nevenfo/tpA3255-hifi-amplifier/plan.md

# PLAN — Stress-test E2E KiCad MCP — Amplificateur Hi-Fi

## Objectif final

Transformer le cahier des charges en projet KiCad stéréo OPA1612/TPA3255 documenté et aussi fabricable que les preuves disponibles le permettent, principalement via `kicad-control` et son MCP, sans édition directe de `.kicad_sch` ou `.kicad_pcb`.

## Invariants

- Répondre et documenter en français ; préserver exactement noms, erreurs, commandes et chemins.
- Alimentation DC externe uniquement ; aucun secteur 230 V sur le PCB.
- Toute décision critique vient d’une source fabricant actuelle, d’un calcul explicite ou porte `NEEDS_DATA`.
- Toute opération directe sur KiCad appartient exclusivement à `kicad-control`/MCP ; aucun contournement par édition de `.kicad_sch`/`.kicad_pcb`.
- Gate ERC validé explicitement avant tout début de PCB.
- Ne jamais assimiler ERC/DRC à une validation physique de THD+N, SNR, EMI/EMC, thermique ou stabilité réelle.
- Préserver les fichiers utilisateur ; le principal seul possède Git et les checkpoints.

## Critères globaux de réussite

- Statuts séparés : SCHÉMA, PCB, ERC, DRC, CONFORMITÉ DATASHEETS, CRÉDIBILITÉ ÉLECTRONIQUE, AUTONOMIE MCP, PRÊT À FABRIQUER.
- Livrables : projet, schéma, PCB 4 couches, footprints, BOM, ERC, DRC, design review, calculs, hypothèses, limitations, `NEEDS_DATA`, benchmark MCP.
- Métriques MCP uniquement si observées dans l’état live.

# Phase A — Inspection et architecture

## A0 — Établir l’état initial et la continuité

### Objectif

Prouver l’état du workspace, de Git, de KiCad, de l’IPC/API, du MCP et de ses outils avant toute création KiCad.

### Dépendances

Aucune.

### Tâches

- [x] A0.1 Inspecter le workspace et Git sans modification.
- [x] A0.2 Créer `plan.md`, `progress.md` et un rollback Git local.
- [x] A0.3 Sonder KiCad, IPC/API, MCP et outils exposés par des opérations read-only live.
- [x] A0.4 Consigner capacités, observabilité et limitations initiales.

### Validation

Preuves live compactes ; aucune supposition fondée sur une ancienne documentation.

## A1 — Figer l’architecture électronique initiale

### Objectif

Définir architecture, budgets, gains, interfaces, rails, protections, filtres et composants critiques à partir des sources TI et de calculs traçables.

### Dépendances

A0.3.

### Tâches

- [x] A1.1 Vérifier datasheets, EVM et recommandations TI actuelles avec pages/sections.
- [x] A1.2 Établir le schéma-bloc stéréo et le rôle exact de l’OPA1612/volume/interface différentielle.
- [x] A1.3 Calculer niveaux, gains, impédances, headroom, rails et budget de puissance.
- [x] A1.4 Définir alimentation auxiliaire, séquencement, RESET/MUTE/FAULT et protections.
- [x] A1.5 Justifier filtre LC, découplages, thermique, EMI et connectique.
- [x] A1.6 Enregistrer chaque inconnue critique comme `NEEDS_DATA` et valider la revue d’architecture.

### Validation

Chaque connexion/valeur critique est sourcée ou calculée ; architecture cohérente pour 4–8 Ω et ~2 × 100 W/8 Ω.

# Phase B — Schéma KiCad

## B1 — Créer et construire le schéma par blocs

### Objectif

Porter l'architecture A1 dans un schéma KiCad complet, construit bloc par bloc et inspecté à chaque bloc, plutôt que saisi d'un trait puis débogué.

### Dépendances

A1 validée.

### Tâches

- [x] B1.1 Créer le projet via MCP et vérifier sa réouverture.
- [x] B1.2 Ajouter alimentation DC, auxiliaires et connectique.
- [x] B1.3 Ajouter entrée/volume/analogique gauche puis inspecter les nets.
- [x] B1.4 Ajouter entrée/volume/analogique droite puis inspecter les nets.
- [x] B1.5 Ajouter TPA3255, interface différentielle et contrôles puis inspecter les nets.
- [x] B1.6 Ajouter découplages, puissance, filtres LC, sorties et protections.
- [x] B1.7 Revoir références, alimentations, nets critiques et connexions inattendues.

### Validation

Schéma complet inspecté bloc par bloc via la stack et conforme à l’architecture A1.

## B2 — Retouches schématiques issues des décisions mécaniques et de protection

### Objectif

Intégrer au schéma les décisions prises après le gate C1 : déport mécanique des entrées et du volume, et renforcement de la protection d'entrée 48 V.

### Dépendances

C1 PASS ; décisions utilisateur du 2026-08-31 ; sourcing fabricant de la protection 48 V.

### Tâches

- [x] B2.1 Déporter `RV1` hors carte : ajouter un connecteur de volume, recâbler les nets et sortir `RV1` du périmètre PCB. *(Connecteur `J4` créé et nets vérifiés ; exclusion PCB faite en B2.8.)*
- [x] B2.2 Convertir les entrées `J2`/`J3` en connecteur de câblage vers RCA de châssis, avec retour de masse maîtrisé.
- [x] B2.3 Corriger `Q301` : clamp Zener de grille et résistance de grille dimensionnés pour un rail 48 V. L'anti-inversion reste une fonction distincte du hot-swap, la diode de structure d'un MOSFET N côté haut conduisant en inversion.
- [x] B2.4 Dimensionner l'étage `LM5069` sur équations de datasheet : seuils de sous-tension et de surtension avec marge sous le maximum absolu du TPA3255, résistance de shunt, limitation de puissance et temporisateur de défaut. *(Le « 65 V » d'origine était faux : `SLASEA8A` § 7.1 donne **69 V** pour `PVDD_X to GND`. Rectifié en D1.13. L'erreur était conservatrice et n'invalide aucun choix de B2.4 — la marge pire cas passe de 5,1 à 9,2 V.)*
- [x] B2.5 Vérifier la SOA du MOSFET de hot-swap pendant la charge des 15 400 µF, contre la courbe SOA de la référence retenue. *(`Q302` = `IXTK200N10L2`, SOA garantie 625 W à 75 °C contre 389 W exigés, marge 1,61 ×.)*
- [x] B2.6 Capturer le bloc `LM5069` au schéma : contrôleur, MOSFET série, shunt et réseau de programmation.
- [x] B2.8 Exclure `RV1` du circuit imprimé (attribut `on_board` à `no`) et supprimer la propriété parasite `exclude_from_board` laissée sur ce symbole. *(PASS, par le MCP seul. Le blocage consigné ici — aucun outil n'écrivait `on_board` ni ne supprimait une propriété — a été levé dans Konnect v1.1.4 : `edit_schematic_component` accepte désormais `in_bom`, `on_board` et `dnp` comme attributs natifs du bloc symbole, et `fields: {"clé": null}` retire une propriété. La correction a été faite en un appel, `RV1` adressé par `uuid`. Diff du schéma : une ligne changée, `(on_board yes)` en `(on_board no)`, et les dix lignes du `(property "exclude_from_board" "")` supprimées ; rien d'autre dans le fichier n'a bougé. ERC identique avant et après, 0 erreur et 15 avertissements, inchangé depuis la porte C2. Script rejouable : `scripts/live-b28-on-board.ps1` du dépôt Konnect.)*
- [x] B2.7 Figer `F301` et `D301` sur des références réelles, la TVS étant explicitement cantonnée aux transitoires rapides et non à la protection en surtension. *(`F301` = `Schurter UMT-H` 12,5 A `3403.0285.11` ; `D301` = `SMDJ58CA`, bidirectionnelle pour ne pas annuler l'anti-inversion.)*

- [x] B2.9 Figer `Q301` sur une référence réelle : P-MOS bloquant l'inversion à 56 V plus marge, `I_D` ≥ 12 A continus, `R_DS(on)` faible sous `V_GS` = −15 V, boîtier dissipatif. *(`IPP330P10NM`, Infineon OptiMOS TO-220-3, −100 V / 33 mΩ.)*
- [x] B2.10 Corriger le brochage de `Q301` et `Q302` : les symboles `*_GSD` déclaraient broche 2 = Source alors que les deux composants retenus ont broche 2 = Drain. Défaut invisible à l'ERC, fatal au report PCB. *(Passés en `Q_PMOS_GDS` et `Q_NMOS_GDS` ; correctif géométriquement neutre, positions de broches identiques entre variantes.)*

### Validation

Chaque ajout est sourcé sur datasheet ou calculé explicitement ; aucun seuil de sécurité posé de mémoire ; toute grandeur dépendant d'un composant non figé reste `NEEDS_DATA`. Aucune coordonnée existante déplacée ; nets vérifiés par inspection MCP.

# Phase C — Gate schématique

## C1 — ERC et revue schématique obligatoire

### Objectif

Transformer le schéma en gate explicite : tout signalement ERC est classé réel ou admis, et la Phase D reste interdite tant que le verdict n'est pas PASS.

### Dépendances

B1 validée.

### Tâches

- [x] C1.1 Exécuter ERC et archiver le résultat.
- [x] C1.2 Classer chaque erreur/avertissement et corriger les problèmes réels via MCP.
- [x] C1.3 Relancer ERC et vérifier alimentations, nets critiques, découplages et interfaces.
- [x] C1.4 Consigner explicitement PASS/FAIL du gate ; interdire Phase D si FAIL.

### Validation

Gate schématique explicite, reproductible, sans problème réel ERC non traité.

## C2 — Re-gate ERC après B2

### Objectif

Le gate C1 ne couvre plus le schéma une fois B2 appliquée ; le rejouer est obligatoire.

### Dépendances

B2 validée.

### Tâches

- [x] C2.1 Relancer ERC et comparer à la référence du gate C1 : 0 erreur / 14 avertissements.
- [x] C2.2 Traiter tout écart réel, puis consigner explicitement PASS/FAIL ; interdire la reprise de D1 si FAIL. **GATE C2 = PASS** (0 erreur / 15 avertissements : 5 mismatch librairie, 10 off-grid ; `reports/ERC_C2_gate_final-2026-08-31.json`).

### Validation

Gate schématique de nouveau explicite et reproductible sur le schéma modifié.

# Phase D — Footprints

## D1 — Attribuer et valider les empreintes

### Objectif

Donner à chaque symbole une empreinte réelle et vérifiée, condition sans laquelle aucun placement n'a de sens.

### Dépendances

C2 PASS.

### Tâches

- [x] D1.1 Associer chaque composant à une empreinte compatible et disponible. *(PASS. **Plus aucun composant du schéma n'est sans empreinte.** Les cinq `PWR_FLAG` n'en requièrent pas, et `RV1` est volontairement hors carte, voir B2.1 et B2.8. Vérifié en itérant sur les blocs `(symbol` de premier niveau du fichier, et non par le MCP. Toutes les empreintes de librairie ont été contrôlées présentes sur disque.)*
- [x] D1.5 Assigner les passifs du bloc de protection ajoutés en B2. *(PASS. `R305` à `R310`, `C325`, `C326` et `D302` assignés et vérifiés au fichier ; ERC inchangé, 15 warnings et 0 erreur, identique à la porte C2. Trois corrections ont été nécessaires sur le travail initial : la référence `MKS2C044701O00KSSD` de `C325` **n'existe pas**, remplacée par `MKS2B044701K00KSSD` ; son empreinte est passée de `W11.0mm` à `W7.2mm` ; `C326` est passé de `100nF` à `100nF/250V`. `D302` = `BZT52C15` lève son `NEEDS_DATA`. Détail et justifications : `docs/protection-48v.md`, section « Passifs du bloc de protection ».)*
- [x] D1.4 Créer les empreintes locales manquantes et choisir la connectique déportée. *(PASS. Connectique tranchée par l'utilisateur : **JST XH au pas de 2,5 mm**, vertical par défaut, l'orientation définitive relevant du placement en Phase E. `J2` et `J3` en `JST_XH_B2B-XH-A_1x02`, `J4` en `JST_XH_B6B-XH-A_1x06` ; nombre de broches confirmé 2/2/6. Ce qui décide est le détrompage de `J4`, dont le faisceau à six conducteurs rebranché à l'envers donnerait une panne silencieuse. Empreinte locale `Fuse_Schurter_UMT-H_5.3x16mm` créée pour `F301` et cotée sur le dessin d'implantation Schurter ; réserves graphiques suivies en D1.8.)*
- [x] D1.2 Vérifier boîtiers fabricant, orientations, courants, connecteurs et contraintes d’assemblage. *(PASS. **Vérifiés à la source et conformes** : `Q301` `IPP330P10NM`, PG-TO220-3, brochage 1 = Gate / 2 = Drain-semelle / 3 = Source, datasheet servie par le serveur Infineon, chiffres thermiques relus et deux conditions d'implantation ajoutées à `docs/protection-48v.md` ; `Q302` en TO-264-3 au pas de 5,45 mm et `Q301` en TO-220-3 au pas de 2,54 mm, les deux empreintes KiCad étant aux pas normalisés, l'orientation verticale restant compatible d'un montage sur radiateur et le choix définitif dépendant du `NEEDS_DATA` dissipateur ; `U8` `LM5069-2` en `MSOP-10_3x3mm_P0.5mm`, correct — la datasheet TI ne donne le composant qu'en VSSOP-10 (DGS) 3 × 3 mm **sans pad exposé**, et KiCad n'a pas d'empreinte `VSSOP-10`, l'équivalent normalisé étant bien MO-187 variation BA. À noter pour H2 : la référence commandable est `LM5069MM-2/NOPB`, absente du schéma. **Défauts ouverts issus de cette tâche** : D1.9 (films 680 nF) et D1.10 (inductances). **Bulks instruits en D1.11, inductances en D1.10, films en D1.9.** **Dernier point clos : le bornier `J1`.** Le dessin fabricant de CIXI MAIXU (`MX126-5.0-XXP`, planche du 14/09/2022) a fini par être obtenu : `www.lcsc.com` et `datasheet.lcsc.com` refusent `curl`, mais **`wmsc.lcsc.com` sert le fichier**. Il n'a aucune couche texte — c'est un plan vectoriel sans texte extractible — et `pdftoppm` n'est pas installé ; il a donc été **rendu en PNG à 200 dpi par `pymupdf` puis lu comme une image**. Il donne **300 V / 10 A en calibre UL et 250 V / 15 A en calibre IEC**, tenue 2000 VAC pendant 1 min, plage de fil **26 à 14 AWG, soit 0,5 à 2,5 mm²**, service de −40 à +105 °C. Les 4,6 A continus passent avec un facteur 2,2 sur le calibre UL, et les 10 A transitoires restent sous le calibre IEC. **L'empreinte est confirmée à la source** : le plan d'implantation impose un perçage de ø1,30 mm au pas de 5,00 mm, ce que `TerminalBlock_MaiXu_MX126-5.0-02P_1x02_P5.00mm` reprend exactement. **Contrainte d'assemblage à porter** : le câble d'alimentation doit rester entre 0,5 et 2,5 mm².)*
- [x] D1.6 Corriger l'annotation des cinq `PWR_FLAG`. *(PASS. Annotés `#FLG01` à `#FLG05` ; `#PWR001`, sixième `PWR_FLAG` préexistant, non touché. Plus aucun symbole ne porte `?`. **Le MCP sait adresser un symbole par `uuid`**, paramètre alternatif à `reference` d'`edit_schematic_component` : c'est ce qui a levé l'ambiguïté des cinq repères identiques. Le défaut était plus grave que consigné : les `PWR_FLAG` non annotés étaient exportés au netlist comme **six composants réels nommés `?`**, que « Update PCB from schematic » aurait tenté de placer sur la carte, sans empreinte. Après correction ils en sont exclus, comme tout symbole à préfixe `#`. Preuve : netlist exporté avant et après, 74 nets inchangés, aucun net créé ni supprimé, et les seuls nœuds retirés sont les cinq `?.1` sur `/+12V-OA`, `/PVDD`, `/GND`, `/+15V` et `/BUCK_VIN` ; ERC inchangé à 15 warnings et 0 erreur, et `kicad-cli` ne signale plus « erreurs de numérotation ».)*
- [x] D1.7 Confirmer sur le dessin coté WIMA l'encombrement du film `C325`. *(PASS, et **la réserve était fondée deux fois : la cote supposée était fausse, et la référence l'était aussi.** Catalogue WIMA extrait et lu : au pas de 5 mm, la cote constante de la série MKS2 est la **longueur** `L` = 7,2 mm, jamais l'épaisseur ; les tableaux donnent les boîtes en `W × H × L` et le 4,7 µF mesure `W` = 11 mm, `H` = 18 mm, `L` = 7,2 mm, sous 63 V comme sous 100 V. L'empreinte était donc trop étroite de 3,8 mm et le composant n'y serait pas entré. Le décodage de la clé de référence WIMA a de plus retourné la conclusion de D1.5 : **les champs 11-12 codent la boîte et le pas, le champ 15 seul code la tolérance.** Le `O` de `MKS2C044701O00KSSD` appartient au code de boîte `1O` et n'a jamais été un code de tolérance. La référence écartée en D1.5 comme inventée est donc la bonne, et c'est sa remplaçante qui n'existe pas : `MKS2B044701K00KSSD` cumule un `B0` qui n'est pas un code de tension WIMA — la MKS2 va de 63 à 630 VDC sans aucun calibre 50 V — et une boîte `1K` de 7,2 × 13 mm qui ne loge que 2,2 µF. `C325` reprend `MKS2C044701O00KSSD`, Value `4.7uF/63V`, empreinte `Capacitor_THT:C_Rect_L7.2mm_W11.0mm_P5.00mm_FKS2_FKP2_MKS2_MKP2` de la librairie standard — aucune empreinte locale nécessaire. Écriture MCP relue au fichier par le principal, position inchangée, ERC toujours à 15 warnings et 0 erreur. La marge de démarrage × 1,41 est conservée : le ± 10 % est catalogué, seule la tension nominale passe de 50 à 63 V. Détail : `docs/protection-48v.md`.)*
- [x] D1.9 Qualifier les quatre films `680 nF` du filtre de sortie, puis corriger leur empreinte. *(PASS. **Le pas de 5 mm était faux autant que l'épaisseur.** La nomenclature du `TPA3255EVM` (`SLOU441`, p. 14) tranche d'abord le diélectrique : l'EVM équipe ce poste d'un **`PHE426HB7100JR06` KEMET, film polypropylène, 1 µF / 250 V au pas de 17,5 mm**. Le catalogue WIMA `MKP4` a ensuite été extrait et lu : il **contredit l'idée qu'un MKP n'existerait pas sous 250 V** — la série se catalogue dès 100 VDC — et donne pour 0,68 µF **une boîte `4F` de 8 × 15 × 18 mm au pas de 15 mm, identique en 100 et en 250 VDC**, références `MKP4D036804F00` et `MKP4F036804F00`. Le calibre supérieur étant sans coût mécanique, **250 V retenu** : la marge sur les 100 V exigés par TI est gratuite. Les quatre condensateurs passent à `Capacitor_THT:C_Rect_L18.0mm_W8.0mm_P15.00mm_FKS3_FKP3` — empreinte de la librairie standard dont la description renvoie elle-même au catalogue WIMA — et leur `Value` à `680nF/250V MKP`. Écriture MCP relue au fichier par le principal, positions inchangées, ERC toujours à 15 violations et 0 erreur, jeu de messages identique. **Le choix de 680 nF face au 1 µF de l'EVM est confirmé sain** : avec 15 µH il donne 49,8 kHz de coupure contre 50,3 kHz pour le couple 10 µH / 1 µF de l'EVM, pour une impédance caractéristique de 4,7 Ω au lieu de 3,16 — mieux adaptée à des charges de 4 à 8 Ω. Les quatre derniers caractères de la référence WIMA, tolérance et conditionnement, restent à figer en H2 : la clé n'a pas été relue pour cette série. **L'empreinte locale `CF_Film_Box_P5.00mm_7.2x3.5mm`, devenue sans utilisateur, est supprimée** ; la librairie locale ne contient plus que le fusible et son entrée `fp-lib-table` reste justifiée. **Contrainte Phase E : la boîte passe de 7,2 × 3,5 à 18 × 8 mm sur 15 de haut, courtyard de 18,5 × 8,5 mm, quatre fois.**)* **Défaut prouvé, même mode de défaillance que D1.7 : une cote supposée, jamais lue.** `C321` à `C324` portent `CF_Film_Box_P5.00mm_7.2x3.5mm`, soit 3,5 mm d'épaisseur de corps. Or le condensateur de filtre est référencé à `GND` en aval de chaque demi-pont et voit donc tout le rail, et TI exige explicitement un calibre 100 V pour une alimentation de 51 V. Au pas de 5 mm, une boîte de 3,5 mm ne loge que 0,15 à 0,22 µF sous 100 V ; le 680 nF sous 100 V mesure 5 × 10 × 7,2 mm. L'empreinte est donc impossible quelle que soit la référence finalement retenue. **Ne pas la remplacer par une nouvelle supposition** : la référence reste `NEEDS_DATA`, et le diélectrique est le premier point à trancher — un filtre de sortie Class-D relève du polypropylène (MKP) et non du polyester (MKS), pour le `dV/dt` et les pertes, ce qui peut aussi déplacer le pas. Une fois la référence figée, prendre le membre correspondant de la famille standard `Capacitor_THT:C_Rect_L7.2mm_W*_P5.00mm_FKS2_FKP2_MKS2_MKP2`, qui couvre 2,5 à 11 mm d'épaisseur.
- [x] D1.8 Corriger les graphiques de l'empreinte locale du fusible. **Volet film clos en D1.9** : l'empreinte locale redondante a été supprimée, il ne reste que le défaut cosmétique du fusible. **Périmètre réduit, et le point ne demande plus d'arbitrage utilisateur pour que le projet avance.**
  - `CF_Film_Box_P5.00mm_7.2x3.5mm` **sort du périmètre**. La librairie KiCad standard contient déjà `C_Rect_L7.2mm_W3.5mm_P5.00mm_FKS2_FKP2_MKS2_MKP2` — même corps 7,2 × 3,5 mm au pas de 5 mm, courtyard correct de 7,7 × 4,0 mm là où le local n'en déclare que 7,6 × 2,6. L'empreinte locale était donc **redondante dès sa création**, et le courtyard sous-dimensionné n'a jamais eu à être corrigé, seulement abandonné. Elle n'a plus d'utilisateur légitime (D1.9) et sera supprimée à la fermeture de D1.9, sans aucune édition de graphiques.
  - `Fuse_Schurter_UMT-H_5.3x16mm` reste locale et justifiée : le seul candidat standard, `Fuse:Fuse_Schurter_UMT250`, vise un corps de 3 × 10,1 mm avec pastilles à ± 4,25 mm, sans rapport avec les ± 6,875 mm du UMT-H. Son défaut résiduel est **purement cosmétique** — repère de broche 1 sur un composant non polarisé, cercle de sérigraphie hors courtyard à `x = −9,3`, sérigraphie à 0,15 mm des pastilles au lieu de 0,2 — alors que cuivre, pâte, masque et courtyard sont exacts. Sans effet sur le DRC ni sur la fabrication. Reporté sans blocage, à traiter si une version du MCP expose l'édition des graphiques. — **PASS.** Le report n'avait plus lieu d'être : **l'outil `set_footprint_graphics` existe bel et bien** dans le MCP, et la note « aucun outil n'édite les graphiques après coup » était fausse. Deux défauts corrigés : le repère de broche 1, supprimé, qui n'avait pas de sens sur un composant non polarisé et tombait de surcroît hors courtyard à `x = −9,3` ; et la sérigraphie, qui encadrait l'**enveloppe des pastilles** au lieu du **corps**, ramenée à deux segments horizontaux `x ∈ [−4,70 ; 4,70]` à `y = ±2,675`. Le `F.Fab` suit désormais le corps réel `±7,70 × ±2,675`, sans le chanfrein de broche 1. **Vérifié au fichier par le principal, pas sur rapport d'agent** : dégagement sérigraphie-pastille de **0,240 mm** contre 0,20 exigés par les KLC, aucun élément hors courtyard `±9,00 × ±3,05`, pastilles / pâte / masque / courtyard / `descr` rigoureusement inchangés, champ Footprint de `F301` intact. **Preuve indépendante du MCP** : `kicad-cli fp export svg` trace les deux empreintes locales sans avertissement.

  - **Nuance sur la leçon D1.10, qui ne se généralise pas.** Donner au générateur les cotes justes du corps a corrigé le `F.Fab` mais **pas** la sérigraphie : `create_footprint` la dérive de l'enveloppe des pastilles, laquelle déborde ici le corps de 1,05 mm de chaque côté puisque les pastilles dépassent en bout pour le congé. Sur une empreinte dont les pastilles sont plus larges que le corps, le générateur produit donc une sérigraphie non conforme quelles que soient les cotes fournies, et il faut la reprendre par `set_footprint_graphics`.
- [x] D1.11 Requalifier les six condensateurs de bulk. *(PASS. **Défaut prouvé et corrigé sur `C312` à `C315`, empreinte validée sur `C316`/`C317`.** Source primaire : la nomenclature du kit d'évaluation TI `TPA3255EVM` (`SLOU441`, p. 14), qui est l'ancre déclarée du bulk dans `docs/architecture.md`.*
  - *`C312` à `C315`, 1500 µF/63 V : la BOM donne pour ce poste `EEU-FC1J152` Panasonic, boîtier **diamètre 18 mm**. L'empreinte portée était `CP_Radial_D16.0mm_P7.50mm`, soit **2 mm de trop peu en diamètre**, quatrième empreinte posée sur une cote supposée après D1.7, D1.9 et D1.10. Corrigée en `Capacitor_THT:CP_Radial_D18.0mm_P7.50mm`, membre de la librairie standard, pas inchangé à 7,5 mm. Écriture MCP relue au fichier par le principal, positions inchangées, ERC inchangé à 15 violations et 0 erreur. Le courtyard passe de 16,16 à 18,16 mm : **+2 mm sur chacun des quatre**, à reporter en Phase E. Hauteur nominale 35 mm.*
  - *`C316`/`C317`, 4700 µF/80 V : empreinte `CP_Radial_D35.0mm_P10.00mm_SnapIn` **confirmée juste**, par trois preuves indépendantes. La BOM donne `SLPX472M080H3P3` Cornell Dubilier en « D35 mm × L30 » ; la clé de référence CDE type SLP, décodée sur le catalogue `SLP.pdf` p. 2 (lettre de diamètre H = 35 mm, chiffre de longueur 3 = 30 mm), redonne bien ø35 × 30 ; et le diagramme « PC Board Mounting Holes » du même catalogue impose **pas 10,0 mm et deux perçages ø2,0 ± 0,1**, identiques au diagramme Vishay 058 PLL-SI. **Le perçage de 2,0 mm de l'empreinte KiCad n'est donc pas un jeu nul sur une broche de 2,0 mm : c'est la cote de perçage prescrite par les deux fabricants**, et toute la famille `CP_Radial_D*_P10.00mm_SnapIn` la reprend.*
  - *Deux réserves consignées, aucune bloquante. Le pas de 7,5 mm du ø18 n'a pas pu être relu chez Panasonic : `industrial.panasonic.com` ne répond pas du tout à `curl` (timeout, pas un refus). Il est **inchangé** par rapport à l'empreinte précédente, donc la correction ne substitue pas une supposition à une autre, mais il reste à confirmer. Et `SLPX472M080H3P3` n'apparaît pas dans le catalogue SLP courant, qui donne à 80 V `SLP472M080E4P3` en 30 × 45 et `SLP472M080H5P3` en 35 × 35 : `SLPX` est une série voisine ou antérieure. **Les deux MPN restent des candidats d'ancrage et ne sont pas inscrits au schéma** tant que la clé du fabricant n'est pas décodée, conformément à la leçon de D1.7.*

- [x] D1.10 Requalifier l'empreinte des quatre inductances de sortie `L301` à `L304`. *(PASS, **et la réserve énergétique était fondée**. La BOM du `TPA3255EVM` donne `MA5172-AE` Coilcraft pour ce poste, et sa datasheet — document Coilcraft 943, `https://www.coilcraft.com/pdfs/ma5172.pdf` — catalogue dans la même famille **`PA6331-AE` : 15 µH, DCR 31 mΩ, `I_sat` 20 A, `I_rms` 9,8 A à 20 °C d'échauffement et 14,2 A à 40 °C**, soit exactement le cahier des charges de `docs/architecture.md`, sur une pièce conçue pour les étages Class-D TI. **Retenue sur arbitrage utilisateur.** Elle confirme au passage que le `HCI-1350` était hors de cause : là où le boîtier supposé mesurait 12,8 × 12,8 × 4,7 mm, la pièce réelle est un **tore traversant debout de ø28,6 × 12,3 mm**. **Le tracé de la datasheet n'est pas à l'échelle** : mesuré sur les vecteurs du PDF, la vue de face donne 2,836 pt/mm et la vue de profil 2,463, 15 % d'écart ; les étiquettes font foi, comme chez Schurter. Elles donnent un entraxe de **10,0 ± 0,5 mm** et des broches de 0,96 à 1,07 mm. **Aucune empreinte standard ne convient** : `L_Toroid_Vertical_L28.6mm_W14.3mm_P11.43mm_Bourns_5700` a la bonne longueur mais un entraxe de 11,43 mm, hors tolérance de 1,43 mm ; `L_Toroid_Vertical_L26.7mm_W14.0mm_P10.16mm_Pulse_D` a le bon pas mais un courtyard trop court de 1,9 mm. **Deuxième empreinte locale justifiée du projet** : `L_Toroid_Vertical_L28.6mm_W12.3mm_P10.00mm_Coilcraft_PA6331`, créée par le MCP et **relue au fichier par le principal**. Contrairement à `CF_Film_Box`, les graphiques imposés par `create_footprint` sont **corrects** : courtyard à ± 14,55 en X et − 1,55 à 11,55 en Y, soit 0,25 mm autour de l'élément le plus extérieur — les pastilles, non le corps — et sérigraphie à 0,15 mm hors du corps, sans recouvrir les pastilles. Ce sont les conventions KLC, et elles valent mieux que les cotes plus grossières que le principal avait commandées. **La leçon de `CF_Film_Box` se précise : le générateur n'était pas en cause, les cotes qu'on lui donnait l'étaient.** `Value` portée à `15uH/20A`, ERC toujours à 15 violations et 0 erreur. Le `NEEDS_DATA` sur l'inductance tombe. Reste à vérifier en H2 que la référence est toujours approvisionnable.)* Elles portent `Inductor_SMD:L_Wuerth_HCI-1350` **sans MPN**, alors que l'inductance 15 µH est `NEEDS_DATA` : troisième empreinte posée sur une supposition, après D1.7 et D1.9. Le corps HCI-1350 ne fait que 12,8 × 12,8 × 4,7 mm. Point de mesure lu à la source, sur la référence même que cite l'empreinte KiCad (`744355019`) : dans ce corps, la série donne 0,19 µH à `I_SAT,10%` = 60 A, soit une énergie stockée de 342 µJ. Or le cahier des charges — 15 µH avec `I_sat` ≥ 10 A — en réclame 750 µJ, plus du double. L'énergie étant d'abord une propriété du volume et du matériau de noyau, **le boîtier 1350 est très probablement trop petit** ; c'est une déduction sur un seul point de mesure, à confirmer quand la référence sera figée, mais elle suffit à ne pas traiter cette empreinte comme acquise. Prévoir un corps plus grand et son impact sur le placement en Phase E.
- [x] D1.12 Rendre `fp-lib-table` portable. *(PASS. La librairie locale y était déclarée par un **chemin absolu Windows**, `C:\Users\FlowUP\Documents\...` : un clone du dépôt sur une autre machine, ou un simple déplacement du projet, aurait cassé la résolution des deux empreintes locales sans avertissement. Remplacé par `${KIPRJMOD}/HifiAmp_TPA3255_Local.pretty`. **`sym-lib-table` utilisait déjà `${KIPRJMOD}`** : la convention du projet était donc établie et l'incohérence isolée à ce seul fichier. Que KiCad résolve bien cette variable dans ce projet est prouvé par l'ERC lui-même, qui charge le symbole local `LM5069` déclaré de la même façon. Sauvegarde de l'original conservée le temps de la session.)*
- [x] D1.3 Vérifier particulièrement HTSSOP TPA3255, PowerPAD et stratégie de vias thermiques. *(PASS, **et la tâche se retourne : il n'y a pas de vias thermiques à concevoir sous le TPA3255**. `U6` portait `HTSSOP-44-1EP_6.1x14mm_P0.635mm_EP5.2x14mm_Mask4.31x8.26mm`, **empreinte d'un autre boîtier** : elle est taguée `Texas_DDW0044B` et pose une 45ᵉ pastille de 5,2 × 14 mm **sous** le composant. Or le TPA3255 est en `DDV0044D`, et la datasheet (`SLASEA8A`, p. 3) est explicite : *« The package type contains a PowerPAD that is located **on the top side of the device** for convenient thermal coupling to the heat sink »*. Le tableau des broches ajoute, pour le PowerPAD : *« Ground, connect to grounded heat sink »*. Le plan cothé (4218830/A, p. 44) donne un pad exposé de **6,72 à 7,30 mm sur 3,85 à 4,43 mm**, soit 7,01 × 4,14 nominal — et non 5,2 × 14 — tandis que le land pattern TI (p. 45) ne montre que **44 pastilles**, sans rien à braser dessous. Corrigé en `Package_SO:HTSSOP-44_6.1x14mm_P0.635mm_TopEP4.14x7.01mm`, taguée `Texas_DDV0044D`, 44 pastilles, pad thermique dessiné sur le dessus aux cotes nominales exactes. Écriture MCP relue au fichier par le principal, ERC toujours à 15 violations et 0 erreur. **La preuve chiffrée vient du tableau thermique 7.4 : `RθJC(bot)` est donné `n/a`** — TI ne caractérise même pas la voie par le dessous — alors que `RθJA` tombe de **50,7 à 2,4 °C/W** dès qu'un dissipateur est fixé sur le dessus, facteur 21, la note précisant que *« only path for dissipation is to the heatsink »*. **Le `NEEDS_DATA` annonçant un EP de 5,2 × 14 mm à confirmer est donc infirmé, pas confirmé**, et le `NEEDS_DATA` dissipateur devient le point dimensionnant unique du thermique du TPA3255. **Écart connu et voulu à reporter en Phase E** : le symbole compte 45 broches, la broche 45 étant `EP_45` câblée à `GND` — ce qui est correct au sens de TI — alors que l'empreinte n'a que 44 pastilles. L'import PCB signalera une broche sans pastille : c'est **attendu**, la mise à la masse du PowerPAD passant par le dissipateur, hors PCB. Au passage, le tableau des conditions recommandées confirme `L_OUT(BTL)` ≥ 5 µH, que les 15 µH de D1.10 satisfont largement.)*

- [x] D1.13 Trancher la fenêtre de tension où le TPA3255 travaille hors spécification. **Relevé en D1.3, non instruit.** Le tableau des conditions recommandées distingue deux plafonds selon la charge : `PVDD` va jusqu'à **51 V typique et 53,5 V maximum sous 4 Ω**, mais jusqu'à 53,5 V typique et 56,5 V maximum sous ≥ 6 Ω, et seulement *« provided a reduced over-current threshold is set »*. Or le projet vise **4 à 8 Ω**, et le seuil de coupure haute du `LM5069` est réglé à **56,4 V** (`docs/protection-48v.md`). **Il existe donc une fenêtre de 53,5 à 56,4 V dans laquelle une charge de 4 Ω est alimentée au-dessus du maximum absolu du TPA3255 sans que la protection ne coupe.** Le raisonnement actuel — le plafond n'est pas fixé par le TPA3255 puisque `Q302` l'isole en surtension — ne couvre pas cette bande. Trois issues à peser : abaisser `V_OVH` vers 52 V, restreindre la charge admissible à ≥ 6 Ω, ou démontrer que l'alimentation externe retenue ne peut pas atteindre 53,5 V. **Dépend du `NEEDS_DATA` alimentation externe 48 V.** Arbitrage utilisateur probable. — **CLOS.** Deux rectifications d'abord : 53,5 V est une borne de *conditions recommandées* et non un maximum absolu, le maximum absolu `PVDD_X to GND` valant **69 V** (`SLASEA8A` § 7.1) et non les 65 V écrits dans `docs/protection-48v.md`, désormais corrigés ; et la bande incriminée se situe donc **12,6 V sous la destruction**, la limite franchie portant sur le courant de sortie, pas sur la tenue en tension. Ensuite, **l'issue « abaisser `V_OVH` » est arithmétiquement impossible** : garantir ≤ 53,5 V au pire cas impose un nominal ≤ 50,5 V, dont la borne basse tombe à 49,5 V — sous les 50,4 V d'un rail 48 V à +5 % — et dont la reprise, hystérésis déduite, tomberait entre 43,8 et 47,2 V, empêchant tout redémarrage ; la fenêtre à couvrir vaut ± 3 % contre ± 6 % de dispersion spécifiée du seuil. **Le `LM5069` ne peut donc pas faire respecter les conditions recommandées du TPA3255**, seulement protéger d'un défaut d'alimentation. **Issue retenue sur arbitrage utilisateur : borner l'alimentation par spécification, charge 4 Ω conservée, aucun composant modifié.** Exigence `REQ-PSU-1` inscrite dans `docs/architecture.md` : sortie ≤ 53,5 V en toutes conditions, soit 3,1 V de marge pour une alimentation régulée à ± 5 %. Résidu assumé et tracé : une panne d'alimentation dans la bande 53,5–56,4 V ne serait coupée par rien, l'`OCP` en CB3C et l'`OTW`/`OTSD` restant seuls actifs.
- [x] D1.14 Instruire les cinq `lib_symbol_mismatch` et les symboles reliquats. *(PASS. **Diagnostic livré, et il est rassurant : aucun écart de brochage.** Les deux copies de chacun des cinq symboles — celle du cache `lib_symbols` du schéma et celle du `.kicad_sym` — ont été comparées par **égalité d'arbre S-expression**, après neutralisation du seul nom racine, qui porte le préfixe de librairie dans le cache. Résultat : `LM5010ASD` 330 feuilles, `LM2940IMP_12_FIXED` 169, `TPS3802K33` 192, `LM5069` 307, `TPA3255B` 1112 — **identiques des deux côtés, feuille à feuille**. Numéros, noms, types électriques et positions de broches concordent. **Aucune vérification antérieure n'est donc remise en cause**, ce qui était la question de fond. L'avertissement ne porte sur aucune divergence de contenu entre les deux fichiers. **Piste de la version de format testée et infirmée** : le schéma est en `20250610` et la librairie en `20240108`, toutes deux écrites par `konnect` ; migrer une copie de la librairie par `kicad-cli sym upgrade --force` — KiCad y ajoute `exclude_from_sim`, `in_pos_files`, `show_name`, normalise `Datasheet` de `~` à vide, et la taille passe de 17 744 à 28 263 octets, les 6 symboles et 79 broches étant conservés — puis relancer l'ERC laisse **exactement les mêmes 15 violations**. La copie migrée a donc été abandonnée et la librairie restaurée par `git checkout`. **Conclusion : les cinq avertissements sont cosmétiques et restent dans la baseline C2**, qui demeure à 15 violations et 0 erreur. Une dernière piste existe — faire réécrire le cache du schéma lui-même par KiCad — mais elle fait passer un outil de migration sur le cœur du projet, dont la connectivité repose sur la coïncidence label/ancre, pour un gain purement cosmétique : **non retenue sans arbitrage utilisateur**. **Reliquats confirmés inutilisés** : `TPA3255DDV`, `TPA3255DDV_TEST` et `TPA3255` dans le cache, `LM2940IMP-12` dans la librairie, **zéro `lib_id` les référençant**, quand les cinq symboles utiles ont exactement une instance chacun. Ils ne sont pas supprimés : retirer des entrées du cache demanderait d'éditer directement le `.kicad_sch`, et KiCad les nettoie de lui-même à la première sauvegarde depuis l'interface.)* **Relevé en D1.3.** Les cinq avertissements sont un tiers de la baseline C2 et portent tous sur des symboles de la librairie locale : `LM5010ASD`, `LM2940IMP_12_FIXED`, `TPS3802K33`, `LM5069`, `TPA3255B`. Un `lib_symbol_mismatch` signifie que la copie embarquée dans le schéma diverge de la librairie ; **l'écart peut être anodin, un champ de propriété, ou grave, un brochage** — ce n'est pas tranché, donc la baseline repose sur cinq inconnues. À diagnostiquer symbole par symbole, en comparant broche à broche. Deux reliquats à traiter dans le même mouvement : le cache `lib_symbols` du schéma contient encore `TPA3255DDV`, `TPA3255DDV_TEST` — deux broches, manifestement un essai — et `TPA3255`, **qui n'existent plus dans le `.kicad_sym`** et que plus aucun composant n'utilise ; et la librairie garde `LM2940IMP-12` alors que `U2` est passé à `LM2940IMP_12_FIXED`. Ne rien supprimer avant d'avoir montré qu'aucun symbole n'y renvoie.

### Validation

Toutes les empreintes sont attribuées et revues contre leurs sources fabricant.

# Phase E — PCB 4 couches

## E1 — Définir stack-up, règles et placement

### Objectif

Fixer la matière de la carte — quatre couches, règles, classes de nets — puis y poser les composants dans l'ordre où les contraintes physiques les imposent : puissance et thermique d'abord, analogique bas niveau ensuite.

### Dépendances

D1 validée.

### Tâches

- [x] E1.1 Créer le PCB 4 couches et documenter stack-up/règles/classes de nets. *(PASS. Quatre couches cuivre — `F.Cu` signal, `In1.Cu` power, `In2.Cu` mixed, `B.Cu` signal — sur une carte de 1,6 mm. Huit classes de nets et **71 affectations**, sans doublon, dimensionnées sur IPC-2221 à 35 µm et 10 °C d'échauffement. Règles globales conservatrices, le fabricant n'étant pas choisi : 0,20 mm de piste et d'isolation, via ø0,60, perçage 0,30, anneau 0,15. **Contour de carte délibérément non tracé** : il dépend du dissipateur et du boîtier, encore en `NEEDS_DATA`. **Vérifié par le principal au fichier** : les quatre couches sont là, le bloc `setup` ne contient que `pad_to_mask_clearance`, zéro empreinte, `Edge.Cuts` vide, et `kicad-cli pcb drc` charge le fichier en ne remontant que `invalid_outline` — l'absence de contour, donc la condition voulue. Détail des classes : `docs/architecture.md`, section « Règles et classes de nets posées en E1.1 ».)*
  - **Incident MCP, consigné dans `reports/MCP_BUG-setup-tokens-kicad-pcb.md`.** `set_design_rules` écrit `min_clearance`, `min_track_width`, `min_via_drill` et `min_via_size` dans le bloc `(setup ...)` du `.kicad_pcb`, où ces jetons **n'existent pas** dans le format ; `set_active_layer` y ajoute `active_layer`, tout aussi invalide. Le fichier devient illisible par KiCad — *« Inattendu active_layer en ligne 32 »* — **sans qu'aucun retour d'outil ne signale l'échec**, et aucun des 203 outils du MCP ne sait nettoyer le bloc. Récupéré par `git checkout` du seul `.kicad_pcb`, sans risque puisqu'il était vide de toute connectivité. **Ces deux outils sont désormais proscrits sur ce projet** ; les règles globales se posent dans le `.kicad_pro`, sous `board.design_settings.rules`, où `set_design_rules` n'avait appliqué que deux des quatre valeurs demandées.
  - **Réserve reportée** : aucun outil MCP n'expose l'épaisseur de cuivre par couche. Le `.kicad_pcb` ne porte pas de bloc `stackup` explicite et KiCad applique son défaut. À rendre explicite dans Board Setup et sur la commande au fabricant avant les livrables de fabrication.
- [x] E1.2 Placer puissance Class-D, bootstrap/découplages/bulk et thermique. *(PASS. Le placement des 21 empreintes de puissance est clos par les deux perçages M3 de fixation de la barre, H1 en `(285, 163)` et H2 en `(285, 187)`, entraxe 24 mm, motif validé par l'utilisateur avant perçage.)*
  - **Débloquée.** Les trois arbitrages de E1.7 sont rendus et consignés dans `docs/architecture.md`, section « Arbitrages rendus, et contour qui en découle » : coffret Modushop `03/300` 3U, carte à plat avec `U6` en bord de carte relié au flanc par une barre aluminium courte et massive, isolation électrique reportée à la jonction barre/flanc. Contour arrêté à **200 × 150 mm**.
  - **Étape 1 franchie — contour et import.** `Edge.Cuts` porte le rectangle 200 × 150 mm, coins `(100,100)`–`(300,250)`. Les **122 empreintes** sont importées avec leur connectivité : 122 références distinctes, aucun doublon, **74 nets**, 327 pastilles sur 332 portant un net. `RV1` reste volontairement absente, faute d'empreinte assignée. **Vérifié au fichier par le principal** et par `kicad-cli pcb drc` : `schematic_parity` vaut **0** — la carte est le miroir exact du schéma — et `invalid_outline` a disparu. Les 391 violations et 253 non-connectés restants sont l'état normal d'avant placement : empreintes empilées au point d'import, aucune piste tracée.
  - **Étape 2 franchie — bloc de puissance placé.** 21 empreintes posées aux coordonnées imposées : `U6` en `(285, 175)` à **rotation 180°**, ses quatre bootstrap `C306`–`C309`, les deux découplages `PVDD` `C310`/`C311` en 1210, les huit découplages du côté bas niveau `C301`–`C305`/`C318`–`C320`, et le bulk `C312`–`C317`. **Vérifié au fichier par le principal**, indépendamment du rapport d'agent : l'empreinte MD5 du `.kicad_pcb` a changé — donc l'enregistrement a bien eu lieu —, les 21 positions et angles relus sont **exacts au micron**, les 101 autres empreintes n'ont pas bougé d'un pas, le total reste à 122 sans doublon et le contour est intact. `kicad-cli pcb drc` : les violations tombent de **391 à 137**, `schematic_parity` reste à **0**, et les 253 non-connectés sont inchangés puisque rien n'est routé.
  - **Choix de rotation, et sa raison.** Les deux flancs du `HTSSOP-44` ne sont pas interchangeables : côté `x < 0` du symbole se trouve tout le bas niveau, côté `x > 0` toute la puissance — six `PVDD`, `OUT_A`–`D`, quatre `BST`, six `GND`. La rotation 180° tourne donc la puissance vers l'intérieur de la carte, où vivent le bulk et le futur filtre LC, et laisse le bas niveau échapper vers la lisière droite. Conséquence mécanique tirée au passage : **la barre de liaison est dressée**, 10 mm d'épaisseur dans le plan de la carte pour 60 de hauteur, ce qui préserve les 600 mm² de section mais réduit son ombre sur la carte à une bande de 10 mm sans aucun site de composant. Détail et réserve dans `docs/architecture.md`, section « E1.2 — le placement retourne la section de la barre ».
  - **Étape 3 franchie — E1.2 close par les deux perçages M3.** `H1` en `(285.000, 163.000)` et `H2` en `(285.000, 187.000)`, entraxe 24 mm, encadrant `U6` perpendiculairement à l'axe de la barre ; **motif validé par l'utilisateur** avant perçage, contre les deux variantes proposées (30 mm, ou trois points de serrage). Empreintes `MountingHole:MountingHole_3.2mm_M3`, `F.Cu`, rotation 0, sans net ni symbole au schéma.
  - **Deux défauts de l'outil `add_mounting_hole`, relevés et corrigés.** L'outil MCP en mode fichier forge en dur le `fpid` `MountingHole:MountingHole_3.2mm`, **qui n'existe pas** dans la bibliothèque système — seul `MountingHole_3.2mm_M3` y figure —, et surtout il écrit `(size 3.7 3.7)` pour un `(drill 3.2)` sur `*.Cu` : un `np_thru_hole` dont la taille dépasse le perçage porte **un anneau de cuivre flottant de 0,25 mm sur toutes les couches**, précisément là où la vis et la barre d'aluminium nu viennent serrer. Le second défaut avait échappé au rapport d'agent et n'a été vu qu'à la relecture du fichier par le principal. Correction par `place_component` en IPC avec l'empreinte réelle de bibliothèque, qui pose `(size 3.2 3.2)` — donc cuivre nul — plus son courtyard.
  - **Vérifié au fichier par le principal.** 124 empreintes, exactement deux références `H*` sans doublon, coordonnées exactes, couche et rotation conformes, aucun net. Les 21 placements de E1.2 sont intacts au micron et les 101 empreintes du bloc d'import n'ont pas bougé. `kicad-cli pcb drc` : `schematic_parity` toujours **0**, 254 non-connectés inchangés, et **aucune des 138 violations n'implique `H1` ni `H2`** — les trous n'en introduisent aucune.
  - **Conséquence pour toute resynchronisation ultérieure** : `H1` et `H2` sont des empreintes sans symbole au schéma. Toute « Mise à jour du PCB à partir du Schéma » devra **décocher « supprimer les empreintes sans symbole »**, sans quoi elles disparaîtront.
  - **Découverte d'outillage, à porter en H2.** **Aucun des 203 outils du MCP ne sait synchroniser le schéma vers le PCB** : ni import de netlist, ni « update PCB from schematic ». `kicad-cli` ne l'expose pas davantage. De plus, les outils MCP dépendants de l'IPC exigent non seulement que KiCad tourne, mais que **l'éditeur de PCB ait le fichier ouvert** — le gestionnaire de projet seul renvoie `KiCad does not handle kiapi.common.commands.GetOpenDocuments for this document type`. La synchronisation a donc dû passer par l'action **Outils → « Mise à jour du PCB à partir du Schéma »** de l'éditeur de PCB, **ouvert depuis le gestionnaire de projet** : ouvert en autonome, KiCad la refuse.
- [x] E1.3 Placer filtres LC, sorties, alimentation et boucles de retour. *(PASS en quatre tranches — filtres de sortie, entrée 48 V, alimentation auxiliaire, supervision et configuration. **Checkbox réparée en E1.5** : la dernière tranche déclarait « E1.3 est close » sans que la case soit cochée, et le libellé annonçait encore « 48 des 124 empreintes », contredit par E1.4 qui a clos le placement à 124.)*
  - **Tranche « filtres de sortie » = PASS** (`ec83d2f`). Les quatre broches `OUT` quittent `U6` sur un seul flanc en huit millimètres : toute disposition des tores doit les ouvrir en éventail. Canaux en **rangées** et non en colonnes — chaque paire BTL adjacente, boucle courte — ce qui ramène l'écart de longueur de nœud commuté entre canaux de 44 mm à 18. Tores 2×2 en `x` 240/276, `y` 195/212 ; films en rangée à `y` 229, ordre `C321` `C323` `C322` `C324` pour égaliser les liaisons post-filtre ; `J301`/`J302` sur l'arête arrière, fixée à `y` = 250 **par conséquence** du bulk figé sur `y` 119..182. DRC 96 → 90, les quatre `silk_edge_clearance` et deux `silk_over_copper` éteints, aucune `clearance` de retour.
  - **Tranche « entrée 48 V » = PASS** (`1ae53af`). `J1` → `F301` → `D301` → `Q301` → `R306` → `Q302` déroulés du bas-gauche au haut-droite, dans le sens où le courant circule ; `PVDD` quitte le hot-swap à 30 mm du bulk au lieu de 47 ; TVS **après** le fusible, pour qu'un clamp en court-circuit fasse encore sauter `F301`. Réseau haute impédance du `LM5069` groupé contre `U8`. DRC inchangé à 90, `schematic_parity` = 0, 254 non-connectés, 48 positions relues au micron.
  - **Tranche « alimentation auxiliaire » = PASS.** Les 24 empreintes du buck `LM5010` et de sa descendance sont posées en colonne dans `x` 158..186, `y` 134..194 — bande libre entre la chaîne d'entrée 48 V, qui s'arrête à `y` ≈ 199, et le haut de carte. Elle touche `U8`/`Q302`, d'où sort `PVDD`, et laisse **`x` 100..155 à l'analogique bas niveau de E1.4**, au bord opposé de `U6` comme l'exige l'orientation dans le coffret. **`U1` reste à rotation 0** : `SW` et `BUCK_VIN` sortent du même bord du WSON-10, donc aucune orientation ne met l'entrée en bas et la sortie en haut ; la continuité de la sortie vers `U2` puis `U3` l'emporte, et `PVDD`, rail DC calme, fait le détour. `R39`/`R40`, le diviseur de retour, sont sur le flanc `FB` en bas à droite, à l'opposé du nœud `SW`. **`C81`/`C82` sont retirés de la tranche** : ils découplent `+12V-OA`, le rail des OPA, et suivront `U4`/`U5` en E1.4.
    - **Un défaut trouvé puis corrigé avant clôture** : `C11` posée à `x` = 183 laissait 0,300 mm à la pastille `/PVDD` de `D3` pour 0,500 exigés par la netclasse `PWR_48V`, avec recouvrement de courtyards. Cause : la demi-largeur de pastille du `D_SMA` avait été négligée dans l'estimation. `C11` repoussée à `x` = 185 — 2,8 mm entre pastilles, 2,65 mm entre courtyards, et toujours 3 mm de dégagement vis-à-vis de `C317`.
    - **Coût inscrit à la baseline : trois `lib_footprint_mismatch`, sur `U1`, `U2` et `U3`.** Tout déplacement IPC fait réécrire l'empreinte par KiCad, qui en retire le bloc `(units)` — 24 blocs supprimés, exactement un par empreinte déplacée. **Aucun UUID n'est perdu : 4543 avant comme après**, aucun net ne change. **Cause rectifiée par la tranche suivante** : ce n'est *pas* la perte de `(units)` qui déclenche le mismatch, et il n'est *pas* systématique — `U7`, déplacé ensuite, perd lui aussi son bloc `(units)` sans produire aucun mismatch. Les vraies causes sont deux normalisations distinctes : pour `U2` et `U3`, la fermeture implicite d'un polygone de sérigraphie de SOT-223, purement cosmétique ; pour `U1`, **la perte de `(property pad_prop_heatsink)` sur son pad exposé**, qui elle est réelle — cf. E1.10.
    - Validation : DRC **99 violations, dont 96 de sérigraphie** (83 `silk_overlap`, 13 `silk_over_copper`) ; **aucune `clearance`, aucun `courtyards_overlap`** ; `schematic_parity` = 0 ; 254 non-connectés inchangés ; 124 empreintes ; les 48 placements antérieurs intacts au micron. Baseline de comparaison recalculée sur le commit précédent **dans le contexte de librairies du projet** — 90 violations, 0 `lib_footprint_mismatch` — sans quoi la mesure aurait faussement compté 5 `lib_footprint_issues` de librairie introuvable.
  - **Tranche « supervision et configuration » = PASS, E1.3 est close.** `U7` et son réseau — `R32`/`R26`/`C67` sur `VSENSE`, `R6`/`C83`/`C84` sur `RESET_RC` — occupent la bande réservée sous `U3`, `x` 156..184 / `y` 122..134. Les quatre résistances de configuration de `U6` sont en colonne `x` = 297.
    - **Contrainte découverte en relevant les pastilles de `U6`** : `FREQ_ADJ`, `OC_ADJ`, `FAULT` et `CLIP_OTW` sortent **toutes** du flanc `x` = 288,71, sur `y` 168,97..177,86 — c'est-à-dire **en plein dans la zone d'interdiction de la barre**. Aucune ne peut recevoir sa résistance en regard. La contrainte portant sur les pastilles et la hauteur et non sur le cuivre sous vernis, les quatre se posent hors des bandes interdites — `R303` `CLIP_OTW` (297, 162) et `R302` `FAULT` (297, 165) vers le haut, `R301` `FREQ_ADJ` (297, 184) et `R304` `OC_ADJ` (297, 187) vers le bas, chacune du côté d'où sort sa broche — au prix de 5 à 10 mm de piste passant sous la barre. Dégagement au bord droit vérifié avant placement : contour à `x` = 300, `min_copper_edge_clearance` = 0,5 mm, un 0603 à `x` = 297 en laisse 1,775.
    - Validation : DRC **102 violations, dont 99 de sérigraphie** (84 `silk_overlap`, 15 `silk_over_copper`) ; **aucune `clearance`, aucun `courtyards_overlap`, aucun `copper_edge_clearance`** ; `lib_footprint_mismatch` **toujours 3**, `U7` n'en ajoute aucun ; `schematic_parity` = 0 ; 254 non-connectés inchangés ; 124 empreintes ; les 72 placements antérieurs intacts au micron. **83 des 124 empreintes sont désormais placées**, 41 restent pour E1.4.
- [x] E1.11 Permuter les broches de `J301` et `J302` au schéma. **Ajouté en cours de Phase E**, sur décision utilisateur du 2026-09-07, après la découverte de E1.5. *(PASS, schéma et PCB. La permutation est propagée à la carte : `schematic_parity` **ramené de 7 à 3**, la baseline exacte, et le test d'intersection ne trouve **aucun croisement** sur les deux borniers, contre deux avant. Aucune régression : 124 empreintes **toutes intactes au micron**, `pad_prop_heatsink` de `U1` à 1, `lib_footprint_mismatch` à 0, 112 violations toutes de sérigraphie, 254 non-connectés.)*
  - **Défaut mesuré en E1.5** : chaque bornier reçoit **sur sa broche de gauche le signal qui vient de la droite**. `J301` porte `OUT_A_F` en `x` = 246 alors que A arrive de `x` = 268, et `OUT_B_F` en 251 alors que B arrive de 224 ; `J302` est croisé de la même façon. Longueur actuelle 54,6 mm par voie, **45,9 mm après permutation**, et surtout le croisement disparaît — il aurait imposé un via ou un détour sur une piste à 10 A de crête.
  - **Correction au schéma, pas au placement** : tourner physiquement le bornier donnerait le même résultat électrique mais retournerait l'ouverture des vis vers l'intérieur de la carte.
  - **Conséquence assumée** : la polarité absolue des deux sorties est inversée, **de façon identique sur les deux voies**. La polarité relative entre canaux est préservée, donc l'image stéréo n'est pas affectée.
  - **Risque principal, à surveiller** : la mise à jour du PCB depuis le schéma est l'opération qui avait fait perdre `pad_prop_heatsink` à `U1` en E1.10 et introduit des `lib_footprint_mismatch` en E1.3. **Relever la baseline avant, et la comparer après.**
  - **Tranche « schéma » = PASS.** Les quatre étiquettes sont permutées aux broches des deux borniers, et **elles seules** : `L301`–`L304` et `C321`–`C324` gardent leurs nets, ce qui est la vérification qui compte — permuter là aurait annulé la correction. **ERC inchangé à 16 violations / 0 erreur**, exactement la baseline `GATE C2` : 6 `lib_symbol_mismatch` et 10 `endpoint_off_grid`.
  - **Découverte majeure faite en validant cette tâche : `schematic_parity` n'avait jamais été mesuré.** Le test de parité PCB ↔ schéma est une **option désactivée par défaut** de `kicad-cli pcb drc`, et le champ vaut `0` quand il n'a pas tourné. Le `schematic_parity = 0` cité comme preuve dans presque toutes les tâches du projet signifiait **« test non exécuté »**. **La vraie baseline est 3**, tous explicables : `U6` pin 45 `/GND` sans pastille — le PowerPAD est sur le dessus du boîtier, établi en E1.7 — et `H1`/`H2`, trous mécaniques sans symbole. Aucun n'est un défaut, mais un vrai écart serait resté invisible. Détail : `docs/kicad-operations.md`.
    - **Le contrôle qui l'a révélé était un test négatif** : modifier le schéma sans propager, puis constater que le rapport affichait toujours `0`. Un contrôle qui ne sait pas échouer ne vaut rien.
    - **Correction de méthode, rétroactive** : toute validation citant `schematic_parity` doit passer `--schematic-parity` et **se comparer à 3, pas à 0**.
  - **Le blocage est levé, et sa cause était la session, pas KiCad.** Ni `kicad-cli` — `pcb import` ne lit que des formats non-KiCad, `sch export netlist` produit une netlist que rien ne réimporte — ni le MCP n'exposent « Mettre à jour le PCB depuis le schéma » : l'opération reste **GUI par nature**. Ce qui la bloquait n'était pas là : la session RDP était **déconnectée**, ce qui neutralise `SendInput` pour tout le bureau. Session reconnectée, le geste passe par automatisation, sans intervention manuelle. **Deux enseignements consignés dans `docs/kicad-operations.md`** : le gestionnaire de projet s'ouvre par `explorer.exe <projet>.kicad_pro` avec un jeton non élevé, et la boîte de dialogue de mise à jour **coche par défaut « Supprimer les empreintes sans symbole associé »**, qui aurait détruit `H1` et `H2`.
  - Validation : `schematic_parity` **mesuré avec `--schematic-parity`** et ramené à **3** ; `J301` pad 1 porte `OUT_B_F` et pad 2 `OUT_A_F`, `J302` pad 1 `OUT_D_F` et pad 2 `OUT_C_F` ; **test d'intersection rejoué sur les deux borniers = aucun croisement** ; 124 empreintes toutes intactes au micron ; `pad_prop_heatsink` de `U1` toujours à 1 ; `lib_footprint_mismatch` = 0 ; 254 non-connectés et aucune `clearance`.
- [x] E1.12 Déplacer `C106`, `C107`, `C206` et `C207` devant les broches d'entrée de `U6`. **Ajouté en cours de Phase E**, sur décision utilisateur du 2026-09-07, après la découverte de E1.5. *(PASS. Les quatre condensateurs sont aux positions calculées, **au micron, sans rotation** : `C106` (291,5 ; 182,0), `C107` (295,0 ; 182,0), `C206` (295,0 ; 168,63), `C207` (291,5 ; 168,64). Distance pastille → broche **3,50 à 6,54 mm** au lieu de 160. **La symétrie est redéfinie et non perdue** : `C106`+`C207` = 350,64 et `C107`+`C206` = 350,63, soit le miroir du brochage, comme les broches qu'ils desservent. Détail : `docs/architecture.md`, section « E1.12 ».)*
  - **Défaut mesuré en E1.5** : les quatre entrées analogiques courent sur **157 à 163 mm** au-dessus de la zone de puissance, et leur condensateur d'anti-repliement est **au départ** de la ligne, pas devant `U6`. Le bruit capté sur le trajet arrive donc sur la broche sans filtrage local. La topologie correcte est résistance à la source, **condensateur à la charge**.
  - **La contrainte qui gouverne le placement cible** : la bande `x` ∈ [280, 300], `y` ∈ [169, 181] est **interdite par la barre de liaison**, et les quatre broches d'entrée y débouchent (`INPUT_A` 179,13 ; `INPUT_B` 178,49 ; `INPUT_C` 172,14 ; `INPUT_D` 171,51). Rien ne peut être posé en face d'elles. Les emplacements libres sont à `y` ≤ 168 et `y` ≥ 182, dans la bande `x` 291..299 — soit **environ 6 mm** des broches au lieu de 160.
  - **Zone déjà encombrée** : `C320` (293 ; 157,5), `C318` (293 ; 160), `R303` (297 ; 162), `C303` (293 ; 163), `R302` (297 ; 165), `C304` (293 ; 166) d'un côté ; `R301` (297 ; 184), `C302` (293 ; 184), `C305` (293 ; 187), `R304` (297 ; 187), `C301` (293 ; 190), `C319` (293 ; 193) de l'autre. Les positions cibles sont **à trouver par mesure**, pas à supposer.
  - **Conséquence assumée** : les quatre condensateurs sortent du bloc analogique, et **la symétrie (0 ; +40) établie en E1.4 ne les couvre plus**. La nouvelle relation de symétrie doit être redéfinie et inscrite, sans quoi tout contrôle ultérieur la déclarera rompue à tort.
  - **Point électrique à ne pas manquer** : le retour de ces condensateurs devient la masse **locale de `U6`**, et non la masse analogique. C'est voulu — on shunte le bruit capté vers la référence du circuit — mais cela contraint la découpe de zone de F1.4.
  - **Positions cibles établies par recherche, pas supposées.** **Les deux zones interdites se composent** : pour `x` ≤ 291 c'est toute la bande `y` 160..190 qui est fermée, et pour `x` jusqu'à 300 la bande `y` 169..181. Il ne reste donc que `x` ≥ 291,5 **et** `y` hors [169, 181]. En imposant en plus au moins 2,5 mm de tout voisin — l'entraxe le plus serré que la carte accepte déjà sans `courtyards_overlap` — et **le miroir du brochage autour de `y` = 175,32** (les broches appariées `A`+`D` et `B`+`C` somment à 350,64) :

    | Réf. | Broche | Position cible | Distance à la broche | Voisin le plus proche |
    | --- | --- | --- | --- | --- |
    | `C106` | `INPUT_A` | **(291,5 ; 182,0)** | 4,0 mm | `C302` à 2,50 mm |
    | `C107` | `INPUT_B` | **(295,0 ; 182,0)** | 7,2 mm | `C302`/`R301` à 2,83 mm |
    | `C206` | `INPUT_C` | **(295,0 ; 168,63)** | 7,2 mm | `C304` à 3,28 mm |
    | `C207` | `INPUT_D` | **(291,5 ; 168,64)** | 4,0 mm | `C304` à 3,00 mm |

    **La symétrie n'est pas perdue, elle est redéfinie** : les quatre condensateurs sont en miroir autour de `y` = 175,32, comme les broches qu'ils desservent — et non plus à (0 ; +40) comme le reste de l'analogique. C'est la relation à inscrire, faute de quoi un contrôle ultérieur la déclarera rompue à tort.
  - **Orientation conservée** à sa valeur actuelle : un filtre d'entrée passe un courant faible, l'orientation n'y joue pas le rôle qu'elle joue sur les boucles de commutation, et la changer ajouterait un risque sans bénéfice établi.
  - Validation : DRC **112 violations, toutes de sérigraphie** (90 `silk_overlap`, 22 `silk_over_copper`), **aucune `clearance` et aucun `courtyards_overlap`** — le seul risque réel, les cibles étant bordées par `C302`, `R301`, `C304` et `R302` ; 254 non-connectés inchangés ; 124 empreintes et **seules ces quatre-là déplacées** depuis la baseline ; `pad_prop_heatsink` de `U1` à 1 ; les quatre hors des deux zones interdites, vérifié par test explicite. Le compte de sérigraphie monte de 106 à 112 — six chevauchements cosmétiques de plus dans une bande dense, à traiter avec le reste après F1.
  - Validation initialement prévue : les quatre condensateurs à moins de 10 mm de leur broche d'entrée, **aucun dans la bande interdite** ; entraxe suffisant, prouvé par l'**absence de `courtyards_overlap` au DRC** et non par un calcul de courtyard ; 124 empreintes, les 120 autres intactes au micron ; `pad_prop_heatsink` à 1 ; `schematic_parity` = 0, 254 non-connectés, aucune `clearance`.
- [x] E1.10 Rétablir `(property pad_prop_heatsink)` sur le pad exposé de `U1`. **Ajouté en cours de Phase E**, révélé en datant les `lib_footprint_mismatch`. *(PASS. « Mise à Jour des Empreintes à partir des Librairies » sur toute la carte, les cinq options texte laissées décochées pour ne réinitialiser ni position de référence ni contenu de champ. `pad_prop_heatsink` revient à **exactement une occurrence**, sur le pad 11 de `U1` ; les trois `lib_footprint_mismatch` tombent à **0** ; DRC **99 violations, toutes de sérigraphie** ; `schematic_parity` = 0 ; 254 non-connectés inchangés ; 124 empreintes ; **aucune des 124 positions ni rotations ne bouge**, comparées une à une. Le diff ne touche **aucun net** : il rétablit la propriété, referme les deux polygones de sérigraphie de SOT-223, aligne quatre styles de trait `default` → `solid`, et retire les 62 blocs `(units)` restants — le fichier n'en porte plus aucun, il est désormais homogène.)*
  - **Fait établi, pas supposé.** La carte ne portait qu'**un seul** `pad_prop_heatsink` — celui du pad 11 de `U1`, l'EP du `LM5010` sur `/GND` — et il disparaît **exactement** au commit qui déplace `U1` : présent en `955cc3e`, `ec83d2f` et `1ae53af`, absent en `0c4e3c7`. Ce n'est donc pas un héritage d'import mais une régression introduite par la réécriture d'empreinte de l'IPC.
  - **Pourquoi ça compte.** La propriété marque le pad comme dissipateur : elle gouverne la connexion pleine plutôt qu'en relief thermique au remplissage de zone, et l'ouverture de pochoir. Elle est donc sans effet sur le placement, mais **bloquante pour F1.4** et pour les livrables de H2.
  - **Voie de correction à privilégier** : « Mettre à jour les empreintes depuis la bibliothèque » dans l'éditeur de PCB, qui rétablirait du même coup la propriété de `U1` et les deux polygones de sérigraphie normalisés de `U2`/`U3`, donc les trois `lib_footprint_mismatch`. À faire en action isolée, avec relecture des 83 positions avant/après : cette action touche toutes les empreintes de la carte.
  - **Ne pas éditer le `.kicad_pcb` à la main** pour cela : la contrainte du projet est que toute édition de carte passe par `kicad-control`/MCP.
  - Validation : `pad_prop_heatsink` présent une fois dans le fichier, `lib_footprint_mismatch` ramené à 0, `schematic_parity` toujours 0, 254 non-connectés inchangés, 124 empreintes, et **les 83 placements intacts au micron**.
- [x] E1.4 Placer analogique faible bruit, volume et contrôles avec séparation fonctionnelle. *(PASS en deux tranches. **Les 124 empreintes sont placées** : le bloc d'import est vide, plus aucune empreinte au-delà de `y` = 260. Le placement de la carte est complet.)*
  - **Tranche « canal gauche » = PASS.** `U4` en (130, 145) et ses 19 satellites, dans la bande `x` 100..155 réservée depuis E1.3, au bord opposé de `U6`. **Le brochage relevé commande la disposition** : l'OPA1612 porte l'ampli A sur son flanc gauche — pad 1 `-VSE` sortie, pad 2 `INV1_NEG`, pad 3 `VMID`, pad 4 `GND` — et l'ampli B sur le droit — pad 8 `+12V-OA`, pad 7 `+VSE` sortie, pad 6 `INV2_NEG`, pad 5 `VMID`. B ré-inverse la sortie de A pour produire la phase opposée. Chaque réseau de contre-réaction reste donc **du côté de son ampli** : `R102`/`C102` à gauche entre pads 1 et 2, `R104`/`C103` à droite entre pads 7 et 6. Seul `R103` traverse, parce qu'il relie par nature la sortie de A à l'entrée de B. `C110` est collé à `U4` : c'est la raison d'être du dédoublement de `C110`/`C210` sur `VMID`.
  - Validation : DRC **101 violations, toutes de sérigraphie** ; aucune `clearance`, aucun `courtyards_overlap`, `lib_footprint_mismatch` toujours **0** ; `pad_prop_heatsink` toujours présent une fois — la régression de E1.10 ne s'est pas refaite ; `schematic_parity` = 0 ; 254 non-connectés inchangés ; 124 empreintes ; les 83 placements antérieurs intacts au micron. **103 des 124 empreintes placées.**
  - **Tranche « canal droit et connectique » = PASS, et elle clôt le placement.** Les 21 dernières empreintes sont posées en **miroir du canal gauche, décalées de +40 mm en `y`** : `U5` en (130, 185) contre `U4` en (130, 145), et chaque satellite de la série 200 à l'homologue de son jumeau de la série 100. Les deux voies sont donc **géométriquement comparables**, ce qui est la condition pour que E1.5 puisse juger la symétrie sur la géométrie plutôt que sur l'intention. `C210` reste collé à `U5` comme `C110` à `U4`. Le rail `+12V-OA` est fermé par `C81` (150, 139) et `C82` (154, 139) en aval de `L6`, et la connectique sort en façade : `J3` (104, 185) et `J4` (108, 112). Rien ne déborde au-delà de `x` = 156, la limite du bloc d'alimentation auxiliaire de E1.3.
  - Validation : DRC **104 violations, toutes de sérigraphie** — 85 `silk_overlap`, 19 `silk_over_copper` ; **aucune `clearance`, aucun `courtyards_overlap`, `lib_footprint_mismatch` toujours 0** ; `pad_prop_heatsink` toujours présent une fois ; `schematic_parity` = 0 ; 254 non-connectés inchangés ; 124 empreintes. Le diff ne touche **que 21 lignes `(at ...)`** et aucune autre : les **103 placements antérieurs sont intacts au micron**, prouvé par le diff lui-même et non par comparaison. Les 3 violations de plus sont de la sérigraphie des empreintes nouvellement posées, normales avant nettoyage.
- [x] E1.5 Revoir symétrie, retour des courants, masses, clearances et manufacturabilité. *(PASS en cinq tranches — symétrie mesurée, corrective, retour des courants et masses, rotation des bootstraps, clearances et manufacturabilité. **Trois défauts trouvés, deux corrigés dans la carte** : les positions puis les orientations que le miroir de `U6` rendait fausses. Les deux qui restent — permutation des borniers, condensateurs d'entrée — sont des décisions à porter à l'utilisateur, et aucun ne bloque le routage.)*
  - **Tranche « symétrie mesurée » = PASS.** Mesure au fichier, sans aucune écriture. **Acquis** : les 18 paires analogiques — `U4`/`U5`, les 16 paires `1xx`/`2xx`, `J2`/`J3` — sont à **(0 ; +40 ; 0°) exact, sans tolérance** ; les selfs `L301`/`L303` et `L302`/`L304` à (0 ; +17) exact ; `C321`/`C323`, `C322`/`C324` et `J301`/`J302` à (−22 ; 0) exact. **Trois écarts établis**, tous documentés dans `docs/architecture.md`, section « E1.5 — symétrie mesurée du placement » : (1) `R105`/`R106`, le diviseur `VMID` **partagé à bon droit** par les deux voies, est posé dans la voie gauche et non à mi-distance — le chemin vers `U5` est plus long de ~35 mm ; (2) **les bootstraps `C306`–`C309` ignorent le miroir du brochage** — les pastilles de `U6` sont symétriques autour de `y` = 175, les paires réelles sont donc **A↔D et B↔C**, pas A↔C/B↔D, et l'écart au miroir vaut 1,6 mm et 1,5 mm ; (3) **la translation des selfs contredit le miroir du brochage** — trajets réels pastille→self→bornier de 71,7 / 91,9 / 97,9 / 91,4 mm, soit **25,7 mm de cuivre en plus sur la voie droite** et un déséquilibre intra-voie non uniforme (20,2 mm à gauche, 6,5 mm à droite). L'écart (0 ; +17) des selfs est géométriquement irréprochable et électriquement trompeur : composer une translation avec un brochage en miroir ne peut pas apparier quatre trajets.
  - **La symétrie n'est pas un vecteur unique** : (0 ; +40) en analogique, (0 ; +17) aux selfs, (−22 ; 0) aux sorties. La carte ne peut donc pas se vérifier par une translation globale.
  - **Rectification en cours de tranche** : une première lecture n'avait comparé que les écarts en `x` (5,3 contre 41,3 mm) et concluait que les voies restaient comparables. La mesure des trajets réels l'infirme — l'écart est **aussi inter-voies**.
  - **Question tranchée, et non plus ouverte.** Il n'y a pas lieu de replacer les selfs. Leur courtyard mesuré vaut **29,10 × 13,10 mm** : une colonne unique de quatre demanderait 52,4 mm en `y` contre **42 disponibles** entre le bas de `U6` et les MKP de sortie, et un miroir autour de `y` = 175 est exclu par le bulk qui occupe toute la bande au-dessus du composant. **La grille 2 × 2 est imposée par l'encombrement**, et dans une grille 2 × 2 deux selfs sont forcément proches du flanc et deux lointaines, les quatre pastilles `OUT` sortant du même flanc sur 8 mm d'étalement. Aucune permutation ne supprime l'écart : elle le déplace. **L'appariement se fera donc au routage, par égalisation de longueur**, et E1.5 n'a qu'à inscrire la contrainte pour F1 — apparier **par paire de pont**, A avec B et C avec D, jamais par voie.
  - Validation : le rapport couvre les 18 paires analogiques et les 4 blocs de sortie sans omission ; chaque écart porte un verdict motivé ; le `.kicad_pcb` est **identique au bit près** avant et après, vérifié par `cmp` et par `git diff` vide.
  - **Tranche « corriger les deux écarts gratuits » = PASS.** Cinq déplacements par IPC, **tous en `y`, aucun en `x`, aucune rotation** : `C308` 172 → **173,5**, `C309` 168 → **169,6**, `C311` 171,9 → **171,7**, `R105` 152 → **163,5**, `R106` 155 → **166,5**. **Le critère est la somme, pas la distance** — les pastilles de `U6` étant en miroir autour de `y` = 175, deux bootstraps sont appariés si et seulement si leurs ordonnées somment à **350** ; `C306` (180,4) et `C307` (176,5) fixent donc la cible et ne bougent pas, leurs partenaires s'y alignent. `R105`/`R106` **restent partagés entre les deux voies** — c'est le bon choix électrique — mais passent à mi-distance de `U4` (145) et `U5` (185), égalisant les deux chemins de référence `VMID`. Le troisième écart, la translation des selfs, **n'est pas corrigé et ne peut pas l'être** : il part en contrainte F1. Détail : `docs/architecture.md`, section « E1.5 — tranche corrective ».
  - Validation : les 5 positions cibles **au micron**, `x` et orientation inchangés ; **124 empreintes**, les **119 autres intactes** en position et orientation, `L301`–`L304`, `C306` et `C307` compris ; `pad_prop_heatsink` de `U1` toujours présent ; DRC **105 violations, toutes de sérigraphie** (86 `silk_overlap`, 19 `silk_over_copper`), 254 non-connectés, `schematic_parity` = 0, `lib_footprint_mismatch` = 0, **aucune `clearance` et aucun `courtyards_overlap`**. Ce dernier point valide l'entraxe le plus serré de la tranche — **3,0 mm** entre `C307` et `C308` pour des 0603 en rotation 90° — **par le vérificateur, pas par un calcul de courtyard fait à la main**.
  - **Tranche « retour des courants et masses » = PASS**, en lecture seule. **Fait dominant : il n'existe qu'un seul net de masse, `/GND` (83 pastilles, 70 composants), et aucune zone de cuivre n'est encore dessinée** — la séparation des masses sera donc **purement géométrique**, décidée en F1. **Trois découvertes.** (1) **`C308` et `C309` sont croisés**, testé par intersection des segments d'amenée : le brochage de `U6` étant en miroir, l'ordre `BST`/`OUT` s'inverse d'une moitié à l'autre, et les quatre bootstraps portant la **même rotation de 90°**, deux sont nécessairement à l'envers. C'est l'erreur de la tranche précédente sous une autre forme — les positions avaient été mises en miroir, **pas les orientations**. Le coût n'est pas une longueur (0,5 à 0,9 mm) mais **un via imposé dans la boucle de grille du transistor haut**. Correction : rotation de 180°, sans déplacement, sommes à 350 préservées. (2) **Les deux borniers de sortie sont croisés** — chacun reçoit par sa broche de gauche le signal venu de la droite ; permuter gagne **8,7 mm par voie** et supprime le croisement, au prix d'une inversion de polarité absolue **identique sur les deux voies**, donc sans effet sur l'image stéréo. **Correction au schéma, hors périmètre E1.5.** (3) **Les quatre entrées analogiques traversent 157 à 163 mm** au-dessus de la zone de puissance, et leur filtre anti-repliement est **à la mauvaise extrémité** : les 100 pF sont au départ, pas devant `U6`. L'emplacement qui corrigerait cela est **interdit par la barre de liaison** — la bande `x` ∈ [288, 300], `y` ∈ [169, 181] est vide et les quatre broches d'entrée y débouchent. **Masses** : séparation franche, **35,76 mm** entre pastille de masse analogique et de puissance, découpe possible vers `x` ≈ 142 sans déplacer personne. Quatre contraintes F1 inscrites. Détail : `docs/architecture.md`, section « E1.5 — retour des courants et masses ».
    - **Écueil de méthode consigné** : l'aire du quadrilatère `pastille CI → condensateur → condensateur → pastille CI` **ne mesure pas une boucle**. Sur un quadrilatère croisé la formule du lacet retourne la différence des lobes, qui tend vers zéro — les boucles croisées ressortaient comme les meilleures. C'est le **test d'intersection des segments** qui tranche.
    - **Décision à porter à l'utilisateur** : déplacer ou non `C106`/`C107`/`C206`/`C207` devant les entrées de `U6`, à ~6 mm des broches au lieu de 160 mm. Non gratuit — sort les quatre condensateurs du bloc analogique et touche la symétrie de E1.4.
  - Validation : les trois questions posées reçoivent une réponse **mesurée** ; chaque croisement est établi par test d'intersection et non par estimation ; le `.kicad_pcb` est **identique au bit près**, MD5 `a0a35c1636a56b0deb7c7934052899ff` et `git diff` vide.
  - **Tranche « rotation des bootstraps croisés » = PASS.** `C308` et `C309` passent de 90° à **270°**, **sans déplacement** : les centres restent identiques au micron, donc les sommes à 350 de la tranche corrective sont préservées. `C306`/`C307` ne bougent pas — les tourner les croiserait. **L'IPC écrit cette orientation `-90`, pas `270`** : équivalent modulo 360, mais un contrôle qui chercherait littéralement `270` conclurait à tort à un échec.
  - Validation : le **test d'intersection rejoué sur les six condensateurs voisins de `U6`** — quatre bootstraps plus `C310`/`C311` — donne **zéro croisement** ; 124 empreintes, les 122 autres intactes en position et orientation, `C306`/`C307` toujours à 90° ; `pad_prop_heatsink` de `U1` présent ; DRC **106 violations, toutes de sérigraphie** (87 `silk_overlap`, 19 `silk_over_copper`), 254 non-connectés, `schematic_parity` = 0, `lib_footprint_mismatch` = 0, **aucune `clearance` et aucun `courtyards_overlap`**.
  - **Tranche « clearances et manufacturabilité » = PASS**, en lecture seule, **et elle clôt E1.5**. **Les 106 violations de sérigraphie n'en sont que deux** : `C312`/`C313` et `C314`/`C315` produisent à elles seules **73 des 87** `silk_overlap` — deux paires d'électrolytiques dont les cercles se recoupent — et **15 des 19** `silk_over_copper` sont des champs de référence imprimés sur une pastille. **Aucune ne touche le cuivre ni la connectivité** ; la correction est cosmétique et se fait **après F1**, le routage déplaçant de toute façon les champs qui gênent. **Contour** : marge minimale **1,78 mm** (`R301`–`R304` contre le bord droit), aucune pastille hors contour ; les deux zones réservées ne portent que `U6`, `H1` et `H2`. **Isolation** : les seules valeurs serrées sont **internes aux boîtiers** — 0,200 mm sur `U1`, 0,235 mm sur `U6` — donc imposées par le fabricant du composant et couvertes par la règle de E1.9 ; **inter-composants le minimum remonte à 0,950 mm**. **Manufacturabilité** : les 124 empreintes sont **toutes sur `F.Cu`**, une seule face de pose ; 100 CMS et 24 traversants, tous de puissance ou de connectique ; entraxe le plus serré 2,50 mm, sans `courtyards_overlap`.
    - **Second écueil de méthode consigné** : une première mesure d'isolation soustrayait les demi-dimensions **sur les deux axes à la fois**, produisant des distances négatives — jusqu'à −0,35 mm sur `U6` — là où les pastilles sont simplement alignées. La distance entre rectangles se calcule **axe par axe, avec un plancher à zéro**. Comme pour l'aire de boucle, la métrique maison contredisait le DRC : **c'est la métrique qu'il faut corriger, pas le DRC qu'il faut soupçonner.**
    - **Reste à F1** : confronter les distances à la table d'isolation applicable (IPC-2221) pour chiffrer la marge — la mesure établit que le placement ne crée pas de point serré, elle ne remplace pas la vérification normative, qui portera sur des pistes non encore tracées.
  - Validation : les quatre contrôles reçoivent une réponse **mesurée** ; le compte de sérigraphie est **décomposé par origine** et non simplement constaté ; le `.kicad_pcb` est **identique au bit près**, MD5 `eb5273ac4252b64fd97f4bd90b058fd9` et `git diff` vide.
- [x] E1.6 Chiffrer l'exigence thermique du dissipateur de `U6`, pour transformer le `NEEDS_DATA` en critère d'achat. **Ajouté en cours de Phase E**, le dissipateur étant devenu le point dimensionnant unique après D1.3. *(PASS. Dissipation de `U6` lue sur la **figure 10 de `SLASEA8A`** par extraction vectorielle, tracé contrôlé à l'échelle sur deux paires de graduations par axe : **22,4 W** à 2 × 100 W sur 8 Ω, **37,4 W** sur 4 Ω. **Recoupement fort** : les 22,4 W donnent 89,9 % de rendement, soit exactement les 90 % que le projet postulait sans preuve depuis l'origine pour établir les 4,6 A du rail. **Découverte principale : le point dur n'est pas le dissipateur mais l'interface.** Le PowerPAD ne fait que **29,02 mm²**, si bien qu'un pad silicone standard vaudrait **8,61 °C/W** — à lui seul plus que la totalité du budget. D'où deux exigences inscrites dans `docs/architecture.md` : **`REQ-THERM-1`, `RθSA` ≤ 1,0 °C/W** en convection naturelle pour l'usage nominal 8 Ω à 40 °C d'ambiante, et **`REQ-THERM-2`, interface ≤ 0,6 °C/W**, pad silicone standard explicitement exclu. Critère retenu : `T_C` ≤ 75 °C, plus strict que le seuil d'`OTW` à 125 °C, parce qu'il préserve la validité de toutes les courbes TI utilisées pour dimensionner la carte. **Réserve portée à l'utilisateur** : le continu à pleine puissance sur 4 Ω exigerait `RθSA` ≤ 0,37 °C/W, hors d'atteinte en convection naturelle — limite physique, non défaut de conception.)*
  - **Ne lève pas le `NEEDS_DATA`, et ne débloque pas E1.2.** Le placement réclame les **cotes** du modèle retenu et celles du boîtier, que seul l'utilisateur peut fournir. E1.6 produit le critère de sélection, pas la pièce.
- [x] E1.7 Établir la short-list dissipateur + boîtier contre `REQ-THERM-1`/`REQ-THERM-2`, et en relever les cotes. *(PASS. **Trois découvertes, dont deux rectifient E1.6.** (1) Le dissipateur de l'EVM, `ATS-TI1OP-519-C1-R3`, **ne tient pas l'exigence** : sa fiche `qats.com` ne publie aucune valeur à vitesse d'air nulle et plafonne à 2,2 °C/W sous 1 m/s, ce qui donnerait `T_C` = 102 °C. Il en reste la **mécanique de fixation** : deux taraudages M3, entraxe 36,8 mm, boulonnage par le dessous à travers le PCB. (2) **La résistance d'étalement manquait au budget** : les 22,4 W entrent par 29 mm², ce qui coûte au mieux 0,411 °C/W en base aluminium et ramène la cible d'un `RθSA` de catalogue de 1,0 à **0,58 °C/W**. `REQ-THERM-1` est reformulé sous forme invariante : interface + étalement + dissipateur ≤ **1,5625 °C/W**. (3) **La solution est le coffret, pas un dissipateur rapporté.** Un flanc de coffret dissipe vers les 25 °C de la pièce et non vers les 40 °C internes, ce qui vaut 0,67 °C/W de budget. Données fabricant Modushop/HiFi 2000 *Pesante Dissipante* : 0,45 °C/W par flanc en 2U/300 jusqu'à 0,23 en 4U/400, largeur intérieure 360 mm, hauteurs 80/120/165/210 mm. **Même le plus petit modèle donne `T_C` = 57 °C contre 75 visés**, et laisse 0,80 °C/W pour la barre de liaison — assez pour 50 mm en section 10 × 60, pas pour une équerre mince. Détail, budgets et réserves : `docs/architecture.md`, section « E1.7 — la solution n'est pas un dissipateur, c'est le coffret ».)*
  - **Fischer Elektronik non vérifiable** : 403 sur toutes les pages produit même avec en-tête navigateur, miroirs distributeurs inexploitables. Le `SK 47/100/SA` n'est **pas** retenu, faute de source primaire.
  - **Trois arbitrages utilisateur restent ouverts et conditionnent E1.2** : modèle de coffret, architecture mécanique (carte à plat + barre courte, ou carte verticale contre le flanc), et traitement de la masse — le PowerPAD étant `GND`, le presser sur le châssis relie la masse signal à la terre. **Ajouté en cours de Phase E** sur arbitrage utilisateur : plutôt que de fournir les cotes, l'utilisateur demande que le projet propose les candidats. C'est la tâche qui débloque E1.2.
  - **`REQ-THERM-3` acquis d'emblée** : le 4 Ω passe en régime de crête, la cible reste donc `RθSA` ≤ 1,0 °C/W en convection naturelle et non 0,37. Inscrit dans `docs/architecture.md`.
  - Contrainte de forme dominante : le PowerPAD étant **sur le dessus**, le dissipateur se pose à plat au-dessus de `U6`, à l'intérieur du boîtier. Un flanc dissipant ne conviendrait qu'avec un caloduc. La hauteur libre du boîtier doit donc couvrir le PCB, les 35 mm des condensateurs bulk **et** la hauteur du dissipateur.
  - Cotes à relever **par extraction du PDF fabricant**, jamais par listing distributeur : hors-tout du dissipateur, entraxe et mode de fixation, dimensions **intérieures** du boîtier.
  - Validation : chaque candidat retenu porte un `RθSA` **lu chez le fabricant en convection naturelle**, avec sa condition de mesure, et des cotes traçables à un document identifié.
- [x] E1.8 Raccorder le tab de `U3` à sa sortie au schéma. *(PASS. Un symbole local `TLV1117_33_FIXED` a été créé dans `HifiAmp_TPA3255.kicad_sym`, copie du `Regulator_Linear:TLV1117-33` augmentée d'une **broche 4 `TAB`, type `passive`, superposée exactement sur la broche 2 `VO`** — mêmes `(at 7.62 0 180)` et `(length 2.54)`. `U3` y est repointé sans bouger : `(at 195.58 100.33 0)`, UUID, `Reference`, `Value` et `Footprint` inchangés. **Vérifié au fichier par le principal** : `pad 4` de `U3` porte `/+3V3`, et surtout **plus aucune pastille numérotée de la carte n'est sans équipotentielle**. Les 21 placements de E1.2 sont intacts au micron, 122 empreintes, 74 nets, contour intact, `schematic_parity` toujours à **0**. Les non-connectés passent de 253 à **254** : exactement la pastille nouvellement raccordée et pas encore routée — la preuve arithmétique que le raccordement a pris.)*
  - **Superposition plutôt qu'ancre distincte, et c'est délibéré.** Le précédent `LM2940IMP_12_FIXED` pose sa broche `TAB` sur une ancre séparée, raccordée par une étiquette placée exactement dessus. Ici le tab est électriquement **le même nœud que la sortie** : le superposer sur la broche 2 le raccorde sans créer ni fil ni étiquette, donc **sans calculer une coordonnée d'ancre** — la seule partie réellement faillible de l'opération, et celle où la convention KiCad s'était révélée non triviale à dériver. Le type `passive` évite le conflit `power_out` contre `power_out` à l'ERC.
  - **Coût assumé, à inscrire à la baseline** : l'ERC passe de 15 à **16 violations, toujours 0 erreur**. L'écart est **un `lib_symbol_mismatch` de plus**, qui rejoint les **cinq déjà présents** pour `LM5010ASD`, `LM2940IMP_12_FIXED`, `TPS3802K33`, `LM5069` et `TPA3255B` — un simple écart de formatage entre la copie en cache du `.kicad_sch` et celle de la librairie, sans incidence électrique. Les 10 `endpoint_off_grid` sont inchangés, aucune violation n'a disparu. **La baseline `GATE C2` devient donc 16 violations / 0 erreur.**
  - **Preuve du défaut.** Après import, `U3` est le seul composant dont une pastille numérotée reste sans équipotentielle : `pad 4` du SOT-223, c'est-à-dire le **tab**. Le rapport KiCad le dit explicitement — *« Pas d'équipotentielle pour composant 'U3' pad '4' (pas de pin 4 en symbole) »*. Le symbole `TLV1117-33IDCY` ne déclare que trois broches.
  - **Fait établi à la source primaire.** `SLVS561O`, figure 4-1 *« DCY Package, 4-Pin SOT (Top View) »* : le boîtier **DCY est un SOT-223 à quatre broches**, la quatrième — le tab — étant **`OUTPUT`**, donc le même nœud que la broche 2. Le tab de `U3` doit porter `/+3V3`.
  - **Contre-exemple interne qui confirme l'omission** : `U2`, `LM2940IMP-12` dans le **même boîtier SOT-223**, a bien son `pad 4` raccordé à `/+12V`, sa propre sortie. L'asymétrie est un oubli de symbole, pas un choix.
  - **Conséquences si on n'y touche pas** : le tab est le chemin thermique principal du régulateur, et il serait laissé flottant ; le cuivre sous `U3` deviendrait un îlot isolé, relié à `/+3V3` par le seul boîtier.
  - **Non bloquant pour le placement**, bloquant pour F1 : à corriger avant tout routage.
  - **Voie de correction, avec précédent dans le projet.** `U3` tire le symbole **standard** `Regulator_Linear:TLV1117-33`, à trois broches. `U2` en revanche tire un symbole **local**, `LM2940IMP_12_FIXED` de `HifiAmp_TPA3255.kicad_sym`, et c'est précisément pour cela qu'il a son `pad 4`. Le correctif consiste donc à refaire le même geste : créer un `TLV1117_33_FIXED` local portant la quatrième broche, puis y repointer `U3`. Aucune invention de méthode, seulement l'application d'un précédent déjà validé sur ce projet.
  - Validation : `pad 4` de `U3` porte `/+3V3` après resynchronisation, `schematic_parity` reste à 0, et l'ERC ne régresse pas — 15 violations, 0 erreur, jeu identique à la baseline `GATE C2`.
- [x] E1.9 Poser une règle DRC pour l'isolation pastille-à-pastille interne aux boîtiers à pas fin. **Ajouté en cours de Phase E**, révélé par le DRC d'après placement. *(PASS. Une règle unique dans `HifiAmp_TPA3255.kicad_dru` fait tomber les 42 violations `clearance` à 0 ; total 138 → 96, `schematic_parity` toujours 0, 254 non-connectés inchangés, aucune violation nouvelle. `.kicad_pcb` et `.kicad_pro` restent identiques au bit près : la correction n'a coûté aucune modification de la carte.)*
  - **Preuve.** Les **42 violations `clearance`** du DRC ne sont pas des collisions de placement : elles opposent toutes **deux pastilles d'un même boîtier**, et se répartissent en `U6` (26), `U1` (8) et `U8` (8). Message type : *« Violation d'isolation (netclasse `PWR_AUX` isolation 0,2500 mm ; réel 0,2350 mm) »*. Leur nombre est **identique avant et après placement**, ce qui démontre qu'aucune translation ni rotation ne peut les faire disparaître.
  - **Cause.** L'écart est imposé par le pas des boîtiers retenus : `HTSSOP-44` à 0,635 mm de pas laisse 0,235 mm entre pastilles, `WSON-10` et `MSOP-10` sont à 0,5 mm. Les isolations de classes de nets posées en E1.1 — 0,25 mm en général, 0,50 mm sur les classes de puissance — sont donc **plus exigeantes que ce que la géométrie des composants permet**.
  - **Ce n'est pas un défaut de fabricabilité** : 0,235 mm reste très au-dessus des capacités courantes d'un fabricant de circuits imprimés. C'est la règle qui est mal cadrée, pas la carte.
  - **Correction de la voie retenue.** Le plan situait la règle dans `board.design_settings.rules` du `.kicad_pro` : **c'est faux**. Cette clé ne porte que des minima numériques (`min_clearance`, `min_track_width`, `min_via_diameter`…) et n'accepte aucune syntaxe `(rule …)`. En KiCad 10, les règles personnalisées vivent dans un **fichier `<projet>.kicad_dru` distinct**, jeton confirmé dans `kicommon.dll` ; aucun fichier de ce nom n'existe encore dans le projet. La règle s'écrit donc là, jamais par `set_design_rules`, proscrit. Ne pas abaisser l'isolation générale de la carte pour autant.
  - **Écarts réels mesurés** au DRC du 2026-09-02, sur les 42 violations : `0,235 mm` × 26, `0,200 mm` × 8, `0,150 mm` × 8. Le minimum à admettre est donc **0,150 mm**, réparti sur `U6` (26), `U1` (8) et `U8` (8). Les isolations requises qui les déclenchent sont `0,2500 mm` (30 cas) et `0,5000 mm` (12 cas), ces dernières venant des classes de puissance.
  - **Plancher `min_clearance` : hypothèse posée puis réfutée par l'expérience.** On attendait que `min_clearance = 0.2` du `.kicad_pro` serre la règle par le bas et laisse subsister les 8 cas à 0,150 mm. **Il n'en est rien** : la règle personnalisée l'emporte, les 42 violations tombent toutes, et **le `.kicad_pro` n'a pas eu à être touché**. Testé avant d'y toucher, précisément pour ne pas relâcher un plancher sans nécessité.
  - **Sélectivité prouvée, pas supposée.** Une règle mal cadrée aurait pu relâcher l'isolation de toute la carte sans qu'on le voie, faute de violation ailleurs pour le révéler. Contrôle discriminant : en retirant `U6` et `U8` de la condition, **exactement leurs 34 violations reviennent** — 26 pour `U6`, 8 pour `U8` — tandis que les 8 de `U1` restent supprimées. `memberOfFootprint` cible donc bien la seule empreinte nommée, et l'isolation entre empreintes distinctes est intacte.
  - **Règle retenue**, dans `HifiAmp_TPA3255.kicad_dru` : `(constraint clearance (min 0.15mm))` sous la condition que `A` et `B` soient deux pastilles d'une **même** empreinte parmi `U1`, `U6`, `U8`.
  - **Fonctions d'expression disponibles**, vérifiées dans `_pcbnew.dll` de l'installation KiCad 10 : `memberOfFootprint`, `intersectsCourtyard`, `existsOnLayer`, `enclosedByArea`, `memberOfGroup`, `isPlated`, `inDiffPair`, `isMicroVia`.
  - Validation : les 42 violations `clearance` disparaissent, aucune nouvelle n'apparaît, et l'isolation entre empreintes distinctes reste inchangée.

### Validation

Placement guidé par contraintes TI et revue de design via workflow disponible.

# Phase F — Routage

## F1 — Router et créer les plans

### Objectif

Router la carte en commençant par les boucles qui ne pardonnent pas — commutation, découplage, puissance Class-D — puis créer les plans et zones.

### Dépendances

E1 validée.

### Tâches

- [x] F1.1 Router boucles de commutation, alimentation Class-D et découplages. *(**PASS** — bootstraps, alimentation Class-D et découplages auxiliaires routés : **35 segments, zéro via**. Le retour `GND` est renvoyé au plan de masse de F1.4.)*
  - **Tranche « bootstraps » = PASS.** Les quatre boucles `/BST_A`–`/BST_D` sont routées sur `F.Cu`, **12 segments, zéro via** — l'invariant qui gouvernait la tranche, et pour lequel E1.5 avait retiré le dernier croisement. Longueurs 7,806 mm (A, D) et 10,118 mm (B, C).
  - **Largeur 0,35 mm, et non les 0,5 mm de la classe `GATE_DRIVE`.** Mesure : les pastilles de `U6` font 1,575 × 0,4 mm au pas de 0,635 mm, ce qui laisse 0,435 mm entre l'axe d'une piste et le bord de la pastille voisine. Pour 0,25 mm d'isolation, 0,5 mm donne 0,185 (viole), 0,4 mm donne 0,235 (viole encore), **0,35 mm donne 0,260 (passe)**. Le courant de bootstrap est négligeable et le minimum de la carte est 0,20 mm : la largeur de classe n'était pas tenable ici.
  - **`C310` et `C311` barrent les tracés directs de `/BST_B` et `/BST_C`.** Le couloir de cuivre libre entre les deux pastilles de `C310` fait 1,8 mm, centré sur `y` = 178,3 : les pistes y passent, `/BST_A` et `/BST_D` restant hors courtyard.
  - Validation : **DRC 112 violations, strictement les mêmes qu'avant** (90 `silk_overlap`, 22 `silk_over_copper`), **0 `clearance`, 0 `shorting_items`, 0 `track_dangling`** ; **non-connectés 254 → 250**, la preuve que les quatre liaisons sont réellement faites ; `schematic_parity` toujours **3** ; 124 empreintes inchangées. **Vérification indépendante du principal** : connexité pad à pad sans segment orphelin, **miroir `y` = 175 exact sommet par sommet** (A↔D sur 3, B↔C sur 5), aucun croisement sur les 6 paires, zéro via au fichier.
  - **Deux pièges de relecture découverts ici, consignés dans `docs/kicad-operations.md`** : la rotation d'un pad se fait en `-θ` — prendre `+θ` échange les deux pastilles d'un composant à ±90° et **reste invisible à 0° et 180°** — et `(segment` est suivi d'un saut de ligne, pas d'un espace, si bien qu'un motif `"(segment "` rend zéro piste sans erreur.
  - **Découverte en préparant la tranche Class-D : `C310` est orienté à l'envers.** `C310` et `C311`, les deux seuls découplages `PVDD` de `U6`, sont **tous deux à rotation 90°**, alors que le miroir autour de `y` = 175 en exige d'opposées — c'est exactement le défaut corrigé en E1.5 sur les bootstraps, où `C306`/`C307` sont à 90° et `C308`/`C309` à −90°. `docs/architecture.md` ne constatait le miroir que sur la **position** (178,3 contre 171,7), jamais sur l'orientation.
  - **Conséquence électrique mesurée**, en visant les pastilles les plus proches de `U6` : côté bas, `C311` est correct — `PVDD` face aux pins 29–31, `GND` face aux pins 25–26, **7,71 mm de boucle et aucun croisement**. Côté haut, `C310` présente son `PVDD` face au `GND` de `U6` et inversement : **9,04 mm et les liaisons `PVDD` et `GND` se croisent**, ce qui **imposerait une via dans la boucle de découplage la plus critique du Class-D**. Tourné à −90°, `C310` retombe sur **7,71 mm sans croisement**, à l'identique de `C311`.
  - **La rotation n'affecterait pas le routage déjà fait** : un 1210 tourné de 180° occupe la même emprise, seules les pastilles échangent leurs nets. Le couloir de 1,8 mm centré sur `y` = 178,3 où passe `/BST_B` reste libre. **À confirmer au DRC après rotation.**
  - **Décision utilisateur : `C310` tourné à −90°, et audit d'orientation de tout le bloc.** L'audit croise position et orientation sur les 8 paires en miroir `y` = 175. **Trois seulement sont discriminantes** — celles dont la rotation n'est ni 0 ni 180, les seules où le miroir se voit : `C306`/`C309` et `C307`/`C308` sont correctes, **`C310`/`C311` était le seul défaut de la carte**. Les autres composants du bloc sont à 0° ou 180°, où `-θ = θ` : aucun défaut n'y est possible. `C310` est passé de 90° à −90° **sans bouger** (277,5 ; 178,3), et ses pastilles ont échangé leurs nets comme voulu : `PVDD` en 176,825, face aux pins 36–38.
  - **Tranche « alimentation Class-D » = PASS.** `/PVDD` routé sur `F.Cu`, **4 segments, zéro via**, en deux largeurs par côté : **0,8 mm** dans le couloir que borde `/BST_B`, puis **1,1 mm** au-delà de `x` = 279,9 où le bootstrap ne court plus, ce qui recouvre les trois pastilles 36–38 (et 29–31). Miroir `y` = 175 exact, aucun croisement avec les 12 segments de bootstrap.
  - **L'isolation dépend de la classe du net, et `PWR_48V` exige 0,5 mm, pas 0,25.** Le couloir avait d'abord été calculé avec l'isolation de `GATE_DRIVE` ; un premier tracé à 1,4 mm a produit **3 violations `clearance` à 0,2875 mm**, qui ont établi la vraie contrainte. **Vérifier la classe du net avant de calculer un couloir**, jamais reprendre celle du net voisin.
  - **Le retour `GND` local n'est pas routable sur `F.Cu` et part au plan de masse (F1.4).** `/BST_B` traverse le couloir `GND` haut — il passe par `x` ≈ 279,72 à `y` ≈ 180 — et `/BST_C` le couloir bas par symétrie : aucune liaison `GND` locale ne rejoint `C310`/`C311` sans via. C'est la pratique normale en 4 couches, et cela préserve la symétrie des deux côtés.
  - Validation : **DRC 112 violations, strictement inchangées** (90 `silk_overlap`, 22 `silk_over_copper`) ; **0 `clearance`, 0 `shorting_items`, 0 `track_dangling`** ; **non-connectés 250 → 244**, six chevelus résolus — trois par liaison, les trois pastilles de `U6` plus celle du condensateur ; `schematic_parity` toujours **3** ; **124 empreintes dont `C310` seule modifiée**, et seulement en rotation ; `pad_prop_heatsink` de `U1` à 1. **Vérification indépendante du principal** : orientations miroir, `PVDD` plus près de l'axe que `GND` sur les deux condensateurs, 0 via, miroir des segments exact, aucun croisement.
  - **Tranche « découplages auxiliaires » = PASS sauf `VBG`.** `AVDD` (pin 14 → `C318`), `DVDD` (pin 11 → `C319`) et `/+12V` (pins 1, 2, 22 → `C302`, `C304`) routés sur `F.Cu`, **15 segments, zéro via**, largeur **0,30 mm**. La correspondance broche → condensateur a été **établie par mesure** (`get_component_pads` sur chaque candidat, corroborée par les arêtes du MST de chevelus), jamais déduite des désignateurs.
  - **La largeur nominale de classe est de nouveau intenable en sortie de `U6`.** `AVDD`/`DVDD`/`+12V` sont en classe `PWR_AUX` (isolation 0,25 mm, piste nominale **0,8 mm**) et `VBG` en `ANALOG` (0,25 / 0,25). Au pas de 0,635 mm entre pastilles de 0,4 mm, une piste de 0,30 mm laisse 0,635 − 0,2 − 0,15 = **0,285 mm ≥ 0,25** : 0,30 mm passe, la largeur de classe non. **Les classes se lisent dans `.kicad_pro`** — le `.kicad_dru` ne porte que l'exception interne à `U6`/`U1`/`U8`.
  - **Un premier lot a produit 6 `shorting_items` et 6 `solder_mask_bridge`** : les découplages d'entrée `C106`/`C107`/`C206`/`C207` avaient été omis du contrôle de dégagement alors qu'ils sont dans le couloir emprunté. Les 14 segments fautifs ont été retirés et la géométrie recalculée en les intégrant. **Un contrôle de dégagement ne vaut que par l'exhaustivité de la liste d'obstacles qu'on lui donne** — le DRC, lui, l'a vu tout de suite.
  - **`AVDD` et `DVDD` ne passent que par un détour externe** (couloir `x` ≈ 295–299, au-delà de `R303`/`R301`), le corridor central étant saturé : **28,95 mm et 34,82 mm** de piste pour des découplages dont la distance directe est d'environ 13,8 mm. **Longueurs assumées faute de via, à réexaminer en F1.4.**
  - **`VBG` → `C303` : non routé, impossibilité mono-couche démontrée.** Preuve topologique par ordre des extrémités : côté `U6`, pin 22 (`y` = 168,33) précède `VBG` (169,6) ; côté condensateurs, `C303` (163) précède `C304` (166) — **l'ordre s'inverse entre source et cible**, ce qui impose un croisement à toute liaison mono-couche, quelle que soit la forme du chemin. Les trois échappatoires ont été testées et écartées par calcul : le détour externe croise `AVDD`, qui occupe déjà la plage `y` 158,8–173,4 ; le contournement local exige 0,75 mm là où l'écart entre les deux pastilles d'un 0805 n'offre que **0,65 mm** ; l'inversion de priorité bute sur le même goulot. **Aucune via posée : l'arbitrage remonte à l'utilisateur.**
  - Validation : **DRC 112 violations, identiques à la baseline** (90 `silk_overlap`, 22 `silk_over_copper`) ; **0 `clearance`, 0 `shorting_items`, 0 `track_dangling`** ; **non-connectés 244 → 239**, cinq chevelus résolus exactement comme prédit ; `schematic_parity` toujours **3**, les trois mêmes écarts ; `pad_prop_heatsink` de `U1` à 1 ; 124 empreintes intactes. **Vérification indépendante du principal** : DRC relancé, **31 segments tous sur `F.Cu`** et **0 via** au fichier, largeurs 12 × 0,35 + 2 × 0,8 + 2 × 1,1 + 15 × 0,30, et **diff Git sans aucune suppression de segment** — les 6 seules lignes retirées sont une normalisation d'écriture de KiCad (`-90` → `270`) sur les champs texte de `C310`, dont le placement reste `(277,5 178,3 −90)`.
  - **`VBG` résolu en corrigeant la cause, pas en la contournant.** L'inversion de l'ordre des extrémités étant le problème, ce sont les extrémités qui ont bougé : **`C303` (`VBG`, 0805) passe en `y` = 166 et `C304` (`+12V`, 0603) en `y` = 163**, positions échangées, rotations conservées. L'ordre côté condensateurs s'aligne alors sur l'ordre côté `U6`, et les deux liaisons passent en direct — **`VBG` en 4 segments / 14,0 mm à 0,25 mm** (classe `ANALOG`, tenable telle quelle), **`+12V` pin 22 en 3 segments / 8,73 mm à 0,30 mm**. **Zéro via.** Décision utilisateur, préférée à la via et au report en F1.4.
  - **L'échange déplace un 0805 dans une rangée de 0603, et c'est admissible par mesure.** Les deux composants étant à rotation 0°, leur axe long est en `x` : l'emprise en `y` ne croît que de 0,5 mm. La vraie contrainte n'était pas le voisin le plus proche (`C207` à 2,64 mm) mais **les pastilles `GND` de `C207` et de `C303`** — un premier tracé les frôlait à **−0,125 mm** et a été rejeté par le contrôle avant même le DRC. Tronc repoussé à `x` = 296,7, approche finale par `y` = 167,2 : toutes marges ≥ 0,25 mm. **Effet secondaire favorable** : `C303` se rapproche de la pin 20 ; `+12V` s'allonge de 2,33 à 8,73 mm, prix assumé du non-croisement sur une alimentation auxiliaire.
  - **Le déplacement IPC laisse derrière lui les pistes qu'il traîne.** Trois segments `/+12V` obsolètes subsistaient après le déplacement de `C304`, terminés dans le vide ; repérés par `query_traces` et supprimés avant repose, sans quoi ils auraient produit un `track_dangling`. **Requêter les pistes d'un net après avoir déplacé l'un de ses composants.**
  - Validation : **non-connectés 239 → 238**, le chevelu prédit ; **0 `clearance`, 0 `shorting_items`, 0 `track_dangling`** ; `schematic_parity` toujours **3** ; `pad_prop_heatsink` de `U1` à 1, contrôlé au premier déplacement de la session ; **124 empreintes, exactement deux modifiées et seulement en position**. **Sérigraphie 112 → 113**, seul compteur à bouger : `C303` entre en conflit avec les champs référence de `C206` et `C207`, et libère celui de `C318`. Purement cosmétique, aucun effet cuivre, à traiter avec les 112 autres. **Vérification indépendante du principal** : DRC relancé, **35 segments tous sur `F.Cu`**, **0 via**, largeurs 12 × 0,35 + 2 × 0,8 + 2 × 1,1 + 15 × 0,30 + 4 × 0,25, et diff Git ne montrant **que les deux `(at)` d'empreinte échangés**.
- [x] F1.2 Router sorties vers filtres LC et connecteurs avec largeurs justifiées.
  - [x] F1.2-a Sorties filtrées `self → condensateur → bornier`. *(**PASS** — les quatre nets `/OUT_x_F` routés sur `F.Cu`, **23 segments à 3,00 mm, zéro via**, après deux échanges d'emplacement entre composants identiques.)*
    - **Un brouillon non commité a été écarté, pas repris.** Il posait 15 segments à **0,5 mm** sur trois nets, `/OUT_B_F` absent et `/OUT_C_F` inachevé, alors que `progress.md` déclarait la tâche non commencée. À IPC-2221 en couche externe, 35 µm, ΔT = 10 °C, **0,5 mm tient 1,45 A** pour 5 A à passer. La largeur de classe `PWR_OUT`, elle, est **tenable telle quelle** hors des boîtiers à pas fin : 3,00 mm porte 5,3 A.
    - **Le vrai obstacle était un ordre, pas une largeur.** Aux condensateurs de filtre l'ordre en `x` était `D`, **`B`**, **`C`**, `A` ; aux borniers, imposé par l'appariement BTL, il est `D`, **`C`**, **`B`**, `A`. `B` et `C` transposés rendent toute liaison mono-couche croisante, contournements par le bas de carte compris — c'est l'entrelacement que E1.5 avait relevé et renvoyé à F1.
    - **Correction à la cause, par deux échanges entre composants identiques** dans des emplacements identiques, rotations conservées : `L302` (240 ; 195) ↔ `L303` (276 ; 212), et `C322` (224 ; 229) ↔ `C323` (246 ; 229). L'ordre des condensateurs devient `D`, `C`, `B`, `A` et coïncide avec celui des borniers : **la topologie devient planaire**. Décision utilisateur, préférée aux 12 à 16 vias qu'aurait coûtés le croisement sur un nœud à 5 A.
    - **Effet secondaire favorable : chaque paire de pont est désormais contiguë** — `A` et `B` sur les selfs en `x` = 276, `C` et `D` en `x` = 240 —, ce que demandait la contrainte F1 et que le placement E1.5 ne pouvait pas offrir. **Tous les vecteurs de symétrie L↔R restent exacts** et les vecteurs intra-paire le deviennent : selfs (−36 ; 0), condensateurs (−44 ; 0), borniers (−22 ; 0).
    - **Cible d'appariement fixée et atteinte sans méandre.** Trajets série `self → bornier` : `A` 69,0 mm, `B` 57,0, `C` 57,0, `D` 47,0 — écarts **12,0 mm** dans la paire `A`/`B` et **10,0 mm** dans `C`/`D`, contre 8,5 et 26,4 en distances de placement. La cible retenue est un écart **électriquement négligeable**, non nul : 12 mm de piste valent 2 mΩ et 10 nH contre 15 µH et 31 mΩ de self en série. Résistance série 7,7 à 11,3 mΩ, chute ≤ 56 mV à 5 A.
    - **Un piège d'outillage de plus, consigné dans `docs/kicad-operations.md`** : le déplacement par MCP **retire le bloc `(units …)`** de l'empreinte déplacée — 119 blocs puis 115 — sans que le DRC, la parité ni la connectivité ne bougent. Restauré à l'identique avant commit.
    - Validation : **DRC 113 violations, strictement les mêmes qu'à la baseline** (91 `silk_overlap`, 22 `silk_over_copper`) ; **0 `clearance`, 0 `shorting_items`, 0 `track_dangling`, 0 `solder_mask_bridge`, 0 `copper_edge_clearance`** ; **non-connectés 238 → 230**, les huit chevelus prédits ; `schematic_parity` toujours **3** ; 124 empreintes, `pad_prop_heatsink` de `U1` à 1. **Vérification indépendante du principal** : DRC relancé en `kicad-cli --schematic-parity`, **58 segments tous sur `F.Cu`**, **0 via**, largeurs 23 × 3,00 + les 35 de F1.1 inchangées, **zéro intersection** entre les 23 segments testée segment à segment, et diff Git ne montrant **que les quatre `(at)` échangés et les 23 segments**.
  - [x] F1.2-b Échappement des quatre sorties de `U6` vers les selfs. **Arbitrage rendu, en cours.**
    - **Mesure : aucune des quatre sorties ne quitte `U6` sur `F.Cu` à une largeur utilisable.** La bande `x` ∈ [273 ; 281,3], `y` ∈ [168 ; 182] est saturée par `C310`/`C311`, les quatre bootstraps et les pistes `BST` de F1.1. Seule fenêtre large : **2,50 mm**, à partager par `OUT_C` et `OUT_B` — **0,50 mm chacune**. `OUT_A` et `OUT_D` n'ont qu'un jour de **0,725 mm**, soit une largeur **négative** à l'isolation `PWR_OUT`. Il faut **3,00 mm** pour les 5 A d'une voie ; 0,50 mm porte 1,45 A et chaufferait de 168 °C. Tableaux complets dans `docs/architecture.md`, section F1.2-b.
    - **Contournements exclus par la mesure** : par le haut `BST_D` barre de `x` = 273,5 à 281,3 ; par le bas `BST_A` de même ; par la droite, corps et pavé thermique de `U6`.
    - **Deux causes.** De placement : `C310`/`C311` sont posés **en face du flanc de puissance** et couvrent toute la plage en `y` des broches `OUT`. D'ordre, héritée de F1.1 : `BST_B` part de la broche 43 (`y` = 181,03) vers `C307` (177,28) et **traverse nécessairement la rangée `OUT_A`** ; `BST_C` fait de même sur `OUT_D`. Aucune permutation des condensateurs à deux pastilles ne produit l'ordre requis.
    - **Trois voies, aucune neutre, arbitrage utilisateur** : déplacer `C310`/`C311` en rallongeant la boucle de découplage `PVDD` que F1.1 avait minimisée à 7,71 mm ; descendre les quatre `OUT` sur couche interne par vias, `In1.Cu` étant déjà déclarée *power* ; ou reprendre le voisinage complet de `U6`, selfs comprises, les selfs étant à 14–20 mm des broches là où la pratique de référence les colle aux sorties.
    - **Arbitrage rendu — les deux causes sont traitées séparément, et une quatrième voie a été retenue à la place des trois initialement listées.** Décision utilisateur : (1) `C310`/`C311` passent **au dos, sur `B.Cu`**, pastilles reliées par vias sous les broches `PVDD`/`GND` — cela libère toute la colonne `x` ∈ [276 ; 279] *et raccourcit* la boucle de découplage, dont la surface devient l'épaisseur de carte au lieu de 7,71 mm de trajet plan ; (2) le croisement structurel se dénoue par **une via sur chaque `BST`** — `BST_B` et `BST_C` sont des signaux de grille à 0,35 mm, une via suffit par net, contre les quatre qu'exigerait un `OUT` à 5 A. **Coût assumé : la carte cesse d'être strictement simple-face** — 124 empreintes toutes sur `F.Cu` jusqu'ici — soit un second passage d'assemblage pour deux composants. Écartées : le report de `C310`/`C311` à gauche des bootstraps (boucle `PVDD` au-delà de 20 mm sur le nœud le plus critique), la descente des quatre `OUT` sur `In1.Cu` (~16 vias de puissance et découpe du plan), et la reprise complète du voisinage de `U6` (invalide F1.2-a).
    - [x] F1.2-b1 Basculer `C310`/`C311` sur `B.Cu` et rerouter `/PVDD` par vias. **Critère de boucle révisé par décision utilisateur** : ≤ 7,71 mm s'est révélé intenable avec les vias (≈ 10,8 mm au `x` d'origine) ; option retenue, condensateurs glissés sous `U6` — **9,63 mm mesurés**, minimum atteignable sans via dans une pastille (bord via ↔ pastille ≥ 0,15 mm). Validation d'origine : boucle de découplage **≤ 7,71 mm** de trajet équivalent, colonne `x` ∈ [276 ; 279] libre sur `F.Cu`, DRC sans `clearance` ni `shorting_items`, 124 empreintes, 119 blocs `(units`.
    - [x] F1.2-b2 Faire plonger `BST_B` et `BST_C` sous la rangée `OUT` par **une via chacun**. **Révisé par la mesure : 2 vias par net, 4 au total** — un net qui part d'une broche `F.Cu` et finit sur une pastille CMS `F.Cu` exige un nombre pair de vias ; `BST_A`/`BST_D` contournent sur `F.Cu` par `y` 182,4 et 167,6, sans via. Colonne `x` ∈ [276,15 ; 278,85] vide sur `F.Cu` (critère hérité de F1.2-b1). Validation d'origine : 2 vias exactement, aucun `track_dangling`, largeur `GATE_DRIVE` tenue à 0,35 mm en sortie de boîtier.
    - [x] F1.2-b3 Router `/OUT_A` à `/OUT_D` de `U6` aux selfs. **Routée (`ce19b50`, DRC propre, 216, sélectivité DRU prouvée), validation de largeur non tenue : reportée à F1.2-c2, **tenue par F1.2-c2**.** Validation : non-connectés **226 → 216** (base recalée après F1.2-b1, même écart de 10), largeur d'échappement justifiée puis reprise à 3,00 mm hors du pas fin, **sélectivité de la règle DRU prouvée**.
    - *Règle DRU d'échappement déjà posée et prouvée inerte ; sa sélectivité reste à prouver quand une piste l'exercera.*
  - [x] F1.2-c **Reprise du placement de l'étage de sortie** (décision utilisateur après F1.2-b3 : cols de 0,96–1,07 mm hors du pas fin entre les bootstraps, nœud `OUT_D` de 101 mm, appariement E1.5 par paire de pont non tenu — A 31,7 / B 58,3, C 63,7 / D 101,2 mm). Cadre : la grille 2 × 2 des tores reste imposée par le contour (E1.5) ; seuls pas, position et affectation des tores, et position des bootstraps `C306`–`C309`, sont ouverts. Les vias restent interdites sur les `OUT`.
    - [x] F1.2-c1 *(**PASS** — option O1 « brique stricte » retenue, écrite dans `docs/architecture.md`, section F1.2-c : écarts A/B 0,0, C/D 2,8 mm, `OUT_D` 101 → 70 mm, aucun `OUT` sous un tore.)* Étude au fichier, sans écriture : resserrement de la grille (pas `x` ≥ 29,1 mm, `y` ≥ 13,1 mm, bande `y` 183–225), affectations planaires tore ↔ `OUT` et bootstraps hors du chemin `OUT` en miroir autour de `y` = 175. Validation : longueurs `OUT` → self estimées par option, planarité vérifiée avec `OUT_x_F` et bornier, écart A/B et C/D chiffré, option retenue écrite dans `docs/architecture.md`.
    - [x] F1.2-c2 *(**PASS** — O1 appliquée, `d00e2fb8…` : DRC propre, 216, parité 3 ; A 29,13 / B 28,92, C 68,27 / D 71,89 mm ; largeur < 3,00 mm seulement pour `x` ≥ 277,2 ; `OUT_x_F` tout à 3,00 mm ; sélectivité DRU rejouée, 11 `clearance` toutes sur `U6`.)* Appliquer le placement retenu et rerouter `OUT_x` et `OUT_x_F` touchés. Validation : DRC sans `clearance`/`shorting_items`/`track_dangling`/`courtyards_overlap`, parité 3, non-connectés 216, 3,00 mm partout hors pas fin et resserrement des vias `BST` justifié, écart de longueur par paire de pont chiffré et réduit, 124 empreintes, 119 `(units`.
- [x] F1.3 Router analogique, contrôle puis signaux non critiques. *(Inventaire après F1.2 : 216 chevelus = `GND` 78 + entrée/protection 39 + buck auxiliaire 30 + alimentations analogiques 34 + signal analogique 26 + contrôle 9. Les 78 `GND` vont au plan de F1.4, pas à des pistes.)*
  - [x] F1.3-a Buck auxiliaire `U1` et rails `+12V`/`+15V`/`+3V3` (30 : `SW`, `BUCK_VIN`, `FB`, `BST`, `VCC`, `SS`, `RON_SD`, rails). Boucle `BUCK_VIN`–`SW`–self minimale en premier, `FB` loin de `SW`. Validation : 30 chevelus résolus, aucun hors `GND` restant sur ces nets, DRC sans `clearance`/`shorting_items`/`track_dangling`, largeurs justifiées par le courant.
  - [x] F1.3-b Entrée de puissance et protection `LM5069` (39 : `PVDD`, `PVDD_PROT`, `PVDD_FUSED`, `PVDD_SENSE`, `PVDD_EXT`, `VSENSE`, `ISEN`, `HS_GATE`, `Q301_GATE`, `LM5069_*`). Shunt `R306` pris en Kelvin sur les bords intérieurs, chemin de puissance dimensionné au courant total, 6 cm² de cuivre sur le drain de `Q301` réservés pour F1.4. Validation : 39 résolus, largeurs de puissance justifiées, DRC propre.
  - [x] F1.3-c Alimentations analogiques (34 : `±VSE`, `±VSE_R`, `L/R_POS/NEG_AC`, `+12V-OA`, `VMID`). `VMID` équidistant de `U4`/`U5` (constat E1.5). Validation : 34 résolus, DRC propre.
  - [x] F1.3-d Signal analogique — d'abord reclasser `±VSE`/`±VSE_R` de `PWR_OUT` en `ANALOG` dans `.kicad_pro` (sorties d'AOP de quelques mA, classe héritée erronée ; DRC inchangé après reclassement) (26 : `INPUT_A`–`D`, `INV1`–`4_NEG`, `RCA_L/R`, `VOL_L/R(_IN)`). Dans la bande `x` 100..155, symétrie (0 ; +40) des deux voies conservée au routage, loin des nœuds commutés. Validation : 26 résolus, écart de longueur entre voies chiffré, DRC propre.
  - [x] F1.3-e Contrôle (9 : `RESET`, `RESET-SW`, `RESET_RC`, `FAULT`, `CLIP_OTW`, `OC_ADJ`, `FREQ_ADJ`, `C_START`). Validation : 9 résolus ; il ne reste que les 78 `GND` ; DRC propre, parité 3.
- [ ] F1.4 Créer plans/zones et vias thermiques ; remplir les zones. *(**Dépend de F1.6** : un condensateur ajouté se place avant le remplissage des zones. Constat F1.3-a : le `+3V3` long (~135 mm) court en `B.Cu` à `y` 138,3 ; à reprendre si `B.Cu` est réservé au plan `GND`.)*
  - [ ] F1.4-a Étude de stratégie des plans, lecture seule. Concilier les contraintes E1.5 (découpe `GND` vers `x` ≈ 142 et jonction unique près de `U6` ; `INPUT_A`–`D` en couche interne entre deux plans de masse sur la traversée de puissance ; retour des MKP `C321`–`C324` sans le plan analogique) avec l'implantation prévue (« L2 plan GND continu ») et le routage réel (`INPUT` en `B.Cu`, `PVDD` 7 mm en `B.Cu`, `+3V3` long en `B.Cu`). Validation : options d'affectation des quatre couches chiffrées (occupation par couche, reprises de pistes, vias, continuité du plan sous `INPUT`, boucles de retour), une recommandation, arbitrage utilisateur obtenu et consigné dans `docs/architecture.md`.
  - [ ] F1.4-b Appliquer la stratégie retenue (reprises de routage éventuelles, zones, vias de couture et thermiques sous `U1`/`Q301`), remplir les zones. Validation : 0 non-connecté, DRC sans `clearance`/`shorting_items`/`track_dangling`/`courtyards_overlap`, parité 3, zones remplies sans îlot non relié.
- [ ] F1.5 Vérifier l’absence de ratsnest et les longueurs/vias inutiles critiques.
- [x] F1.6 Vérifier au schéma le découplage d'entrée du buck `U1` : aucun condensateur sur `BUCK_VIN` après `D3` (`C2`–`C4` côté `PVDD`). Validation : capacité locale VIN du LM5010 présente au schéma et au PCB, ou absence justifiée par la fiche technique.
  - [x] F1.6-a Diagnostic, lecture seule. *(PASS : `BUCK_VIN` = `U1.10`, `D3.1` (Schottky série anti-retour), `R2.2`, aucun condensateur ; le plus proche, `C11` 10 nF, est à ~15,6 mm de piste derrière `D3`, boucle ≈ 27 mm. Ajout requis.)*
  - [x] F1.6-b Ajouter le découplage d'entrée selon SNVS376F (Table 2, §8.2.2.1.5, §8.2.2.1.9, §Layout) : `C327` 0,1 µF 100 V X7R (rôle C5, au plus près de `U1.10`) et `C328` 2,2 µF 100 V X7R 1210 (rôle C1, boucle `C1`–`VIN`–`SW`–`L1`–`COUT` minimale), tous deux entre `BUCK_VIN` et `GND`, `GND` direct vers l'EP de `U1` sans via. Eq. 18 à 48 V, `R_ON` 182 k, 0,5 A : ≥ 0,33 µF pour ΔV 1 V. Étapes : schéma + ERC, propagation F8 (« Supprimer les empreintes sans symbole » décoché), placement, routage. Validation : ERC sans nouvelle erreur, 126 empreintes, parité 3, `pad_prop_heatsink` = 1, aucune `clearance`/`shorting_items`/`courtyards_overlap`, non-connectés tous `GND`, pistes existantes identiques par UUID hormis reprises déclarées.

### Validation

Routage terminé, zones remplies, contraintes critiques inspectées.

# Phase G — Validation PCB

## G1 — DRC et design review

### Objectif

Prouver la carte routée par un DRC final et une revue de manufacturabilité, écarts résiduels assumés et documentés.

### Dépendances

F1 validée.

### Tâches

- [ ] G1.1 Exécuter DRC et archiver le résultat.
- [ ] G1.2 Revoir courts-circuits, alimentations, masses, découplages, puissance et thermique.
- [ ] G1.3 Corriger via MCP, relancer DRC et le workflow de design review.
- [ ] G1.4 Établir la revue manufacturabilité et les écarts résiduels.

### Validation

DRC final et design review documentés après corrections.

# Phase H — Revue électronique et livrables

## H1 — Revue audio/électronique indépendante

### Objectif

Vérifier par le calcul ce qu'ERC et DRC ne voient pas — gain, headroom, impédances, coupures, courants, dissipation — et dire honnêtement ce qui n'est pas vérifié.

### Dépendances

G1 validée ou état final PCB explicitement PARTIAL.

### Tâches

- [ ] H1.1 Vérifier par calcul gain, headroom, impédances, coupures, LC, courants et dissipation.
- [ ] H1.2 Classer preuves : KiCad, documentation, calcul/simulation, non vérifié physiquement.
- [ ] H1.3 Documenter bruit/EMI/stabilité/thermique non mesurés et toute divergence TI.

### Validation

Rapport honnête, traçable, distinct d’ERC/DRC.

## H2 — Produire BOM, rapports et benchmark MCP

### Objectif

Livrer les artefacts exploitables du projet et le retour d'expérience mesuré sur la stack MCP, sans métrique inventée.

### Dépendances

H1.

### Tâches

- [ ] H2.1 Générer BOM et livrables exploitables disponibles.
- [ ] H2.2 Collecter métriques MCP observables, erreurs, retries, limitations et `NEEDS_DATA`.
- [ ] H2.3 Vérifier la présence de tous les livrables demandés.
- [ ] H2.4 Émettre les huit statuts finaux et `PRÊT À FABRIQUER` avec preuves.

### Validation

Livrables présents dans le workspace et rapport final sans métrique ni performance inventée.
