nevenfo/tpA3255-hifi-amplifier/reports/HifiAmp_TPA3255-debug.png

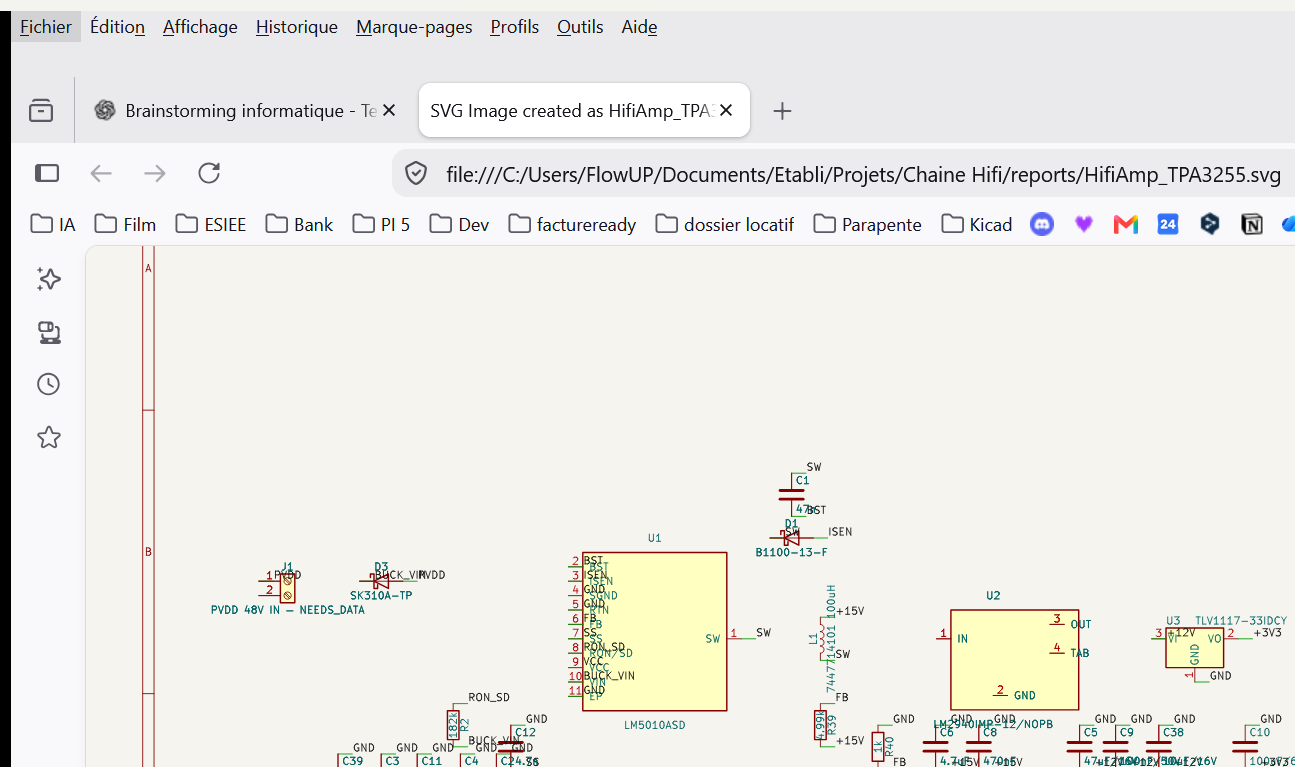
reports/HifiAmp_TPA3255-debug.png
