nevenfo/tpA3255-hifi-amplifier/HifiAmp_TPA3255.kicad_pcb

## KiCad design HifiAmp_TPA3255.kicad_pcb (2026-10-17)

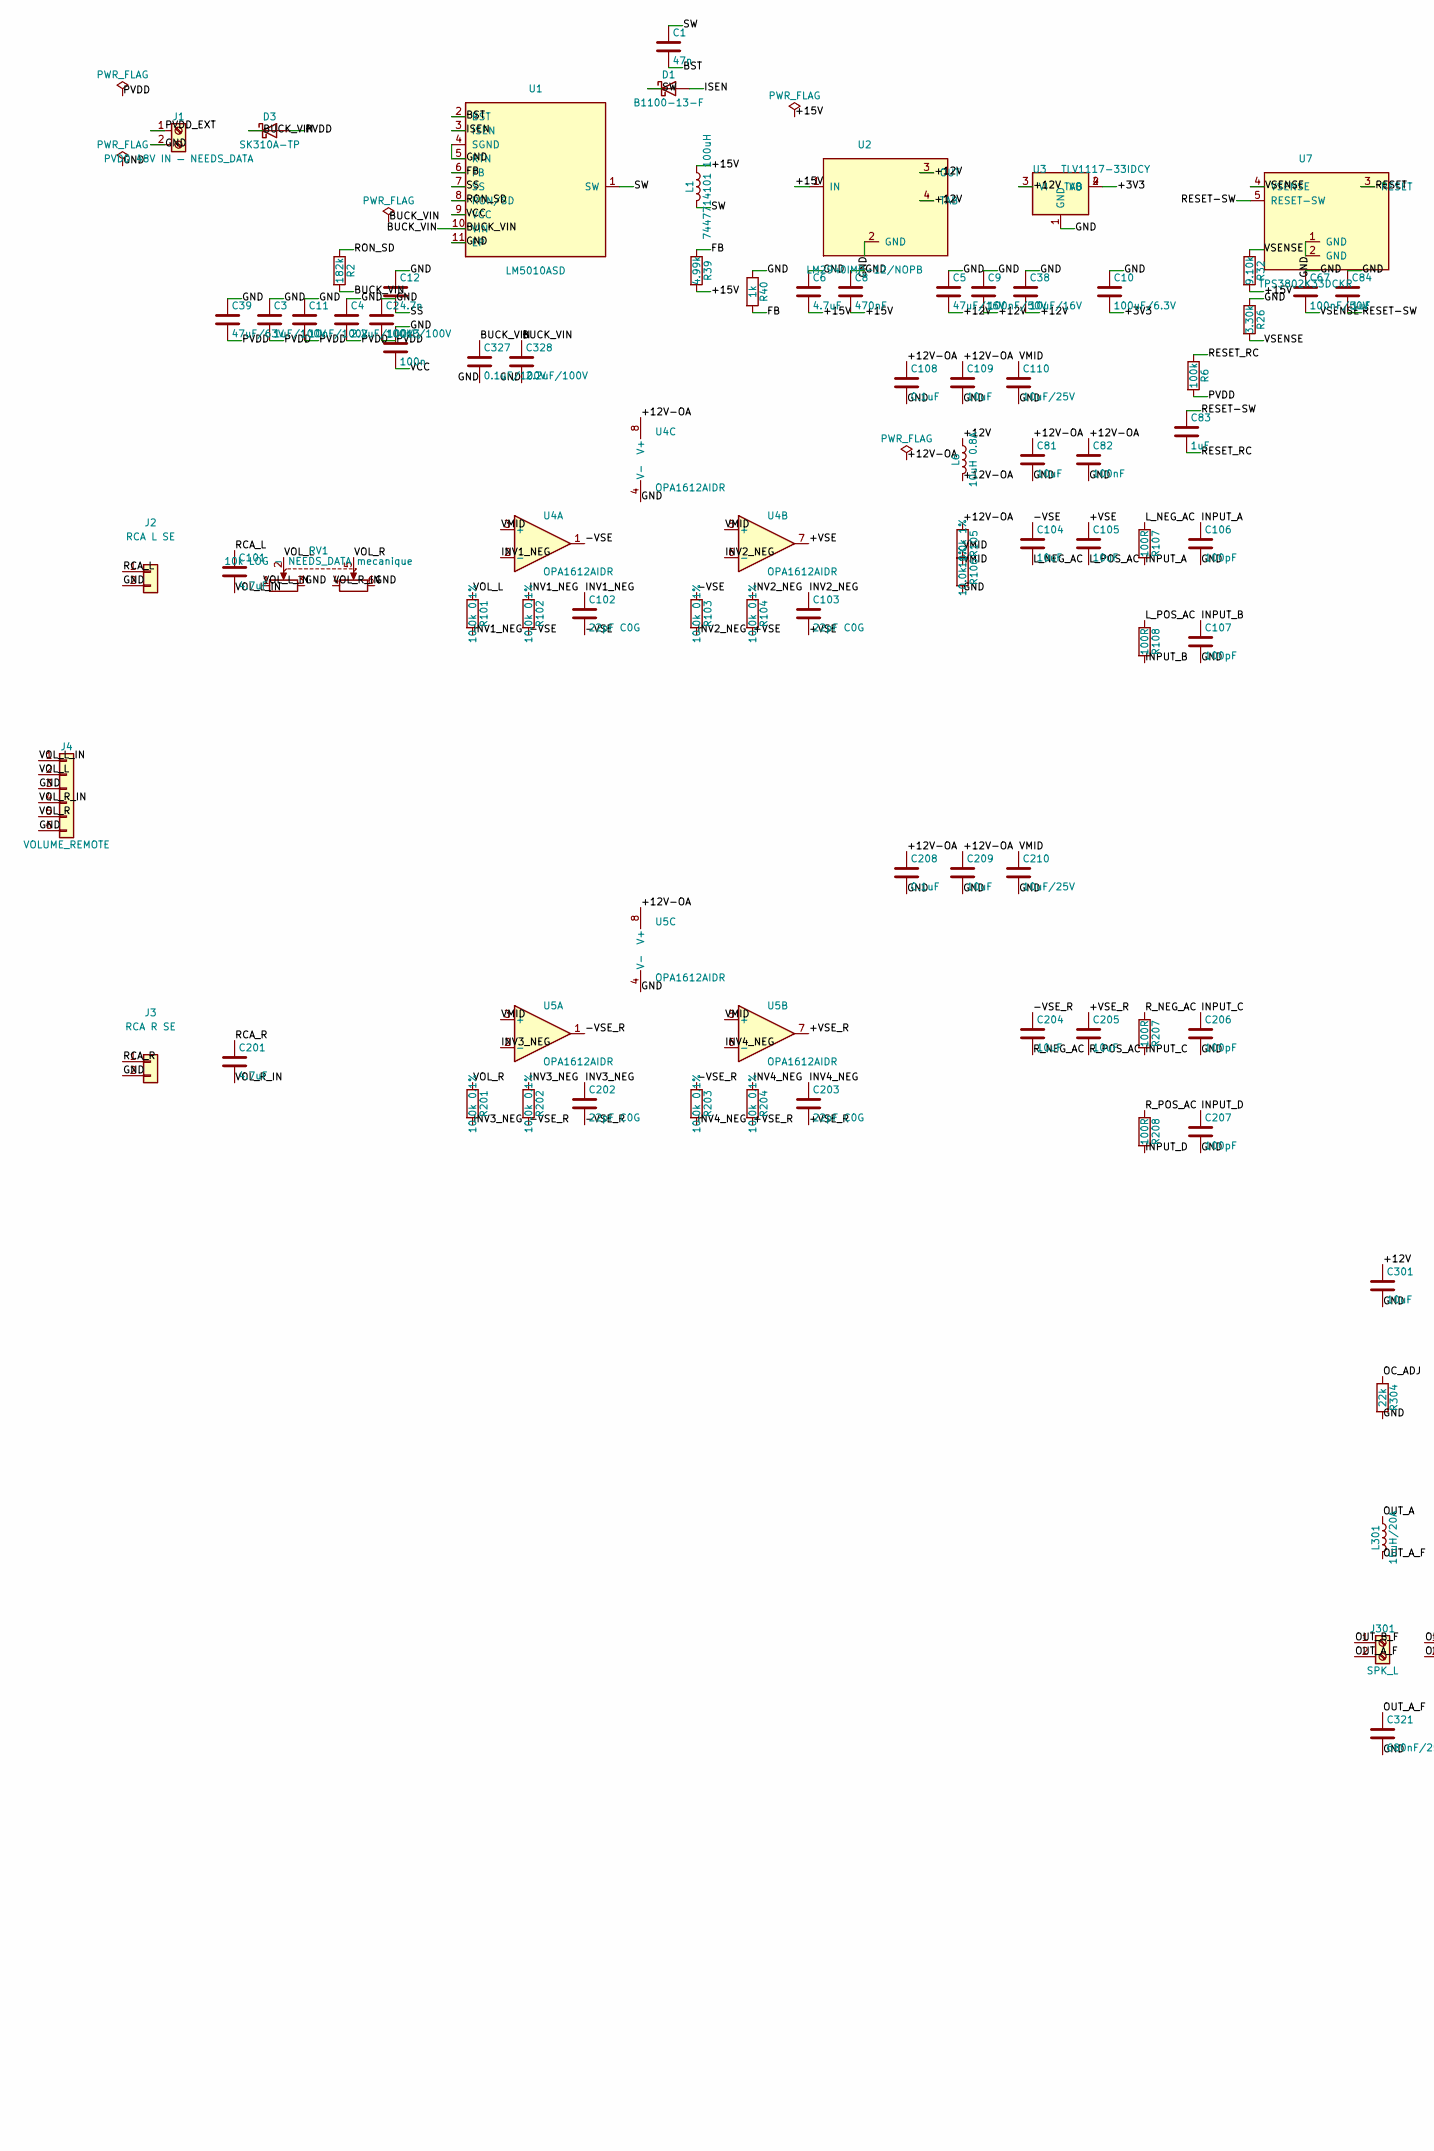
[picture p2: schematic HifiAmp_TPA3255.kicad_sch, part in row 1, column 1]

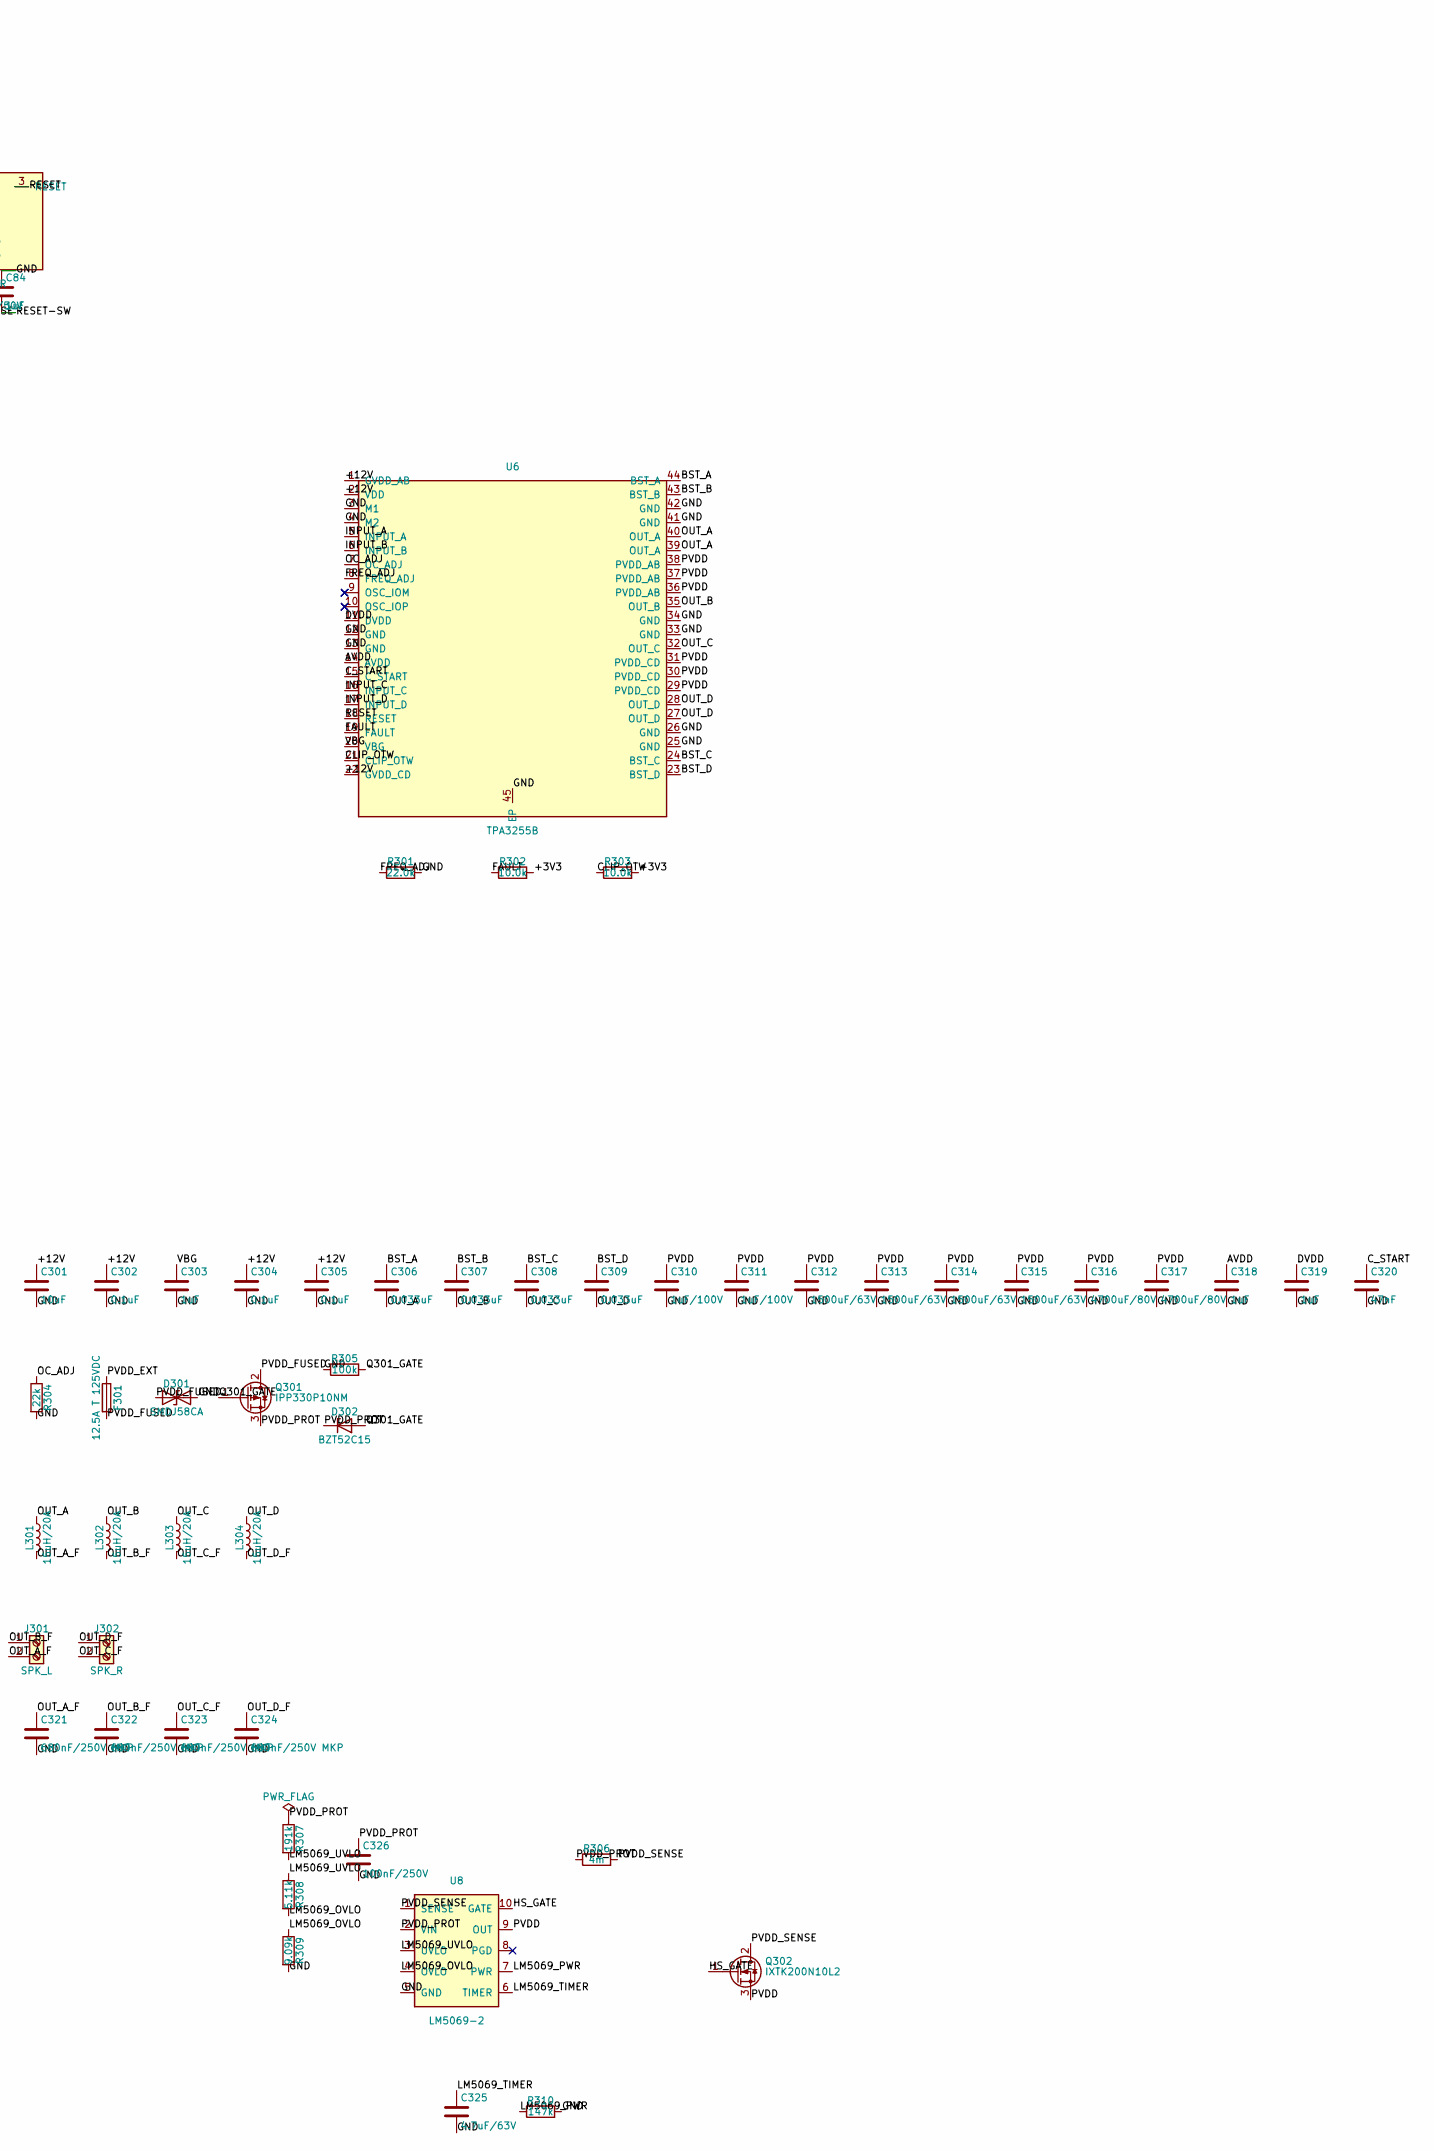
[picture p3: schematic HifiAmp_TPA3255.kicad_sch, part in row 1, column 2]

Parts:
C1: 47n; C_0603_1608Metric
C2: 100nF/100V; C_1206_3216Metric
C3, C310, C311: 1uF/100V; C_1210_3225Metric
C4: 2.2uF/100V; C_1812_4532Metric
C5: 47uF/16V; C_1210_3225Metric
C6, C101, C201: 4.7uF; C_0805_2012Metric
C8: 470nF; C_0805_2012Metric
C9, C67: 100nF/50V; C_0805_2012Metric
C10: 100uF/6.3V; C_1210_3225Metric
C11: 10nF/100V; C_0805_2012Metric
C12: 4.7n; C_0603_1608Metric
C13: 100n; C_0603_1608Metric
C38: 10uF/16V; C_0805_2012Metric
C39: 47uF/63V; CP_Radial_D8.0mm_P3.50mm
C81, C104, C105, C109, C204, C205, C209, C301: 10uF; C_0805_2012Metric
C82: 100nF; C_0805_2012Metric
C83, C84, C303, C318, C319: 1uF; C_0805_2012Metric
C102, C103, C202, C203: 22pF C0G; C_0603_1608Metric
C106, C107, C206, C207: 100pF; C_0603_1608Metric
C108, C208, C302, C304, C305: 0.1uF; C_0603_1608Metric
C110, C210: 10uF/25V; C_0805_2012Metric
C306, C307, C308, C309: 0.033uF; C_0603_1608Metric
C312, C313, C314, C315: 1500uF/63V; CP_Radial_D18.0mm_P7.50mm
C316, C317: 4700uF/80V; CP_Radial_D35.0mm_P10.00mm_SnapIn
C320: 47nF; C_0603_1608Metric
C321, C322, C323, C324: 680nF/250V MKP; C_Rect_L18.0mm_W8.0mm_P15.00mm_FKS3_FKP3
C325: 4.7uF/63V; C_Rect_L7.2mm_W11.0mm_P5.00mm_FKS2_FKP2_MKS2_MKP2; MPN MKS2C044701O00KSSD
C326: 100nF/250V; C_1206_3216Metric
C327: 0.1uF/100V; C_0603_1608Metric
C328: 2.2uF/100V; C_1210_3225Metric
D1: B1100-13-F; D_SMA
D3: SK310A-TP; D_SMA
D301: SMDJ58CA; D_SMC; MPN SMDJ58CA
D302: BZT52C15; D_SOD-123; MPN BZT52C15
F301: 12.5A T 125VDC; Fuse_Schurter_UMT-H_5.3x16mm; MPN 3403.0285.11
J1: PVDD 48V IN — NEEDS_DATA; TerminalBlock_MaiXu_MX126-5.0-02P_1x02_P5.00mm
J2: RCA L SE; JST_XH_B2B-XH-A_1x02_P2.50mm_Vertical
J3: RCA R SE; JST_XH_B2B-XH-A_1x02_P2.50mm_Vertical
J4: VOLUME_REMOTE; JST_XH_B6B-XH-A_1x06_P2.50mm_Vertical
J301: SPK_L; TerminalBlock_MaiXu_MX126-5.0-02P_1x02_P5.00mm
J302: SPK_R; TerminalBlock_MaiXu_MX126-5.0-02P_1x02_P5.00mm
L1: 7447714101 100uH; L_Wuerth_WE-PD2-Typ-MS
L6: 10uH 0.8A; L_Wuerth_WE-PD-Typ-M-Typ-S
L301, L302, L303, L304: 15uH/20A; L_Toroid_Vertical_L28.6mm_W12.3mm_P10.00mm_Coilcraft_PA6331
Q301: IPP330P10NM; TO-220-3_Vertical; MPN IPP330P10NM
Q302: IXTK200N10L2; TO-264-3_Vertical; MPN IXTK200N10L2
R2: 182k; R_0603_1608Metric
R6: 100k; R_0603_1608Metric
R26: 3.30k; R_0603_1608Metric
R32: 9.10k; R_0603_1608Metric
R39: 4.99k; R_0603_1608Metric
R40: 1k; R_0603_1608Metric
R101, R102, R103, R104, R201, R202, R203, R204: 10.0k 0.1%; R_0603_1608Metric
R105, R106: 10.0k 1%; R_0603_1608Metric
R107, R108, R207, R208: 100R; R_0805_2012Metric
R301: 22.0k; R_0603_1608Metric
R302, R303: 10.0k; R_0603_1608Metric
R304: 22k; R_0603_1608Metric
R305: 100k; R_0805_2012Metric
R306: 4m; R_2512_6332Metric; MPN WSL25124L000FEA
R307: 191k; R_0805_2012Metric
R308: 5.11k; R_0603_1608Metric
R309: 9.09k; R_0603_1608Metric
R310: 147k; R_0603_1608Metric
RV1: 10k LOG - NEEDS_DATA mecanique
U1: LM5010ASD; WSON-10-1EP_2.5x2.5mm_P0.5mm_EP1.2x2mm
U2: LM2940IMP-12/NOPB; SOT-223
U3: TLV1117-33IDCY; SOT-223
U4, U5: OPA1612AIDR; SOIC-8_3.9x4.9mm_P1.27mm
U6: TPA3255B; HTSSOP-44_6.1x14mm_P0.635mm_TopEP4.14x7.01mm
U7: TPS3802K33DCKR; SOT-353_SC-70-5
U8: LM5069-2; MSOP-10_3x3mm_P0.5mm

Connections:
/+3V3: C10.2, R302.2, R303.2, U3.2 (VO), U3.4 (TAB)
/+12V: C5.2, C9.2, C38.2, C301.1, C302.1, C304.1, C305.1, L6.1, U2.3 (OUT), U2.4 (TAB), U3.3 (VI), U6.1 (GVDD_AB), U6.2 (VDD), U6.22 (GVDD_CD)
/+12V-OA: C81.1, C82.1, C108.1, C109.1, C208.1, C209.1, L6.2, R105.1, U4.8 (V+), U5.8 (V+)
/+15V: C6.2, C8.2, L1.1, R32.2, R39.2, U2.1 (IN)
/+VSE: C103.2, C105.1, R104.2, U4.7
/+VSE_R: C203.2, C205.1, R204.2, U5.7
/-VSE: C102.2, C104.1, R102.2, R103.1, U4.1
/-VSE_R: C202.2, C204.1, R202.2, R203.1, U5.1
/AVDD: C318.1, U6.14 (AVDD)
/BST: C1.2, U1.2 (BST)
/BST_A: C306.1, U6.44 (BST_A)
/BST_B: C307.1, U6.43 (BST_B)
/BST_C: C308.1, U6.24 (BST_C)
/BST_D: C309.1, U6.23 (BST_D)
/BUCK_VIN: C327.1, C328.1, D3.1 (K), R2.2, U1.10 (VIN)
/CLIP_OTW: R303.1, U6.21 (CLIP_OTW)
/C_START: C320.1, U6.15 (C_START)
/DVDD: C319.1, U6.11 (DVDD)
/FAULT: R302.1, U6.19 (FAULT)
/FB: R39.1, R40.2, U1.6 (FB)
/FREQ_ADJ: R301.1, U6.8 (FREQ_ADJ)
/GND: C2.1, C3.1, C4.1, C5.1, C6.1, C8.1, C9.1, C10.1, C11.1, C12.1, C13.1, C38.1, C39.1, C67.1, C81.2, C82.2, C84.1, C106.2, C107.2, C108.2, C109.2, C110.2, C206.2, C207.2, C208.2, C209.2, C210.2, C301.2, C302.2, C303.2, C304.2, C305.2, C310.2, C311.2, C312.2, C313.2, C314.2, C315.2, C316.2, C317.2, C318.2, C319.2, C320.2, C321.2, C322.2, C323.2, C324.2, C325.2, C326.2, C327.2, C328.2, D301.2 (A2), J1.2, J2.2, J3.2, J4.3, J4.6, R26.1, R40.1, R106.2, R301.2, R304.2, R305.1, R309.2, R310.2, RV1.3, RV1.6, U1.4 (SGND), U1.5 (RTN), U1.11 (EP), U2.2 (GND), U3.1 (GND), U4.4 (V-), U5.4 (V-), U6.3 (M1), U6.4 (M2), U6.12 (GND), U6.13 (GND), U6.25 (GND), U6.26 (GND), U6.33 (GND), U6.34 (GND), U6.41 (GND), U6.42 (GND), U6.45 (EP), U7.1 (GND), U7.2 (GND), U8.5 (GND)
/HS_GATE: Q302.1 (G), U8.10 (GATE)
/INPUT_A: C106.1, R107.2, U6.5 (INPUT_A)
/INPUT_B: C107.1, R108.2, U6.6 (INPUT_B)
/INPUT_C: C206.1, R207.2, U6.16 (INPUT_C)
/INPUT_D: C207.1, R208.2, U6.17 (INPUT_D)
/INV1_NEG: C102.1, R101.2, R102.1, U4.2 (-)
/INV2_NEG: C103.1, R103.2, R104.1, U4.6 (-)
/INV3_NEG: C202.1, R201.2, R202.1, U5.2 (-)
/INV4_NEG: C203.1, R203.2, R204.1, U5.6 (-)
/ISEN: D1.2 (A), U1.3 (ISEN)
/LM5069_OVLO: R308.2, R309.1, U8.4 (OVLO)
/LM5069_PWR: R310.1, U8.7 (PWR)
/LM5069_TIMER: C325.1, U8.6 (TIMER)
/LM5069_UVLO: R307.2, R308.1, U8.3 (UVLO)
/L_NEG_AC: C104.2, R107.1
/L_POS_AC: C105.2, R108.1
/OC_ADJ: R304.1, U6.7 (OC_ADJ)
/OUT_A: C306.2, L301.1, U6.39 (OUT_A), U6.40 (OUT_A)
/OUT_A_F: C321.1, J301.2, L301.2
/OUT_B: C307.2, L302.1, U6.35 (OUT_B)
/OUT_B_F: C322.1, J301.1, L302.2
/OUT_C: C308.2, L303.1, U6.32 (OUT_C)
/OUT_C_F: C323.1, J302.2, L303.2
/OUT_D: C309.2, L304.1, U6.27 (OUT_D), U6.28 (OUT_D)
/OUT_D_F: C324.1, J302.1, L304.2
/PVDD: C2.2, C3.2, C4.2, C11.2, C39.2, C310.1, C311.1, C312.1, C313.1, C314.1, C315.1, C316.1, C317.1, D3.2 (A), Q302.3 (S), R6.2, U6.29 (PVDD_CD), U6.30 (PVDD_CD), U6.31 (PVDD_CD), U6.36 (PVDD_AB), U6.37 (PVDD_AB), U6.38 (PVDD_AB), U8.9 (OUT)
/PVDD_EXT: F301.1, J1.1
/PVDD_FUSED: D301.1 (A1), F301.2, Q301.2 (D)
/PVDD_PROT: C326.1, D302.1 (K), Q301.3 (S), R306.1, R307.1, U8.2 (VIN)
/PVDD_SENSE: Q302.2 (D), R306.2, U8.1 (SENSE)
/Q301_GATE: D302.2 (A), Q301.1 (G), R305.2
/RCA_L: C101.1, J2.1
/RCA_R: C201.1, J3.1
/RESET: U6.18 (RESET), U7.3 (RESET)
/RESET-SW: C83.1, C84.2, U7.5 (RESET-SW)
/RESET_RC: C83.2, R6.1
/RON_SD: R2.1, U1.8 (RON/SD)
/R_NEG_AC: C204.2, R207.1
/R_POS_AC: C205.2, R208.1
/SS: C12.2, U1.7 (SS)
/SW: C1.1, D1.1 (K), L1.2, U1.1 (SW)
/VBG: C303.1, U6.20 (VBG)
/VCC: C13.2, U1.9 (VCC)
/VMID: C110.1, C210.1, R105.2, R106.1, U4.3 (+), U4.5 (+), U5.3 (+), U5.5 (+)
/VOL_L: J4.2, R101.1, RV1.2
/VOL_L_IN: C101.2, J4.1, RV1.1
/VOL_R: J4.5, R201.1, RV1.5
/VOL_R_IN: C201.2, J4.4, RV1.4
/VSENSE: C67.2, R26.2, R32.1, U7.4 (VSENSE)

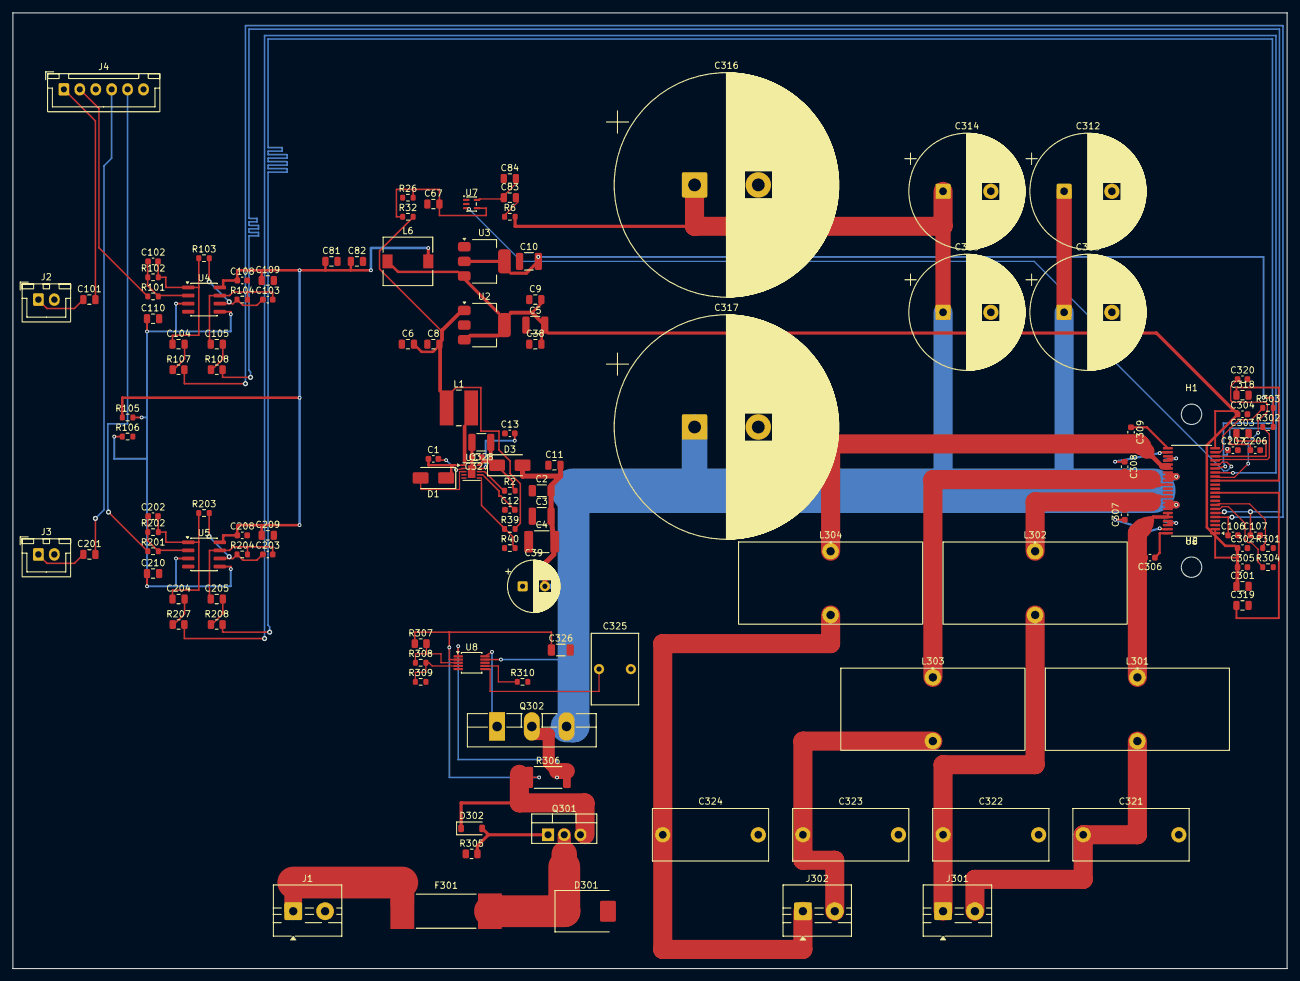
[picture p4: board HifiAmp_TPA3255.kicad_pcb from above]

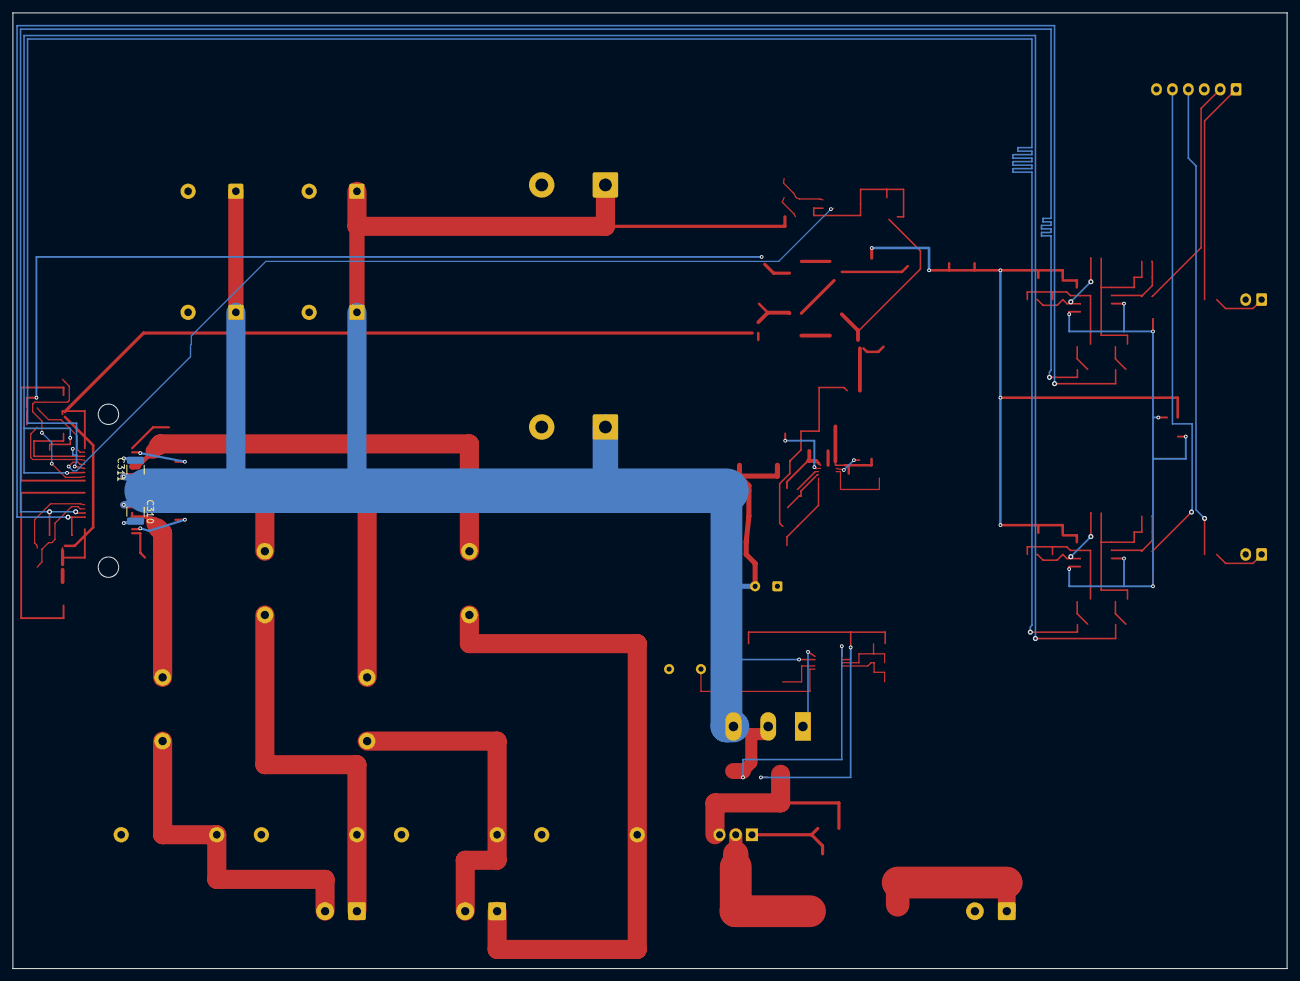
[picture p5: board HifiAmp_TPA3255.kicad_pcb from below]

Board: 4 copper layers, 200.0 x 150.0 mm, 126 parts (2 on the bottom side), 71 nets.

Other parts of the board:
H1, H2: MountingHole_3.2mm_M3
