nevenfo/tpA3255-hifi-amplifier/(commit log)

2026-08-27 chore: initialize KiCad benchmark continuity
2026-08-27 docs: checkpoint blocked KiCad MCP capture
2026-08-31 docs: validate power, LC filter and protection capture (B1.6)
    Claude-Session: https://claude.ai/code/session_01Nr6hv3b849MM4Vzin4rZtX
2026-08-31 docs: complete schematic review, B1 done (B1.7)
    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
2026-08-31 docs: schematic ERC gate PASS, phase C complete (C1)
    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
2026-08-31 feat(footprints): assign 103/111 footprints, fix U6 PowerPAD (D1.1 partial)
    U6 (TPA3255DDV) carried Package_SO:HTSSOP-44_..._TopEP4.14x7.01mm, which
    has 44 pads and no thermal pad, while the symbol declares pin 45 "EP" as
    power_in. Replaced with HTSSOP-44-1EP_..._EP5.2x14mm_Mask4.31x8.26mm,
    whose pad "45" is size 5.2 14 with property pad_prop_heatsink.
    All 21 distinct footprints verified resolvable on disk. Geometry
    unchanged (U6 at x=340.36 y=180.34, UUID stable); ERC still 0 errors /
    14 warnings.
    8 components remain unassigned, all blocked on undetermined physical
    part, none on tooling: J2/J3 (no RCA footprint exists in the 155 KiCad
    10.0 libraries), RV1, C110, C210, F301, D301, Q301.
    A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
    [HifiAmp_TPA3255.kicad_pcb, HifiAmp_TPA3255.kicad_sch]
2026-08-31 docs: source the 48 V protection block, no passive TVS fits (B2 prep)
    TVS avalanche clamp factor is 1.3-1.6; this rail needs 65/48 = 1.354,
    the extreme low end of the technology. SMCJ48A and even the 7 kW
    load-dump SLD8S48A both clamp at 77.4 V, well past the TPA3255 65 V
    absolute maximum. Overvoltage protection must therefore be active.
    Also records the Q301 gate-clamp correction, inrush/SOA analysis,
    hot-swap controller candidates and 48 VDC-rated fuse options.
    Plan gains B2 (post-gate schematic rework) and C2 (mandatory ERC
    re-gate); D1 now depends on C2 PASS.
    Claude-Session: https://claude.ai/code/session_01NbP75MQx5stMnq6BjDMVex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
2026-08-31 docs: size the LM5069 stage from SNVS452G, SOA is the hard point (B2.4)
    Thresholds R1/R2/R3 = 191k/5.11k/9.09k give OVLO 56.4 V cutoff, 59.9 V
    worst case, 5.1 V under the TPA3255 65 V absolute maximum. Rsns 4 mohm,
    Rpwr 147k, Ctimer 3.9 uF, with t_flt,min > t_start,max verified worst
    case against worst case (1.30x).
    Equations validated against the TI worked example before use (Eq.9
    reproduces 14.90 kohm exactly; PWRLIM-1 cross-check 303 W vs 300 W).
    The SOA requirement is structural: P_LIM x t_flt tracks the bulk charge
    energy regardless of tuning, so 15400 uF demands 389 W linear-mode for
    318 ms from the pass MOSFET.
    Claude-Session: h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
2026-08-31 feat(schematic): remote RV1/J2/J3, fix Q301 into a correct P-MOS (B2.1-B2.4)
    J2/J3 become Conn_01x02 for chassis-mounted RCA, J4 (Conn_01x06) carries
    the six volume nets for the remote pot, and Q301 is requalified from
    N-MOS to P-MOS with a proper gate network (R305 100k to GND, D302 15 V
    zener).
    The first correction wired the P-MOS source upstream. A P-MOS body diode
    has its anode on the drain, which must therefore sit upstream to conduct
    in the normal direction; wired the other way the diode goes forward
    during a polarity reversal and the protection does nothing. Verified
    after fix by reading the symbol geometry: S carries PVDD, D carries
    PVDD_FUSED, D302 cathode on PVDD. ERC cannot see t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
    [HifiAmp_TPA3255.kicad_sch]
2026-08-31 feat(schematic): capture the LM5069 hot-swap block, C2 gate PASS (B2.6)
    Inserts the active protection between Q301 and the bulk:
    PVDD_FUSED -> Q301 -> PVDD_PROT -> R306 4m -> PVDD_SENSE -> Q302 -> PVDD.
    U8 is an LM5069-2 with the Option A threshold divider (191k/5.11k/9.09k),
    Rpwr 147k, Ctimer 3.9uF and a VIN bypass. The LM5069 symbol had to be
    created locally: the stock library variants type TIMER as a plain input,
    which is wrong for a pin that charges and discharges a capacitor.
    Two ERC-invisible defects fixed:
    - D301 sat upstream of F301. A TVS fails short, so upstream of the fuse
    it can short the source with no fuse able to clear it. Now on
    PVDD_FUSED, downstream of F301.
    - PWR_FLAG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
    [HifiAmp_TPA3255.kicad_sch]
2026-08-31 feat(protection): freeze Q302, F301 and D301 on read SOA curves (B2.5, B2.7)
    Q302 = IXTK200N10L2, the only candidate whose guaranteed SOA covers the
    389 W / 318 ms the 15400 uF bulk imposes. The obvious IXTH64N10L2 misses
    by 1.8x: this bulk needs a die three times larger than 4.6 A suggests.
    SOA curves are images, so both web searches came back empty on the one
    number that mattered. Read them instead by extracting the PDF vector
    paths and calibrating on the axis labels. Validated three ways: IDM
    recovers as 140.2 A against 140 A in the table, and on all four
    datasheets the derived value lands within 1% of the tested "Safe
    Operating Area Specification" line.
    IXYS publishes the curve at TC =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
    [HifiAmp_TPA3255.kicad_sch]
2026-08-31 fix(protection): D301 must be bidirectional, and Q301 was over-constrained
    Two corrections to the block just frozen.
    Q301 is not held to VDS >= 100 V by the D301 clamp. During a clamp its
    gate is held 15 V below its source by R305 and D302, so it conducts and
    its VDS stays near zero. What the clamp does impose is 93.6 V on the
    node, hence on U8 VIN, which is the 88 V ceiling analysis and stands.
    Q301's real requirement is reverse blocking at 56 V plus margin.
    Chasing that surfaced a real defect: a unidirectional TVS with its anode
    on GND forward-conducts the moment the supply is connected backwards. It
    shorts the source and blows F301, which defeats the whole point of Q301.
    Switched to SMD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
    [HifiAmp_TPA3255.kicad_sch]
2026-08-31 fix(schematic): Q301/Q302 pinout was wrong, and freeze Q301 (B2.9, B2.10)
    Both transistors carried a *_GSD symbol, which declares pin 2 as Source.
    Both parts actually chosen put the Drain on pin 2, the tab: IPP330P10NM
    in TO-220-3 and IXTK200N10L2 in TO-264. Carried to the PCB that swaps
    drain and source on both, leaving the body diode permanently forward
    biased and neither the reverse protection nor the hot swap working. ERC
    is blind to this: pin numbering means nothing to it.
    Moved to Q_PMOS_GDS and Q_NMOS_GDS. The fix is geometrically neutral,
    checked in Transistor_FET.kicad_sym before applying: both variants place
    G at (-5.08, 0), D at (2.54, 5.08) and S at (2.54, -5.08), only the
    numbe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
    [HifiAmp_TPA3255.kicad_sch]
2026-08-31 feat(footprints): assign D301, Q301 and Q302, and redo the missing list
    Diff is three lines: only the Footprint fields change.
    Re-inventorying the schematic turned up more gaps than the plan recorded.
    The LM5069 programming network and the gate clamp added in B2.3, B2.4 and
    B2.6 were never assigned footprints at all: C325, C326, D302 and R305
    through R310. Sixteen parts are still unassigned, not eight.
    One of them is not routine: R306 is the 4 mOhm shunt, carrying 4.6 A
    continuously and up to 15.4 A while the LM5069 limits. It needs a real
    power shunt part and footprint, not a generic passive. Opened as D1.5.
    Claude-Session: https://cl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
    [HifiAmp_TPA3255.kicad_sch]
2026-09-01 feat(footprints): close D1.5, and correct an invented part number
    The protection block passives are assigned: R305 through R310, C325, C326
    and D302. C110 and C210 went with them. Four parts are left unassigned,
    all of them D1.4 work: F301, J2, J3, J4. RV1 is not one of them, it is
    deliberately off-board.
    Three defects were found in the initial pass and fixed.
    C325 carried MKS2C044701O00KSSD. That part does not exist: "O" is not a
    WIMA tolerance code and no distributor lists it. It is now
    MKS2B044701K00KSSD, 4.7 uF / 50 V / 10 %. The 63 V part that does exist
    is a 20 % part and had to be rejected: it drops the startup margin to
    1.25x, under the 1.30x this design holds itself to. Tolerance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
    [HifiAmp_TPA3255.kicad_sch]
2026-09-01 feat(footprints): close D1.1 and D1.4, every part now has a footprint
    The remaining four parts are assigned. J2, J3 and J4 needed a decision
    rather than data, and the user picked JST XH at 2.5 mm. What decides it
    is keying, not size: J4 carries six conductors including two grounds,
    and a volume harness reconnected backwards after a teardown would put
    the pot input on ground and its wiper on the input. That is a silent
    fault, no damage, hard to find. A screw terminal cannot prevent it.
    F301 needed a local footprint, since Fuse_Schurter_UMT250 targets
    3 x 10.1 mm against 5.3 x 16 mm here. Web search returned the numbers
    from Schurter's pad drawing but could not attribute them to any
    dimension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
    [HifiAmp_TPA3255.kicad_sch]
2026-09-01 fix(schematic): annotate the five PWR_FLAG symbols (D1.6)
    They carried "?" instead of #FLG0x, and that was not cosmetic. Unannotated,
    they were exported into the netlist as six real components named "?", which
    "Update PCB from schematic" would have tried to place on the board with no
    footprint. Annotated #FLG01 through #FLG05, they are now excluded like any
    "#"-prefixed symbol. #PWR001, a sixth pre-existing PWR_FLAG, was left alone.
    What unblocked the write: edit_schematic_component takes a uuid parameter as
    an alternative to reference. That is what resolves the ambiguity when several
    symbols share one designator, and it is worth reusing.
    Connectivity is provably untouched. Netlists export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
    [HifiAmp_TPA3255.kicad_sch]
2026-09-01 fix(schematic): keep RV1 off the board through on_board, not a decoy (B2.8)
    RV1 is the volume potentiometer, wired to the chassis through J4 since B2.1.
    It must never be placed on the PCB, and KiCAD spells that `(on_board no)` on
    the symbol block. No MCP tool could write it, so an earlier session left a
    custom property named `exclude_from_board` instead: a field KiCAD lists among
    the symbol's fields and reads nowhere. "Update PCB from schematic" would still
    have placed RV1.
    Both halves are now done for real. `(on_board yes)` became `(on_board no)`, and
    the ten lines of the `exclude_from_board` property are gone. What unblocked the
    write is Konnect v1.1.4: `edit_schematic_component` takes `i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
    [HifiAmp_TPA3255.kicad_sch]
2026-09-01 fix(schematic): restore the real WIMA part for C325 and widen its footprint (D1.7)
    D1.5 had rejected MKS2C044701O00KSSD as an invented part, reading the "O"
    as a tolerance code. It is not one. A WIMA part number puts the box and
    pitch in fields 11-12 and the tolerance in field 15 alone, so the "O" is
    the second character of box code 1O and the tolerance is the "K" in KSSD.
    The rejected part is the real one, and its replacement is the invented
    one: B0 is not a WIMA voltage code (MKS2 spans 63 to 630 VDC with no 50 V
    rating) and box 1K, 7.2 x 13 mm, only holds 2.2 uF.
    Reading the catalogue also breaks the dimension assumption. At 5 mm pitch
    the constant of the MKS2 series is the LENGTH, 7.2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
    [HifiAmp_TPA3255.kicad_sch]
2026-09-01 docs(d1.2): verify Q301 against the datasheet, and open D1.10 on the inductors
    Q301 checks out. Tables 2 and 3 of the Infineon sheet, read by page
    render since the PDF carries no text layer, confirm -6.9 A at RthJA
    40 C/W, RthJC 0.5 C/W, VGS +/-20 V. Two conditions in note 2 were never
    recorded and are placement constraints: the 6 cm2 of copper belong to the
    DRAIN net specifically, and the figure assumes the board standing
    vertical in still air. Two cross-checks fall out: the 15 V gate Zener
    sits inside +/-20 V and beyond the -10 V of the RDS(on) spec, and
    4.6 A^2 x 33 mOhm is exactly the 0.70 W already retained.
    D1.10 opens on L301-L304, the third footprint placed on an assumption
    after D1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
2026-09-01 docs(d1.2): record what the package audit has cleared so far
    Q301, Q302 and U8 check out against their datasheets. U8 is worth a note:
    TI ships the LM5069 only as a 10-pin VSSOP (DGS) with no exposed pad, and
    KiCad has no VSSOP-10 footprint, so MSOP-10_3x3mm_P0.5mm is the right
    choice rather than an approximation. The orderable part number is
    LM5069MM-2/NOPB, which the schematic does not carry yet.
    Claude-Session: https://claude.ai/code/session_019Lx21MypvErSrEbffS7PFZ
2026-09-01 fix(schematic): give the four 1500 uF bulks the diameter the EVM actually uses (D1.11)
    C312 to C315 carried CP_Radial_D16.0mm_P7.50mm. The TPA3255EVM bill of
    materials, which docs/architecture.md names as the anchor for this bulk,
    lists EEU-FC1J152 in an 18 mm diameter can. The footprint was 2 mm too
    narrow -- the fourth footprint in this project resting on a dimension that
    was assumed rather than read.
    C316 and C317 came out clean: the EVM lists SLPX472M080H3P3, "D35 mm x
    L30", the CDE type SLP part-number key resolves H3 to 35 x 30 mm, and the
    CDE mounting-hole drawing prescribes a 10.0 mm pitch with two 2.0 mm
    holes -- so the KiCad 2.0 mm drill is the prescribed hole, not a zero
    clearanc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
    [HifiAmp_TPA3255.kicad_sch]
2026-09-01 fix(schematic): put the output-filter films on the box WIMA actually sells (D1.9)
    C321 to C324 carried a 5 mm pitch footprint for a 7.2 x 3.5 mm body. Both
    figures were wrong. The TPA3255EVM bill of materials settles the dielectric
    first: the EVM uses a KEMET PHE426HB7100JR06, metallized polypropylene,
    1 uF/250 V on a 17.5 mm pitch. The WIMA MKP4 catalogue then contradicts the
    assumption that no MKP exists below 250 V -- the series starts at 100 VDC --
    and lists 0.68 uF in an 8 x 15 x 18 mm box on a 15 mm pitch, the same box at
    100 and at 250 VDC. 250 V costs nothing mechanically, so it is what we take.
    The four caps move to Capacitor_THT:C_Rect_L18.0mm_W8.0mm_P15.00mm_FKS3_FKP3,
    a standard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
    [HifiAmp_TPA3255.kicad_sch]
2026-09-01 feat(schematic): settle the output inductors on a real part (D1.10, D1.12)
    L301 to L304 carried Inductor_SMD:L_Wuerth_HCI-1350 with no MPN behind it,
    and the stored-energy argument said that can was about half the size the
    job needs. The TPA3255EVM bill of materials points at Coilcraft's MA5172-AE,
    and that datasheet (document 943) lists PA6331-AE in the same family:
    15 uH, 31 mOhm DCR, 20 A Isat, 9.8 A Irms at a 20 C rise. That is our spec
    sheet, on a part built for TI Class-D stages. Taken on the user's call.
    The real part is a 28.6 x 12.3 mm through-hole toroid standing upright, not
    a 12.8 mm SMD can. The datasheet drawing is not to scale -- 2.836 pt/mm in
    the front view against 2.463 in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
    [HifiAmp_TPA3255.kicad_sch]
2026-09-01 docs(d1.2): close the package audit on the terminal block's own drawing
    J1 was the last open item. LCSC's www and datasheet hosts refuse curl, but
    wmsc.lcsc.com serves the file, and the CIXI MAIXU drawing for MX126-5.0
    answers it: 300 V/10 A to UL, 250 V/15 A to IEC, 26-14 AWG wire. Our 4.6 A
    continuous sits 2.2x inside the UL figure and the 10 A transient stays under
    the IEC one.
    The drawing carries no text layer and pdftoppm is not installed here, so it
    was rendered to PNG at 200 dpi with pymupdf and read as an image. Its PCB
    layout also confirms the footprint at source: 1.30 mm holes on a 5.00 mm
    pitch, exactly what the KiCad part uses.
    One assembly constraint follows for phase E: the 4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
2026-09-01 fix(schematic): put U6 on the package the TPA3255 actually ships in (D1.3)
    U6 carried HTSSOP-44-1EP_..._EP5.2x14mm, which is tagged Texas_DDW0044B --
    a different package. It puts a 45th pad, 5.2 x 14 mm, underneath the chip.
    The TPA3255 is DDV0044D, and the datasheet says plainly that its PowerPAD
    "is located on the top side of the device for convenient thermal coupling
    to the heat sink". TI's own land pattern shows 44 pads and nothing to
    solder underneath; the package outline gives the exposed pad as 7.01 x 4.14
    mm nominal, not 5.2 x 14.
    So the task inverts: there are no thermal vias to design under this part.
    The numbers say it outright -- RthetaJC(bot) is listed n/a, while RthetaJA
    drops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
    [HifiAmp_TPA3255.kicad_sch]
2026-09-01 docs(d1.14): clear the five lib_symbol_mismatch warnings of any real defect
    The question behind these five was whether any of them hid a pinout
    difference, which would have undermined verification work already done.
    It does not. Both copies of each symbol -- the schematic's lib_symbols
    cache and the .kicad_sym -- were compared by S-expression tree equality
    with only the root name neutralised, and they are identical leaf for leaf:
    330, 169, 192, 307 and 1112 leaves respectively. Pin numbers, names,
    electrical types and positions all agree.
    The format-version lead was tested and disproved. Schematic and library
    are both written by konnect but at 20250610 and 20240108. Upgrading a copy
    of the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
2026-09-01 docs(d1.13): close the 53.5-56.4 V window on a supply spec, not on the LM5069
    The window was real but the framing was wrong twice over, and the datasheet
    settles both points.
    53.5 V is a Recommended Operating Conditions bound, not an absolute maximum.
    SLASEA8A table 7.1 puts PVDD_X to GND at 69 V, not the 65 V this repo has been
    carrying since B2.4. The band therefore sits 12.6 V below destruction, and note
    (1) of table 7.3 names the mechanism: output current, not voltage withstand.
    Lowering V_OVH cannot work. Guaranteeing <= 53.5 V worst case forces a nominal
    of 50.5 V, whose low bound reaches 49.5 V - under the 50.4 V a 48 V rail hits at
    +5 % - and whose recovery point, hysteresis deduct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
2026-09-01 fix(footprint): draw the fuse silkscreen around the body, not the pads (D1.8)
    The report that no MCP tool could edit footprint graphics after creation was
    wrong: set_footprint_graphics exists. D1.8 had been deferred on that belief.
    Two defects cleared. The pin-1 marker is gone - it had no meaning on a fuse and
    sat outside the courtyard at x = -9.3 anyway. The silkscreen framed the pad
    envelope instead of the body, leaving 0.09 mm to the pads; it is now two
    horizontal segments over x in [-4.70, 4.70] at y = +/-2.675. F.Fab follows the
    real 15.4 x 5.35 mm body, without the pin-1 chamfer.
    Verified against the file rather than on the agent's word: 0.240 mm silk-to-pad
    clearance against the 0.2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
2026-09-01 docs(e1): settle copper weight before E1.1, and close out Phase D's stale flags
    The fuse note warned the input rail had to approach 7.5 mm in 140 um copper or
    be derated. Instructed, it costs nothing.
    7.5 mm / 140 um is an IEC 60127 measurement condition, quoted as such in the
    Schurter datasheet, not a design requirement. IPC-2221 asks only 2.47 mm of
    35 um outer copper for the 4.6 A rail at a 10 degree rise. And the coordination
    already established tolerates the fuse derating all the way to 7.4 A effective -
    41 percent - before the 9.3 A musical peak crosses 1.25 x In, where the
    pre-arcing table guarantees 60 minutes.
    Thick copper would in fact be harmful: 140 um cannot hold the 0.235 mm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
2026-09-01 feat(pcb): lay the 4-layer stack, global rules and 8 net classes (E1.1)
    F.Cu signal, In1.Cu power, In2.Cu mixed, B.Cu signal on a 1.6 mm board. Eight
    net classes and 71 assignments, no duplicates, sized on IPC-2221 at 35 um and a
    10 degree rise: 2.50 mm floor on the 48 V rail against the 2.47 mm the 4.6 A
    needs, 3.00 mm on the outputs. Global rules kept conservative since no fab is
    chosen: 0.20 mm track and clearance, 0.60 mm via, 0.30 mm drill, 0.15 mm
    annulus.
    Two choices in there do not follow from the table. The 0.50 mm clearance on the
    power nets is sized on the 93.6 V peak of a D301 clamp, not on 48 V nominal. And
    PVDD_SENSE sits in SENSE rather than PWR_48V on purpose: it is the tap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
    [HifiAmp_TPA3255.kicad_pcb]
2026-09-01 docs(e1.6): price the heatsink requirement, and find the interface is the hard part
    The heatsink NEEDS_DATA could not be closed without outside data, but it could
    be quantified. This turns an empty field into a purchase criterion.
    U6's dissipation is read off figure 10 of SLASEA8A by vector extraction, the
    plot checked to scale on two independent tick pairs per axis: 22.4 W at
    2 x 100 W into 8 ohm, 37.4 W into 4 ohm. The 22.4 W works out to 89.9 percent
    efficiency - exactly the 90 percent this project has assumed without proof since
    the beginning to derive the 4.6 A rail current. The curve confirms it.
    The main finding is that the heatsink is not the hard part. The PowerPAD is only
    29.02 m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
2026-09-01 docs(e1.7): find the heatsink is the chassis, and that spreading was missing
    Three findings, two of which correct E1.6.
    The EVM's own heatsink fails the requirement. ATS-TI1OP-519-C1-R3,
    named in SLOU441's BOM, publishes no zero-airflow figure at all and
    bottoms out at 2.2 C/W under 1 m/s of forced air -- 102 C of case
    against 75 targeted. What survives is its mechanics: two M3 threaded
    holes, 36.8 mm apart, bolted from under the PCB.
    Spreading resistance was missing from the budget. The 22.4 W enter
    through 29 mm2, which costs 0.411 C/W at best into an aluminium base.
    A catalogue RthSA target of 1.0 C/W was therefore only right when the
    part was characterised on a component-sized source;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
2026-09-01 docs(e1.7): validate two of the three undecoded references at the source
    SLPX472M080H3P3 decodes field by field against the Cornell Dubilier
    key: 4700 uF, 20%, 80 V, case H3 = 35 x 30 mm, polarised, PVC sleeve.
    ESR 0.071 ohm max, ripple 4.12 Arms min. The 30 mm height carried
    since D1 is confirmed -- which was not a given: the SLP catalogue,
    opened first, offers only 30x45 and 35x35 at 4700 uF/80 V, both
    taller. It is the separate SLPX catalogue that carries the short can.
    Worth knowing: SLPX is the 85 C series, not the 105 C one that SLP is.
    Flagged for review in H1 against the real internal ambient.
    MKP4F036804F00 is confirmed at 0.68 uF, 18 x 8 x 15 mm on 15 mm
    pitch. Its four trailing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
2026-09-02 feat(e1.2): populate the board from the schematic, and find U3's tab floating
    The three arbitrations that blocked E1.2 were already rendered and committed
    in docs/architecture.md; progress.md had simply not caught up. Edge.Cuts now
    carries the agreed 200 x 150 mm outline at (100,100)-(300,250), and the 122
    footprints are in with their connectivity: 122 distinct references, no
    duplicate, 74 nets, 327 of 332 pads netted. RV1 stays out on purpose, being
    the only symbol without a footprint. Two stray unlinked U6 footprints that
    sat in the working tree are gone, absorbed by the sync.
    Proven at the file and by kicad-cli pcb drc: schematic_parity is 0, so the
    board mirrors the schematic exactly, a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
    [HifiAmp_TPA3255.kicad_pcb]
2026-09-02 feat(e1.2): place the Class-D power block, and turn the heat bar on its edge
    U6 lands at (285,175) rotated 180, with its four bootstrap caps, the two 1210
    PVDD decouplers, the eight low-level decouplers and the six bulk cans. The
    rotation is not free: the HTSSOP-44's two flanks are not interchangeable -
    all the low-level pins sit on one side and all the power on the other, six
    PVDD, OUT_A-D, four BST, six GND. Turning the power inward, toward the bulk
    and the future LC filter, is the only orientation that works, and it leaves
    the low-level pins to escape into the right-hand margin.
    Verified at the file rather than taken on trust: the board's MD5 changed, so
    the save really happened; all 21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
    [HifiAmp_TPA3255.kicad_pcb]
2026-09-02 fix(e1.8): give U3's tab a net by stacking a fourth pin on the output
    The SOT-223 tab was floating because the stock Regulator_Linear:TLV1117-33
    symbol declares three pins where the DCY package has four. A local
    TLV1117_33_FIXED now carries a fourth pin, TAB, typed passive and placed at
    exactly the same coordinates and length as pin 2, VO. U3 points at it without
    moving: same position, same UUID, same Reference, Value and Footprint.
    Stacking rather than a separate anchor is deliberate, and it departs from the
    LM2940IMP_12_FIXED precedent on purpose. The tab is electrically the same node
    as the output, so stacking connects it with no wire and no label - and above
    all with no anchor coordinat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
    [HifiAmp_TPA3255.kicad_pcb, HifiAmp_TPA3255.kicad_sch]
2026-09-02 docs(e1.2): propose the bar's M3 fixing pattern before drilling it in
    Two M3 clearance holes at (285,163) and (285,187), 24 mm apart, straddling U6
    across the bar's axis. Checked clear of every placed component and pad - the
    low-level decouplers sit at x >= 291.5, the bootstrap caps at x <= 274.2.
    It follows that the bar ends in a widened foot on the U6 side, the 10 mm blade
    opening to about 30 mm across x 280 to 291 to carry two tapped M3 holes at the
    same spacing. Two screws rather than one, so the pressure on the PowerPAD is
    spread instead of letting the bar pivot.
    Recorded as a proposal rather than applied. Unlike turning the bar on its
    edge, which the geometry forced, this one is a fr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
2026-09-02 feat(e1.2): close the placement by drilling the bar's two M3 holes
    H1 at (285, 163) and H2 at (285, 187), 24 mm apart, straddling U6 —
    the pattern the user picked over the 30 mm and three-point variants.
    The MCP's add_mounting_hole tool got it wrong twice. It hard-codes the
    fpid MountingHole:MountingHole_3.2mm, which no library holds, and it
    writes (size 3.7 3.7) against a (drill 3.2): an np_thru_hole wider than
    its drill carries a floating 0.25 mm copper ring on every layer, right
    where the screw and the bare aluminium bar clamp down. The real library
    footprint places (size 3.2 3.2), so no copper at all. Both holes were
    replaced through IPC with that footprint.
    Verified at the file: 124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
    [HifiAmp_TPA3255.kicad_pcb]
2026-09-02 feat(e1.9): scope the fine-pitch clearance to the footprint that imposes it
    The 42 clearance violations never opposed two footprints — they opposed
    two pads of one package, at a gap the component's pitch fixes and no
    placement can change. HTSSOP-44 leaves 0.235 mm, WSON-10 and MSOP-10 go
    down to 0.150 mm, all below the 0.25/0.50 mm the net classes ask for.
    One rule in a new HifiAmp_TPA3255.kicad_dru allows 0.15 mm, but only
    between two pads of the same footprint among U1, U6 and U8. Custom rules
    live in that file, not in the .kicad_pro's design_settings.rules, which
    only holds numeric minima — the plan said otherwise and is corrected.
    min_clearance turned out not to clamp a custom rule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
2026-09-07 feat(e1.3): fan the four output filters out of the chip's ten-millimetre flank
    The four OUT pins leave U6 on a single flank across barely eight
    millimetres, so any arrangement of the toroids has to open them into a
    fan. Putting the channels in rows rather than columns keeps OUT_A next
    to OUT_B and OUT_C next to OUT_D — each BTL pair adjacent, its loop
    short — and cuts the switched-node length mismatch between channels
    from 44 mm to 18. On nodes that swing 48 V at ~450 kHz that length is
    what matters, ahead of perfect left-right symmetry.
    The rear edge is settled at y = 250 as a consequence, not a preference:
    the bulk is frozen across y 119..182, so a 48 V inlet at y ~ 105 would
    have dra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
    [HifiAmp_TPA3255.kicad_pcb]
2026-09-07 feat(e1.3): walk the 48 V inlet across the board in the order it conducts
    J1 -> F301 -> D301 -> Q301 -> R306 -> Q302, laid out bottom-left to
    upper-right so the chain reads in the direction the current actually
    flows and PVDD leaves the hot-swap MOSFET 30 mm from the bulk instead
    of 47. The TVS sits after the fuse, not before it, so a shorted clamp
    still blows F301.
    The LM5069's high-impedance programming network — R307/R308/R309 for
    UVLO/OVLO, R310 for the power limit, C325 for the timer — is gathered
    against U8 rather than strung along the power path, and C326 decouples
    PVDD_PROT at the chip.
    Proven: DRC unchanged at 90 violations, all silkscreen (80 overlap,
    10 over_copper), no clea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
    [HifiAmp_TPA3255.kicad_pcb]
2026-09-07 docs: separate the durable know-how from the snapshot that must stay small
    progress.md had drifted into a second manual: how to drive KiCad's IPC, which
    MCP tools lie, how to read the file format, every placement constraint and every
    open NEEDS_DATA. None of that is state — it survives the task that produced it,
    so it belongs where it can be read once rather than rewritten at every
    checkpoint. The KiCad know-how moves to docs/kicad-operations.md, the placement
    constraints and the three missing NEEDS_DATA to docs/architecture.md.
    The snapshot itself was also wrong: it still called E1.3 "not started" while two
    E1.3 commits were already pushed. Git wins. E1.3 is now recorded as two thirds
    do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
2026-09-07 feat(e1.3): stack the auxiliary supply up the strip PVDD already reaches
    The LM5010 buck and everything downstream of it — 24 footprints — go in a
    column at x 158..186, y 134..194. That strip is free between the 48 V input
    chain, which stops at y ~199, and the top of the board; it touches U8/Q302
    where PVDD leaves the hot-swap, and it keeps x 100..155 clear for the low-level
    analog of E1.4, at the edge opposite U6.
    U1 stays at rotation 0. SW and BUCK_VIN leave the WSON-10 on the same edge, so
    no orientation puts the input at the bottom and the output at the top; the
    output's run up to U2 then U3 wins, and PVDD — a quiet DC rail — takes the
    detour. R39/R40, the feedback divider, sit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
    [HifiAmp_TPA3255.kicad_pcb]
2026-09-07 feat(e1.3): close the placement with supervision, and date a regression
    U7 and its network — R32/R26/C67 on VSENSE, R6/C83/C84 on RESET_RC — take the
    band reserved under U3 at x 156..184, y 122..134.
    U6's four configuration pins all leave the same flank at x = 288.71, across
    y 168.97..177.86 — squarely inside the bar's keep-out. Not one of them can take
    its resistor opposite the pin it serves. The keep-out is about pads and height,
    not about copper under soldermask, so the four sit in a column at x = 297,
    clear of both forbidden bands: the FAULT and CLIP_OTW pull-ups above, the
    FREQ_ADJ and OC_ADJ programming resistors below, each on the side its pin
    leaves from, at the price of 5 to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
    [HifiAmp_TPA3255.kicad_pcb]
2026-09-07 fix(e1.10): give U1 back the thermal-pad property the IPC move dropped
    Updating footprints from the libraries across the whole board, with all five
    text options left unchecked so no reference position is reset and no field is
    overwritten.
    pad_prop_heatsink is back to exactly one occurrence, on U1's pad 11 — the
    LM5010's exposed pad on /GND. It decides whether the zone fill connects that
    pad solid or through a thermal relief, and the stencil aperture, so it had to
    come back before any routing rather than be discovered in F1.4.
    The same pass takes all three lib_footprint_mismatch to zero: the other two
    were U2's and U3's silkscreen polygon, whose duplicated closing point had been
    dropped.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
    [HifiAmp_TPA3255.kicad_pcb]
2026-09-07 feat(e1.4): let the OPA1612's own pinout lay out the left channel
    U4 turns single-ended into differential: amplifier A takes the SOIC-8's left
    flank — pad 1 the output, pad 2 the inverting input, pad 3 VMID, pad 4 GND —
    and amplifier B the right flank, re-inverting A's output to make the opposite
    phase. So each feedback network stays on its own amplifier's side, R102/C102
    left between pads 1 and 2, R104/C103 right between pads 7 and 6. Only R103
    crosses the package, because it is the part that carries A's output to B's
    input; that traverse is the topology, not a placement mistake.
    C110 sits against U4 rather than between the channels. Splitting VMID into
    C110 and C210 was decided precis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
    [HifiAmp_TPA3255.kicad_pcb]
2026-09-07 feat(e1.4): mirror the left channel onto the right, and close the placement
    The last 21 footprints go down as a pure translation of the left channel,
    +40 mm in y and same x: U5 at (130, 185) against U4 at (130, 145), each
    series-200 satellite on its series-100 twin's homologue. C210 stays glued to
    U5 for the reason C110 stays glued to U4. C81/C82 close the +12V-OA rail
    downstream of L6, and J3/J4 leave through the front panel. Nothing crosses
    x = 156, where E1.3's auxiliary supply block starts.
    The translation is deliberate rather than convenient: it lets E1.5 judge
    inter-channel symmetry on measured geometry instead of on stated intent.
    The import block is now empty — all 124 footprints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
    [HifiAmp_TPA3255.kicad_pcb]
2026-09-07 feat(e1.5): measure the symmetry instead of asserting it, and find three gaps
    Read-only pass over the placement: positions and rotations pulled from the
    board file, pairs matched, deltas computed. Nothing written — the .kicad_pcb
    is byte-identical, which is what makes this measurement comparable to the one
    we will redo after correcting.
    What holds: all 18 analog pairs (U4/U5, the 16 1xx/2xx pairs, J2/J3) sit at
    exactly (0, +40, 0°) with no tolerance at all; L301/L303 and L302/L304 at
    (0, +17); C321/C323, C322/C324 and J301/J302 at (-22, 0).
    Three gaps, in rising order of cost:
    R105/R106 divide VMID for both channels, which is right — two dividers would
    put a common-mode offset betwee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
2026-09-07 fix(e1.5): measure the output paths, not their x offsets, and invert a conclusion
    The first pass compared only the x offsets of the output stage — 5.3 mm on one
    side, 41.3 mm on the other — and concluded the imbalance was purely intra-
    channel, with the two channels still comparable to each other. Measuring the
    actual centre-to-centre paths inverts that.
    Pad OUT -> inductor -> terminal, per bridge half: A 71.65, B 91.86, C 97.86,
    D 91.40 mm. So the right channel carries 189.3 mm against the left's 163.5 —
    25.7 mm more copper, about 16 %. The intra-channel spread is not uniform
    either: 20.2 mm on the left against 6.5 on the right. And neither pairing
    survives: A<->C drifts 26.2 mm by n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
2026-09-07 feat(e1.5): close the inductor question by measuring what fits, not what pairs
    The open question was whether to mirror the four output inductors about
    y = 175 like U6's pinout. Measuring their footprint closes it: they are
    Coilcraft PA6331 vertical toroids with a 29.10 x 13.10 mm courtyard.
    A single column of four would need 52.4 mm of y against the 42 mm free
    between U6's underside and the output MKPs — 116 mm if turned 90 degrees. A
    mirror about y = 175 is out too: the band above U6 belongs to the bulk, where
    C316/C317 are 35 mm snap-ins. So the 2 x 2 grid is imposed by size, not
    chosen. And in a 2 x 2 grid two inductors are necessarily near the flank and
    two far, since all four OUT pad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
2026-09-07 docs: record the session-wide input block that puts KiCad's IPC out of reach
    move_component only exists over IPC, IPC needs the PCB editor already open,
    and nothing in this session can open it: SetForegroundWindow, ui_click and
    keyboard navigation all fail, returning False with GetLastWin32Error = 0 or
    "SendInput was blocked". Context is an RDP session.
    Two independent channels were tried and both failed — physical coordinates,
    then semantic UIA. Only the SelectionItem pattern answers, over COM without
    SendInput, and it selects the tree entry without opening it; the project
    manager's launch pane is a Pane with no usable UIA pattern.
    The diagnosis worth keeping is the one-call test: try a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
2026-09-07 feat(e1.5): correct the two gratuitous asymmetries, and leave the third alone
    The mirror around y=175 makes summed ordinates the criterion, not distance, so
    C306 and C307 stay put and set the target their partners move to. C308, C309 and
    C311 now sum to 350; R105/R106 keep the shared VMID divider but sit midway
    between the channels, equalising both reference paths. The inductors' offset is
    left as it is: the 2x2 grid is forced by the courtyard, and the mismatch leaves
    as an F1 routing constraint instead.
    Five IPC moves, all in y. DRC reads 105 violations, every one silkscreen, with
    no clearance and no courtyards_overlap — which is what validates the tightest
    3.0 mm pitch, since a hand-rol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
    [HifiAmp_TPA3255.kicad_pcb]
2026-09-07 feat(e1.5): measure the current returns, and find the mirror was half applied
    The previous slice mirrored the bootstrap positions but not their orientations,
    so C308 and C309 sit reversed: U6's pinout mirrors around y=175, which flips the
    BST/OUT order between halves, and four capacitors all at 90 degrees cannot all be
    right. Proven by segment intersection, not by area — on a crossed quadrilateral
    the shoelace formula returns the difference of the lobes and ranks the worst case
    best, which is how the first pass got it backwards.
    Two more findings leave E1.5's scope. Both speaker terminals take the right-hand
    signal on their left-hand pin, worth 8.7 mm a channel to swap, but that is a
    sche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
2026-09-07 feat(e1.5): finish the mirror by rotating the two reversed bootstraps
    C308 and C309 go from 90 to 270 degrees with no move at all: the centres stay
    identical to the micron, so the sums to 350 from the corrective slice survive
    untouched. C306 and C307 stay as they are — rotating them would cross them.
    The crossing test replayed over the six capacitors around U6 now returns zero
    crossings, so no bootstrap loop needs a via. DRC holds at silkscreen only, with
    no clearance and no courtyards_overlap.
    Worth knowing for later checks: the IPC writes this orientation as -90 rather
    than 270. Equivalent modulo 360, but a check looking for the literal 270 would
    report a failure that is not there.
    Co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
    [HifiAmp_TPA3255.kicad_pcb]
2026-09-07 feat(e1.5): close the review by decomposing the silkscreen count, and close E1
    The 106 silkscreen violations are really two: C312/C313 and C314/C315 alone
    produce 73 of the 87 overlaps, and 15 of the 19 silk-over-copper are reference
    fields printed onto a pad. None touches copper, so the fix is cosmetic and
    belongs after F1 — routing moves the offending fields anyway.
    The tight clearances are all inside packages (0.200 mm on U1, 0.235 on U6),
    fixed by the part maker and already covered by E1.9's rule; between components
    the minimum climbs to 0.950 mm. All 124 footprints sit on F.Cu, so a single
    placement pass, with 24 through-hole parts all power or connectors.
    Second method trap recorde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
2026-09-07 feat(e1.11): swap the terminal pins, and find the parity check never ran
    The four labels move at J301 and J302 and nowhere else — L301-L304 and C321-C324
    keep their nets, which is the check that matters, since swapping there would
    have undone the correction. ERC holds at 16 warnings and no error.
    The larger finding came from validating it. schematic_parity is an opt-in flag
    on kicad-cli pcb drc, and the JSON field reads 0 when the test did not run, so
    every "schematic_parity = 0" this project recorded as proof meant "not measured".
    The real baseline is 3, all explainable: U6's pin 45 has no pad because the
    TPA3255 PowerPAD sits on top of the package, and H1/H2 are mounting holes with
    no s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
    [HifiAmp_TPA3255.kicad_sch]
2026-09-07 feat(e1.12): move the input capacitors to the load end of a 160 mm run
    The four 100 pF anti-aliasing caps now sit 3.5 to 6.5 mm from U6's input pins
    instead of 160, with their 100 ohm series resistors left where they were — the
    correct topology, and the noise picked up crossing the power zone now shunts to
    ground right before the chip rather than never.
    The corridor is narrow because the two reserved zones compose: below x=291 the
    whole y 160-190 band is closed, and up to x=300 the y 169-181 band is too — and
    the input pins land squarely in the second. Only x>=291.5 with y outside
    [169,181] was left.
    Symmetry is redefined, not lost: these four now follow U6's pinout mirror, with
    C106+C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
    [HifiAmp_TPA3255.kicad_pcb]
2026-09-08 feat(e1.11): propagate the pin swap to the board, and close phase E
    The swap had been in the schematic since the last session; the board was
    behind it. Parity goes from 7 to 3 — the four extra gaps were exactly the
    terminal pads — and the intersection test now finds no crossing on either
    block, against two before. Nothing else moved: 124 footprints intact to the
    micron, pad_prop_heatsink still on U1, lib_footprint_mismatch still 0.
    The block was never KiCad's. The RDP session had been disconnected, which
    neutralises SendInput for the whole desktop; reconnected, the gesture went
    through under automation with no manual step. Worth keeping: activating any
    unrelated window still tells the t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
    [HifiAmp_TPA3255.kicad_pcb]
2026-09-08 feat(f1.1): route the four bootstrap loops, the board's first copper
    Twelve segments on F.Cu, no via — the invariant the whole slice was built
    around, and the reason E1.5 removed the last crossing. Unconnected items go
    254 to 250, which is what proves the four links actually land on their pads
    rather than near them; the 112 silkscreen violations are unchanged and
    parity stays at 3.
    The GATE_DRIVE class width of 0.5 mm was not usable. U6's pads are
    1.575 x 0.4 mm on a 0.635 pitch, leaving 0.435 mm from a track axis to the
    neighbouring pad edge: against 0.25 mm clearance, 0.5 gives 0.185 and 0.4
    still gives 0.235. 0.35 gives 0.260 and passes. Bootstrap current is
    negligible and the board mi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
    [HifiAmp_TPA3255.kicad_pcb]
2026-09-08 docs(f1.1): find C310 mirrored in position but not in orientation
    C310 and C311 are U6's only PVDD decoupling caps and both sit at rotation
    90. The mirror about y=175 calls for opposite ones — E1.5 already settled
    that for the bootstraps, where C306/C307 are at 90 and C308/C309 at -90.
    architecture.md had checked these two only on position, 178.3 against
    171.7, which is the blind spot E1.5 named and did not revisit here.
    The cost is measurable against U6's nearest pads. C311 is right: PVDD faces
    pins 29-31, GND faces 25-26, 7.71 mm of loop and no crossing. C310 presents
    PVDD to U6's GND and the reverse, so its two runs cross — 9.04 mm and a via
    forced into the tightest loop a Class-D bo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
2026-09-08 feat(f1.1): turn C310 the right way round and route PVDD
    C310 rotates 90 to -90 without moving, and its pads trade nets: PVDD now
    sits at 176.825 facing U6 pins 36-38, which takes the decoupling loop from
    9.04 mm with a crossing down to 7.71 mm without — the same figure C311
    already had. PVDD then routes on F.Cu in four segments, no via, 0.8 mm
    inside the channel BST_B borders and 1.1 mm past x=279.9 where the
    bootstrap no longer runs, wide enough to cover all three pads at once.
    The audit the user asked for came back reassuring. Crossing position with
    orientation over the eight mirrored pairs, only three are discriminating —
    the ones whose rotation is neither 0 nor 180, the only angles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
    [HifiAmp_TPA3255.kicad_pcb]
2026-09-08 feat(f1.1): route the auxiliary rails, and prove VBG cannot cross
    AVDD, DVDD and +12V now reach their decoupling capacitors: 15 segments on
    F.Cu, no via, 0.30 mm wide. The class width of 0.8 mm was never an option at
    U6's 0.635 mm pitch — 0.30 mm leaves 0.285 mm of clearance where 0.25 is
    required, and the classes had to be read from .kicad_pro, not the .kicad_dru.
    A first attempt shorted six items: C106, C107, C206 and C207 sit in the
    corridor and were missing from the obstacle list. The DRC caught what the
    script did not. Those 14 segments were pulled and the geometry recomputed.
    VBG stays unrouted, and not for lack of trying. At U6 pin 22 comes before
    VBG; at the capacitors C303 comes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
    [HifiAmp_TPA3255.kicad_pcb]
2026-09-08 feat(f1.1): swap C303 and C304 so VBG no longer has to cross
    The crossing came from the order of the endpoints inverting between U6 and
    the capacitor row, so the endpoints are what moved: C303 takes y=166 and
    C304 takes y=163. The order now matches on both sides and VBG reaches its
    capacitor in a straight run — 4 segments, 14.0 mm at 0.25 mm — with +12V
    pin 22 following in 3 segments. Still no via anywhere on the board.
    Moving an 0805 into an 0603 row is fine here: both sit at 0 degrees, so the
    long axis runs in x and the row only grows 0.5 mm in y. The real obstacle
    was never the neighbouring part but the GND pads of C207 and C303, which a
    first route came within -0.125 mm of. The clea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
    [HifiAmp_TPA3255.kicad_pcb]
2026-09-08 chore(f1.2): allow a track to escape a U6 pad, on the terms already granted
    At 0.50 mm of PWR_OUT clearance, no track leaves OUT_B (pin 35) or OUT_C
    (pin 32) at all: those pads are single, flanked by GND and PVDD, and the
    0.635 mm pitch leaves only 0.435 mm between a pad axis and its neighbour's
    edge, so the widest admissible track is negative. OUT_A (39-40) and OUT_D
    (27-28) are double and cap at 0.505 mm, too little for a channel's 6 A.
    The threshold is the one E1.9 already accepted between two pads of this same
    package, and 0.235 mm already separates the OUT and PVDD pads of U6, which
    carry the same voltage: extending it to the track introduces no new voltage
    stress. Scope stays inside U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
2026-09-08 feat(f1.2-a): untangle the outputs, then route them at their class width
    The four filtered outputs could not be routed on F.Cu at all with the E1.5
    placement, and the obstacle was an order, not a width. At the filter caps the
    x-order was D, B, C, A; at the terminals, fixed by BTL pairing, it is D, C, B,
    A. B and C transposed force a crossing on any single-layer path, detours along
    the board edge included, since D must itself sweep the band to reach its cap at
    x = 202. This is exactly the interleaving E1.5 measured and handed to F1.
    The fix moves nothing new: L302 and L303 swap slots, C322 and C323 swap slots,
    identical parts into identical positions, rotations untouched. The cap order
    becom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
    [HifiAmp_TPA3255.kicad_pcb]
2026-09-08 docs(f1.2-b): measure the escape field, and find all four outputs walled in
    None of the four OUT nets can leave U6 on F.Cu at a usable width. The 8 mm
    between the power flank and the rest of the board already carries the whole
    Class-D decoupling, and the free windows in the C310/C311 column are 0.725 mm
    where OUT_A and OUT_D sit -- a negative track width at PWR_OUT clearance -- and
    a single 2.50 mm window that OUT_C and OUT_B must share, 0.50 mm each. A channel
    needs 3.00 mm for its 5 A; 0.50 mm carries 1.45 A and would run 168 C hot.
    Every way around is closed by measurement: BST_D bars the top across the whole
    flank, BST_A the bottom, and U6's body and exposed pad the right.
    Two causes.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
2026-09-09 docs(f1.2-b): take the decoupling to the back, and the vias to the weak signals
    The escape field was measured walled in, and three ways out were put to the
    user. The one taken is a fourth: C310/C311 move to B.Cu with vias under the
    PVDD/GND pins, which frees the whole x 276-279 column and *shortens* the
    decoupling loop rather than stretching it — its area becomes the 1.6 mm board
    thickness instead of the 7.71 mm plane run F1.1 had won. The structural
    BST_B x OUT_A crossing is cut separately, by one via on each BST: those are
    0.35 mm gate signals needing a single via, where a 5 A OUT would need four.
    The via goes on the weak side, never on the switching node.
    The price is that the board st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
2026-09-09 docs(ops): no MCP tool flips a placed footprint, and edit_component lies about it
    Searched find_capabilities for flip/mirror/change-side across all 203 tools:
    nothing. edit_component takes a `layer` field, returns no error, and leaves the
    footprint where it was — the same shape of silent failure as the (units) blocks
    and the schematic_parity zero. place_component does have a layer field, but it
    mints a fresh footprint with no net, so using it to flip an existing part would
    cut the part loose from the schematic. Flipping is a GUI gesture.
    Claude-Session: https://claude.ai/code/session_0154py8GygMHDLCEYkaWSFDf
2026-09-09 chore(f1.2-b1): record the flip as the one gesture no tool can make
    Pin coordinates for the PVDD groups are carried into progress.md so the gesture
    and its follow-up survive a context boundary: the IPC half of F1.2-b1 needs no
    human, only the flip does.
    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
2026-09-09 chore(f1.2-b1): shrink the snapshot back under its ceiling, losing nothing
    The snapshot had drifted to 991 words by carrying facts the docs already own —
    the class width at U6's pins, the (units) trap, the IPC-needs-the-editor rule,
    the busbar keepout. Those live in kicad-operations.md and architecture.md, so
    progress.md now points instead of repeating. The one fact it held alone — that
    OUT_B and OUT_C have a single pad each, per SLASEA8, and that this is the
    package and not a symbol defect — moves into architecture.md beside the escape
    measurement, where the asymmetry is visible and would otherwise be reopened.
    Claude-Session: htt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
2026-09-10 feat(f1.2-b1): flip C310 and C311 to the back, by tool rather than by hand
    The gesture that blocked this task was never available: no MCP tool returned a
    placed footprint to the other side, and edit_component accepted a layer field
    it silently ignored. Konnect v1.2.0 ships flip_component, so the flip is a tool
    call again — file-mode, refused while KiCAD holds the board, geometry mirrored
    the way KiCAD mirrors it.
    Proof is KiCAD's, not ours: kicad-cli pcb export pos reports C310 and C311 as
    bottom. The board md5 moves 2cc389a5..1bef -> 619eedd7..a1c1, 124 footprints
    preserved.
    The PVDD reroute through vias under U6 is the other half of f1.2-b1 and needs
    the running editor; it is not in th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
    [HifiAmp_TPA3255.kicad_pcb]
2026-10-17 feat(f1.2-b1): reroute C310/C311 decoupling through four vias, loop criterion still open
    C310/C311 are turned 180 deg on B.Cu so each pad faces its U6 pin; /PVDD and
    /GND now reach U6 through four vias. DRC is clean (no clearance, shorting or
    dangling), unconnected 232 -> 226, parity 3, 124 footprints, 119 (units.
    Measured with F1.1's metric, the loop is ~10.8 mm against the 7.71 mm target:
    the board crossings add to the planar path instead of replacing it. F1.2-b1
    stays open pending a decision. Also records that the KiCad API had to be
    enabled and that its socket is a named pipe on Windows.
2026-10-17 feat(f1.2-b1): slide C310/C311 under U6, decoupling loop 10.8 -> 9.63 mm
    User decision: the 7.71 mm loop target cannot be met with vias, so the two
    capacitors slide under U6 on B.Cu (x 280.75). Four tented vias at x 282.6,
    under the package body and east of the pins, since BST_B/BST_C block the
    west side for GND. 9.63 mm is the minimum without vias in pads.
    DRC clean (clearance, shorting, dangling, courtyard all 0), unconnected 226,
    parity 3, 124 footprints, 119 (units. F1.2-b1 checked with its revised loop
    criterion; the free-column check moves to F1.2-b2.
2026-10-17 feat(f1.2-b2): take BST_B/BST_C under the OUT row, free the escape column
    BST_B and BST_C dive to B.Cu with two vias each: a net that starts on an F.Cu
    pin and ends on an F.Cu SMD pad needs an even via count, so the planned
    "one via each" is revised to four in total. BST_A and BST_D go around on
    F.Cu at y 182.4 and 167.6 without vias. All at 0.35 mm.
    The F.Cu column x 276.15-278.85, y 168-182 is now empty. DRC unchanged:
    no clearance, shorting, dangling or courtyard errors, parity 3, unconnected
    226. Only the /BST_A../BST_D nets changed, no footprint touched.
2026-10-17 feat(f1.2-b3): route OUT_A..OUT_D to bootstraps and inductors, width criterion open
    All four switching nodes are routed on F.Cu without vias: unconnected
    226 -> 216, DRC clean, parity 3. The U6 escape DRU rule is shown to be
    selective: with U6 removed from its condition, 14 clearance errors appear,
    all OUT track to U6 pad, and none elsewhere.
    Left open: about 12 mm per net stays below 3.00 mm, partly outside the fine
    pitch (0.96-1.07 mm necks between the bootstrap pads), and OUT_D runs
    101 mm because L303/L304 sit 45 mm from U6. Pending a placement decision.
2026-10-17 chore(f1.2-c): plan the output-stage placement rework the user chose
2026-10-17 docs(f1.2-c1): choose the staggered-brick output placement (O1)
    A/B matched to 0.0 mm, C/D to 2.8 mm, OUT_D 101 -> 70 mm, no switching node
    under a toroid. Bootstraps go mirrored around y = 175 and out of the OUT
    bundle.
2026-10-17 feat(f1.2-c2): apply the staggered-brick output placement, reroute the stage
    The four toroids and the four bootstraps move to option O1 (C306 at 180 deg
    so its BST pad clears the OUT_A vertical); OUT_x, OUT_x_F and BST_A..D are
    rerouted, all OUT copper on F.Cu without vias.
    Bridge pairs now match: A/B 29.13/28.92 mm, C/D 68.27/71.89 mm (OUT_D was
    101 mm). Widths below 3.00 mm remain only at x >= 277.2, in U6's fine
    pitch and around its BST vias; every OUT_x_F is 3.00 mm. DRC clean,
    unconnected 216, parity 3, 124 footprints, 119 (units. The U6 escape rule
    is still selective: 11 clearance errors without it, all on U6. Closes F1.2.
2026-10-17 feat(f1.3-a): route the auxiliary buck U1 and the +12V/+15V/+3V3 rails
    Hot loop first, FB away from SW, VCC/BST hop to B.Cu. Unconnected 216 -> 186,
    DRC silk-only, parity 3. Opens F1.6 for the missing BUCK_VIN decoupling.
2026-10-17 feat(f1.3-b): route the power entry, LM5069 protection and ISEN
    Power path sized to 4.95 A nominal (up to 7 mm on B.Cu), Kelvin sense on
    R306, Q301 drain area kept free for F1.4. Selective 0.15 mm escape rules for
    U8 and U1. Unconnected 186 -> 147, DRC silk-only, parity 3.
2026-10-17 feat(f1.3-c): route the analog supplies with VMID equal on both channels
    +12V-OA, VMID star (equal to 0.01 mm between U4 and U5), +/-VSE and AC nets.
    Unconnected 147 -> 113, DRC silk-only, parity 3. F1.3-d now starts by moving
    +/-VSE out of the PWR_OUT class.
2026-10-17 feat(f1.3-d): route the analog signal path, move +/-VSE to the ANALOG class
    INPUT pairs matched (0.45 / 0.00 mm), channels translated by 40 mm, 24.6 mm
    from SW. Unconnected 113 -> 87, DRC silk-only, parity 3, prior copper
    unchanged by UUID.
2026-10-17 feat(f1.3-e): route the control nets, closing F1.3
    Everything but GND is routed. Three INPUT vias near U6 shrunk to 0.6/0.3 to
    free the control exits; INPUT_C/D stay matched to 0.10 mm. Unconnected
    87 -> 78 (all GND), DRC silk-only, parity 3. F1.6 is moved ahead of F1.4.
2026-10-17 feat(f1.6): add the LM5010A input decoupling C327/C328 next to U1
    The buck VIN had no local capacitor behind the series Schottky D3. Per
    SNVS376F, 0.1 uF + 2.2 uF 100 V now sit at 1.3 mm of U1.10 with ground
    straight onto the exposed pad. Parity 3, 78 GND left, ERC unchanged.
